mdanderson03/SpectrePlex/README.md

# AutoCIF
Automated Multiplex Microscope
