mdanderson03/SpectrePlex/Presentation/SpectrePlex Cycle Speed.pptx

## SpectrePlex Cycle Speed

## Time per Imaging Action

- Image acquisition time = exposure time + 170ms + 50ms (if change filter)
  - Exp time = exp time
  - Read off time = 85ms
  - Numpy Frame Size Conversion = 85ms (Converts from 1D array to proper XY dimensions)
  - Filter change = 50ms
- Filter change = 50ms
- Move Z position = 50ms
- Move XY position = 300ms
- Auto Exposure = 1 min for 16 tiles

Net Imaging Time per tile (Underestimates about 15%)
- 5 z stack
- Assume average exposure time of 500ms
- Lowest is average exp time = 50ms
- Highest is average exp time = 2000ms
500ms Average Exp (per tile about 0.35mm^2)
[((670 + 50) * 5) + 50] * 4 + 300ms + 4000ms per z stacked tile (all 4 colors) = 18.7 seconds
Lowest Average Exp (per tile)
[((220 + 50) * 5) + 50] * 4 + 300ms + 4000ms per z stacked tile (all 4 colors) = 9.9 seconds
Highest Average Exp (per tile)
[((2170 + 50) * 5) + 50] * 4 + 300ms + 4000ms per z stacked tile (all 4 colors) = 48.9 seconds
If Average Tissue = 16 tissue containing tiles (about 5.6mm^2)
500ms Average Exp (per tile)
16 * 14.7 + 1 min= 5.0 minutes
Lowest Average Exp (per tile)
5.9 * 16 + 1 min = 2.4 minutes
Highest Average Exp (per tile)
44.9 * 16 + 1 min= 13.0 minutes

## Time per Other Actions

- Wash = wash time + 3sec + 2 sec
  - Wash time = 36000/(flow rate in uL/min)
  - Flow rate stabile time = 3 secs
  - Valve select time = 2 seconds
- Stain = flow time + 3sec + 2 sec + incubation time
  - Flow time = 22500/(flow rate in uL/min)
  - Flow rate stabile time = 3 secs
  - Valve select time = 2 seconds
  - Incubation time = 2700 seconds w/o heater, 900 w/ heater
- Bleach = flow time + 3sec + 2 sec + incubation time
  - Flow time = 36000/(flow rate in uL/min)
  - Flow rate stabile time = 3 secs
  - Valve select time = 2 seconds
  - Incubation time = 180 seconds
Total Time per Cycle
- Do 1x Stain, 2x Wash and 1x Bleach per cycle
- W/o heater, stain inc time = 2700, w/ heater inc time = 900
- W/O Heater (46 min + 2*1.25 min + 4.25 min) = 53 min
- W/ Heater (16 min + 2*1.25 + 4.25 min) = 23 min

## Total Time Per Cycle

- I will break into 4 regimes (at avg of 500ms exposure time)
  1. w/o heater and acquire bleached images
  2. w/o heater and rolling ball bckgnd (no bleached images required)
  3. w/ heater and acquire bleached images
  4. w/ heater and rolling ball bckgnd (no bleached images required)
- Each cycle has 1x stained image acq + 1x set of fluidic exchanges + optional 1x bleached image acq
1. 5 min + 4 min + 53 min = 62 minutes
2. 5 min + 53 min = 58 min
3. 5 min + 4 min + 23 min = 32 min
4. 5 min + 23 min = 28 min

## Speed up Ideas

1. Bleach time will go down with heater on. It is untested, but it’s a pure chemical reaction. Going from 16C to 36C should increased bleach speed by 4x. 1 minute incubation time should be the projected bleach time with heater on
2. Sorger lab only does rolling ball background. Maybe it is ok to do that approach? That eliminates 4 minutes. Another option is to find the in focus images of the stained channel while bleaching is going on and only acquire the bleached image in that projected in focus position
3. Up flow rate to max value of 1000uL/min. This would save around 1.5 minutes
4. Test flat field of objective and increase to limit of when its focal plane bend is about 2um. Unknown how much frame size could be increased.
5. Swap to TTL triggered system. Takes lots of optimizing, but imaging can potentially be reduced by around 40-50 seconds for a 4 color, 5 stack, 16 tiles acquisition.
6. Could store numpy arrays in 1D format and convert to 2D while staining. This would save 27 seconds for a 4 color, 5 stack, 16 tiles acquisition.
7. Initial tile bounds may not be optimal. Since I know where tissue is and the size of each tile, I could auto recalculate the surface bounds in such a way to reduced the tile count to its absolute minimum for the desired tissue.

Theoretical Min time per cycle (500ms avg exp time) with bleached images if bolded were implemented heater on and got 15% more imaging area
- 4 min (stain image time) + 19.5 min (fluid and incubation time) + 3 min (bleached image time) = 26.5 min

## Other things to take into account

- 50% stain (S50) is at about 15 minutes. S75 is about 21 minutes
- That means 50% more photons per unit time when acquiring. So 333ms exp time would be needed instead of 500ms. That 170ms savings per image is about 2 minutes collectively between the stained and bleached image cycles for each cycle. Thus, it only took a net of 4 minutes to get the extra stain and not the 6 minutes that it appeared to be at first.
