mdanderson03/SpectrePlex/3D model/version logs and observations/heating element context and design.pptx

Heating element in housing with potting compound encasement

Tissue

Water

Glass Slide (Goal object to be heated)

Wire

Encasement Potting Compound

Goal: minimize distance between magnets and glass slide

Magnet

Magnet

Magnet

3D printed Plastic Housing

Hot melt potting

Link to encasement potting: https://www.mcmaster.com/7563A55/

Polyester base

PTC heating element

Automotive grade adhesive

## Slide 2

Heating element alone

Wire

Hot melt potting

Polyester base

PTC heating element

Automotive grade adhesive
