mdanderson03/SpectrePlex/3D model/version logs and observations/New Design thoughts for upcoming V4.2 design.docx

New Design thoughts

1. Like modular inner chamber design
2. Need something that doesn’t rust so hide or embed magnets
3. Need to restrict movement so some thick nickel based washer will work for socket
4. Embed magnets for pressure plate within plate and chamber and maybe inner chamber
5. Maybe pressure plate could be rim around entire fluidic device
6. Maybe magnets could be embedded into plastic socket and sealed with resin
