mdanderson03/SpectrePlex/Core Jobs.docx

Core Jobs

1. Equipment Trainings
2. Coordinate Trainings
3. Marking accounts as trained
4. Billing Program
5. Email correspondence with requests and advice/consultation/etc.
6. Refill consumables for microscopes (oil, wipes)
7. Delete files from LSM workstation
8. Coordinate repairs with service teams from Zeiss and Abberior
9. Website upgrades
10. ID card submission to lock shop

How to do Tasks

ID card submission

a) Enders 613-email Doug Ritchie at doug.ritchie@childrens.harvard.edu with the users name, ID number and badge number. I have all users fillout this form: https://research.childrenshospital.org/cfic-core/request-accesstraining
b) Enders 648: Same as above, but email Security.AccessControl@childrens.harvard.edu instead. Same form is used.

File deletion

Every file in drive E on LSM workstation is subject to deletion if it is over 30 days old.

Billing Program

Use python based CFIC billing program on raw CSV file from iLab that Alia generates. Upload processed folder into CFIC dropbox. Alia takes care of rest.

Consumables/Maintenance

1. Refill lens wipes and kim wipes for LSM 880, spinning disk and STEDYCON.
2. Refill sparkle on LSM 880, spinning disk and STEDYCON. Note we are out of sparkle and a case of new lens cleaner from Edmunds optics will be in soon.
3. Inspect LSM 63x and 10x objectives. Clean if needed.
4. Remove dust if becoming significant

Website Upgrades

Make website a place for all info and useful with live links. As of now, no distinct plan for material is set in place.

Mark account

Marco and Ali both email me who needs to be marked as trained in iLab. Search engine is typically very bad and I edit the equipment page, go to permission section and enter the users name in search bar there. Much much more reliable.

Coordinate repairs.

For zeiss, cell US optics customer service number and ask to make repair ticket. Typically Peter Frey is assigned to us.

For Abberior, email Karsten Bahlmann.

Coordinate Trainings

Email with users until day and times that work for both of us are reached.

Training

My main area here is LSM 880 trainings. Here is a breakdown of the major points I hit.

1. How to power on
2. Move microscope condenser arm back to demonstrate movement.
  a. Have users each move back and pull towards until upright to make sure they get a feel for it.
  b. Tell user that if it isn’t forward, the laser will not turn on and its finicky
  c. Say if error come up saying UV-Vis timeout >10sec, then it is 100% that the condenser arm is not fully upright.
3. How to swap insert. Points of emphasis below:
  a. Slide insert is base insert and should be swapped back to
  b. Lower objective using load sample and set work buttons on touch screen unit
  c. Spread wings apart on insert so neither are over objective when placing into stage
  d. Tighten until just barely snug. No need to crank much.
4. Oil objective
  a. Let users see how little oil is on dip stick
  b. Show I only oil up flat part of top of objective
  c. Say if put too much oil on, take a lens wipe and try again. Oil is cheap, oil build up is not.
  d. Load on slide
5. Location navigation
  a. Hit fluorescence button in navigation menu to open up fluorescence shutter.
  b. Click colibri-LEDs on touch screen unit (TSU)
  c. Explain this is not confocal. It is widefield and we cannot record anything we do with it. Its location sample only
  d. 4 LEDs and each can be turned on individually.
6. Acquire Tab
  a. Go to folder icon and load in template.
  b. I use airy scan with 4 wavlengths and frame switch for normal airy template
  c. Fast 4 wavelengths and frame switch for fast air scan
  d. Wait 5 minutes for argon to warm up. Point out red box on wavelength
7. Parameters
  a. Adjust 5 parameters
  b. 1 = zoom. I say this is FOV
  c. 2 = frame size. I say this is pixel sampling grid
  d. 3 = laser power for individual channel. I say this is image quality
  e. 4 – master gain. I say this is dynamic range. Emphasize that it does not influence the image quality. Rule of thumb in 16bit space is for tail of histogram to be at 10-15%.
  f. 5 = scanner speed. I always make = fastest
  g. Bonus! Align airy beam. (go to low frame size, hit continuous and wait for it to say its good)
  h. Note, frame size manually updates. Demo unchecking dapi and click optimal to update it.
8. Fast Airy
  a. Go to proper template
  b. Explain laser reshaping into oval profile and power density goes down
  c. Point to new frame size look. It now auto updates and we can select an Nyquist factor to ‘lock’ it in
  d. Laser power now looks different. Left is absolute laser power. Right is equivalent to previous mode power
  e. Same process of tuning each channel with laser power and gain. Note we are in 8 bit space now so I now place the tail at 40%.
  f. Also note that normal airy can be processed in black and blue, but fast airy can only be processed in black.
9. Z stack
  a. Demo z stack.
  b. Make sure to set a bound with last first and first bound last. Explain zen does not care if one is actually set first or last. Just make sure that they are opposite bounds.
  c. Processing will take longer on this one. While processing move into next section
10. Golden Rules
  a. Explain the golden rules of zen.
  b. 1. Never try to acquire image while it is actively processing. It will crash.
  c. 2. Never try to acquire image while it is actively saving. It will crash.
11. Shutdown
12. Tile
  a. Demo center tile
  b. Move to zen blue and stitch
13. Saving
  a. Save on workstation data drive 1
  b. Explain CFIC on site storage and the CFIC SMB drive
  c. Explain zen is full and free on workstation, but make sure to reserve time.
  d. Aivia is available as well, but it is paid for. Explain what it is.
14. Normal pipeline
  a. Explain how I normally do things.
  b. I acquire images on microscope, save to workstation and later date or time process them.
15. Shut down
  a. Turn lasers off, wait 5 minutes. Most background noise is argon laser cooler.
  b. Turn computer off. Wait until monitor power icon turns orange.
  c. Flip switches.
  d. Point to power down explanation paper just in case forget
  e. Mention I shut it down for training, but check calendar and leave on if user in within 1 hour of yourself.
  f. Emphasize the power down. Say disk drives forget themselves if it is not followed.
