mdanderson03/SpectrePlex/ElveFlow SDK Applied to Python.docx

ElveFlow SDK Applied to Python

Overview

My end point function will 1. Change valve, 2. Change flow rate. That’s it. The SDK interface from Elveflow supplies capabilities that can lead to these functions, but lack any python objects to accomplish it out of the box. Their basis of operation is to:

1. Establish connection to devices
2. Set up things such as calibration array and PI feedback loop (ie. flow rate sensor, pressure feedback to set flow rate)
3. Dictate set points
4. Stop PI loop
5. End communication

As the Elveflow system will be scripted and tested, the script will crash sometimes during testing and make steps 4 and 5 unreliable to get to. For the time being, I plan to skip them unless it ruins operation.

Here is the approach with a python implementation

1. Make init function for class Fluidics does the following:
  a) Establishes connection to both MUX and OB1 units
  b) Adds in calibration array to OB1
  c) Adds in flow sensor
  d) Starts PI loop
2. Have two base methods
  a) Flow method changes flow rate.
  b) Valve change method changes which valve MUX in on
3. Have one higher level method that chains together flow rate changes and valve changes to accomplish exact goals of system.

How was it done in real code?

The init function

def __init__(self, mux_com_port, ob1_com_port):

# OB1 initialize
ob1_path = 'ASRL' + str(ob1_com_port) + '::INSTR'
Instr_ID = c_int32()
pump = OB1_Initialization(ob1_path.encode('ascii'), 0, 0, 0, 0, byref(Instr_ID))
pump = OB1_Add_Sens(Instr_ID, 1, 5, 1, 0, 7,
0) # 16bit working range between 0-1000uL/min, also what are CustomSens_Voltage_5_to_25 and can I really choose any digital range?

Calib_path = r'C:\Users\CyCIF PC\Documents\GitHub\AutoCIF\Python_64_elveflow\calibration\1_12_24_cal.txt'
Calib = (c_double * 1000)()
Elveflow_Calibration_Load(Calib_path.encode('ascii'), byref(Calib), 1000)
#Elveflow_Calibration_Default(byref(Calib), 1000)
OB1_Start_Remote_Measurement(Instr_ID.value, byref(Calib), 1000)
self.calibration_array = byref(Calib)

set_channel_regulator = int(1) # convert to int
set_channel_regulator = c_int32(set_channel_regulator) # convert to c_int32
set_channel_sensor = int(1)
set_channel_sensor = c_int32(set_channel_sensor) # convert to c_int32
PID_Add_Remote(Instr_ID.value, set_channel_regulator, Instr_ID.value, set_channel_sensor, 0.9, 0.004, 1)

# MUX intiialize
path = 'ASRL' + str(mux_com_port) + '::INSTR'
mux_Instr_ID = c_int32()
MUX_DRI_Initialization(path.encode('ascii'), byref(
mux_Instr_ID)) # choose the COM port, it can be ASRLXXX::INSTR (where XXX=port number)

# home
# answer = (c_char * 40)()
self.mux_ID = mux_Instr_ID.value
# MUX_DRI_Send_Command(self.mux_ID, 0, answer, 40)

self.pump_ID = Instr_ID.value

return

Flow function

def flow(self, flow_rate):

set_channel = int(1) # convert to int
set_channel = c_int32(set_channel) # convert to c_int32

set_target = float(flow_rate) # in uL/min for flow
set_target = c_double(set_target) # convert to c_double

# OB1_Start_Remote_Measurement(self.pump_ID, self.calibration_array, 1000)
OB1_Set_Remote_Target(self.pump_ID, set_channel, set_target)

data_sens = c_double()
data_reg = c_double()
set_channel = int(1) # convert to int
set_channel = c_int32(set_channel) # convert to c_int32
time.sleep(3)
error = OB1_Get_Remote_Data(self.pump_ID, set_channel, byref(data_reg), byref(data_sens))
current_flow_rate = data_sens.value
current_pressure = int(data_reg.value)
print('current flow rate', int(current_flow_rate))
print('error: ', error)

Valve change function

def valve_select(self, valve_number):
'''
Selects valve in mux unit with associated mux_id to the valve_number declared.
:param c_int32 mux_id: mux_id given from mux_initialization method
:param int valve_number: number of desired valve to be selected
:return: Nothing
'''

desired_valve = valve_number
valve_number = c_int32(valve_number)
MUX_DRI_Set_Valve(self.mux_ID, valve_number, 0) # 0 is shortest path. clockwise and cc are also options

valve = c_int32(-1)
MUX_DRI_Get_Valve(self.mux_ID, byref(valve))
current_valve = int(valve.value)

while current_valve != desired_valve:
MUX_DRI_Get_Valve(self.mux_ID, byref(valve))
current_valve = int(valve.value)
# print('valve', current_valve, 'deired valve', desired_valve)
time.sleep(1)

time.sleep(1)
