mdanderson03/SpectrePlex/Presentation/cluster_labelling.pptx

## Cluster labeling and Isolation

## Cluster Filtering

- Wastes time and storage space to image areas with no tissue.
- Segmenting nuclei and dilating creates a binary map of tissue
- It also will sporadically create non tissue based clusters which need filtered out
- Approach: take X seed clusters and any cluster greater than 10% of the area of the smallest cluster

Unfiltered

Filtered

Filtered + Labelled

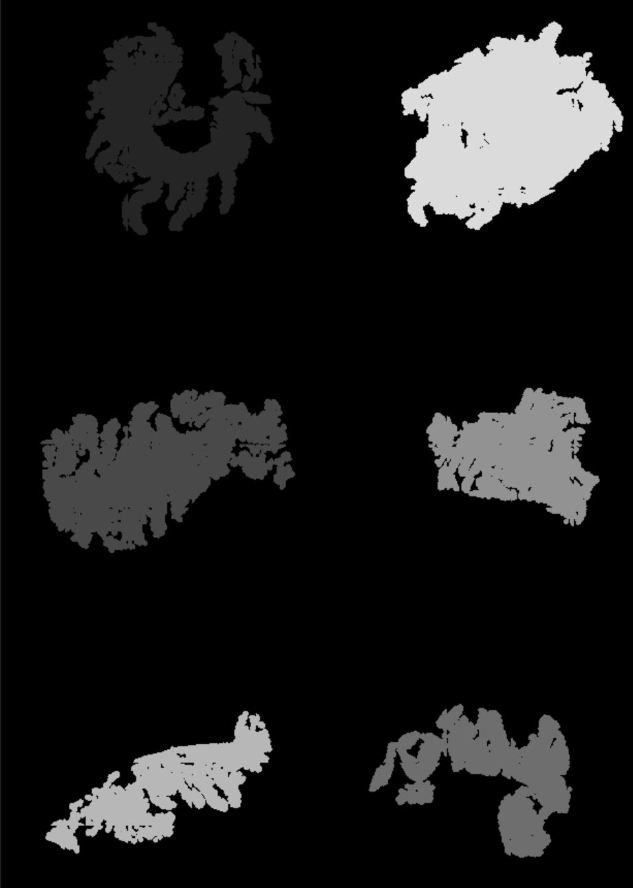
[picture p10: figure]
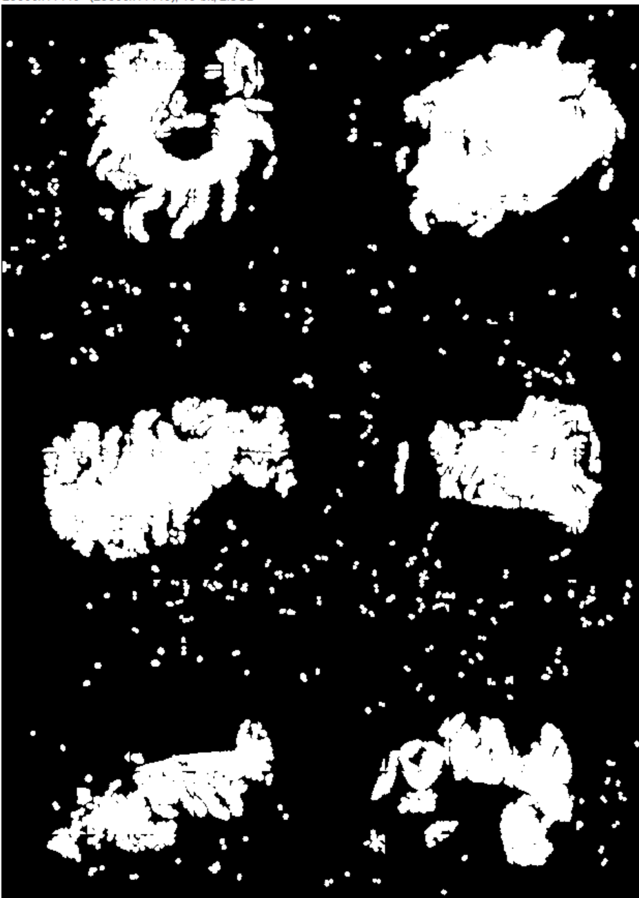
[picture p11: figure]
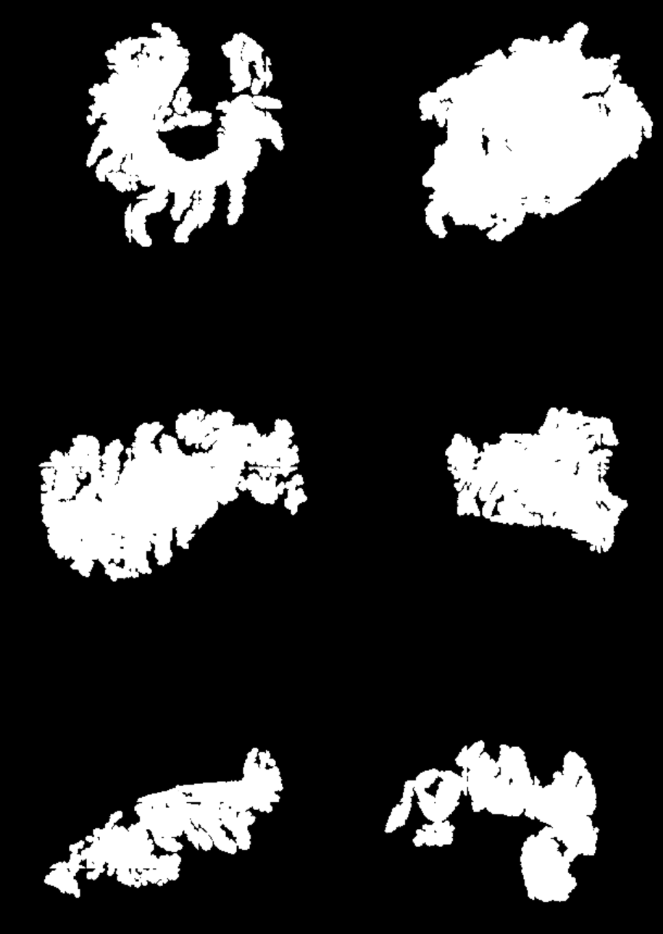
[picture p12: figure]

## Encoding For Cluster Label

Encode

∑_i 10^i =10^6 +10^0 =1000001=tissue code

Decode

1. ⌊ log_10 tissue code⌋ = first label
2. Tissue code - ⌊ log_10 tissue code⌋
3. ⌊ log_10 tissue code⌋ = second label
4. Repeat until tissue code = 0

- Encoding what labels occur in a tile enables each and every TMA to be sequestered into separate tiff stacks in a memory efficient manner.
- Stored in top layer of fm_array
