mdanderson03/SpectrePlex/Presentation/Commercial Prototype Production.pptx

## Commercial Prototype Production

## Engineering Goals

1. Fit into standard multiwell plate cutout in stage
2. Be thin and mostly exist below grade
3. All slide mounting and priming is done outside of chamber and slide complex is placed into chamber for imaging.
4. Slide complex goal is to be only marginally larger than slide itself
5. Regularize fluidic device production
6. Fuse fluidic device and pressure plate into one item
7. Easy fluidic connection for users, ie quick connect.
8. Add in corner screws for leveling
9. Decently aesthetic design
10. Make modular
  a. Temp reg
  b. Multislides
  c. 3D domes

## Device forming and Priming

- The first task is split into two areas
  - Can we use a form for the fluidic device uppers?
  - Can it be primed by hand while sealed?
- Its is unknown if an SLA printed upper form to make more complex shapes would be possible. Lets make some sample ones and trial it.
- Rough goals of form:
  1. 1mm thick around window
  2. Need window block
  3. Thicken height in port region
  4. Make edges more exact

## Slide 4

- Maybe ss 17-4 ph from protolabs

## Heart of Device: The Fluidic Sandwich

- To balance engineering complexity and user ease, we have opted to create a fluidic sandwich exterior to the chamber which can then be placed into chamber on stage
- Constraints
  1. No complex joints like slides, hinges, spring assemblies (can be complete units though).
  2. Width of slide, but can be longer than slide
  3. As thin as possible
  4. Fluidic connections baked into pressure plate + fludic device combo
  5. Fluidic device and pressure plate are integrated together, but able to be separated if needed
  6. ‘fool proof’ jig placements
  7. All parts able to be CNCed
  8. Freedom to choose along long slide axis for device placement

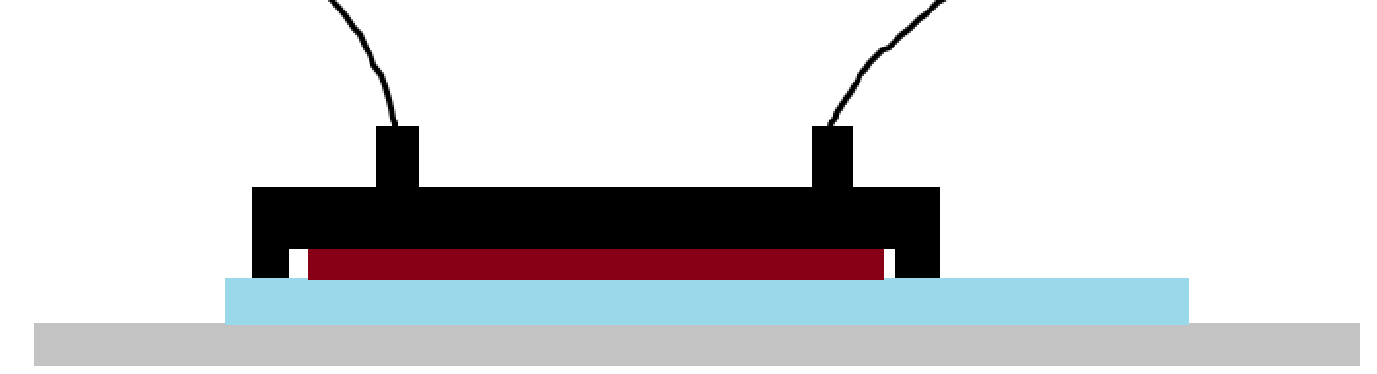
[picture p13: figure]

Pressure Plate

Fluidic Device

Where magnets are

Slide

Stainless Steel

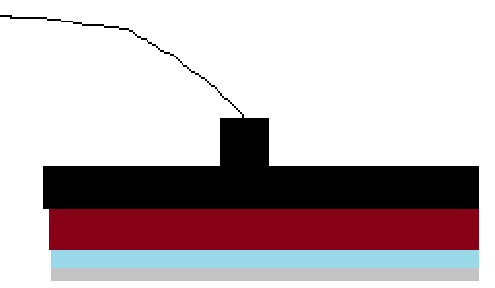
[picture p14: figure]

## Key Changes from Current Model

1. By placing magnets only on ends, it enabled the width to be that of the slide or just slightly larger
2. To make a compact moveable sandwich, the bottom has to be a plate. Currently we have embedded magnets encased in resin. This leads to 2 issues. Thicker and need exact placement. Going to SS, the specificity goes away, its simpler and thinner
3. Fluidic device and PP are integrated and integrated with fluidics

## Key Risks

1. Can magnets on just the ends give enough force to seal?
2. The reduced B field from mags being over the slide and not off to the side and from SS instead of another mag. Will it be enough to seal?

## Cassette style insert

1. Insert both yellow rail guide and the orange brace to hold the stainless steel plate in place and then start the pressure plate complex on the rails

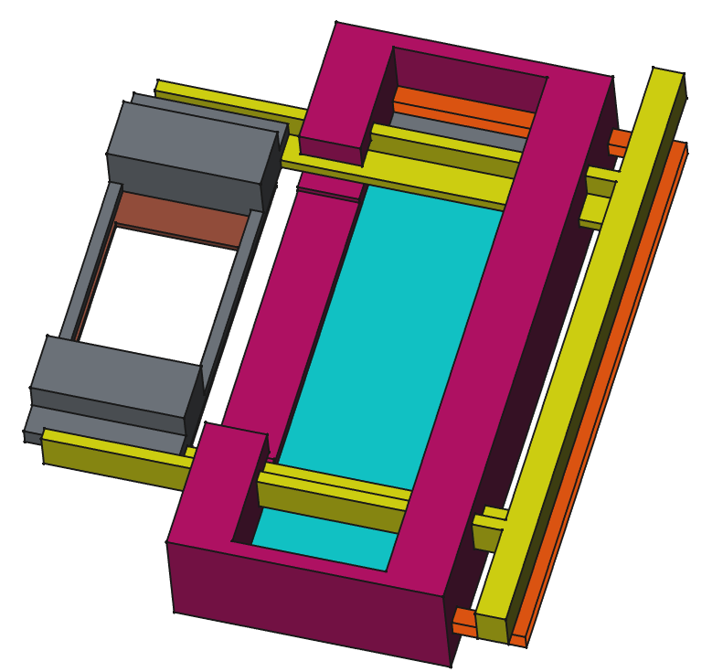
[picture p15: figure]

2. Shift the pressure plate complex all the way to the end

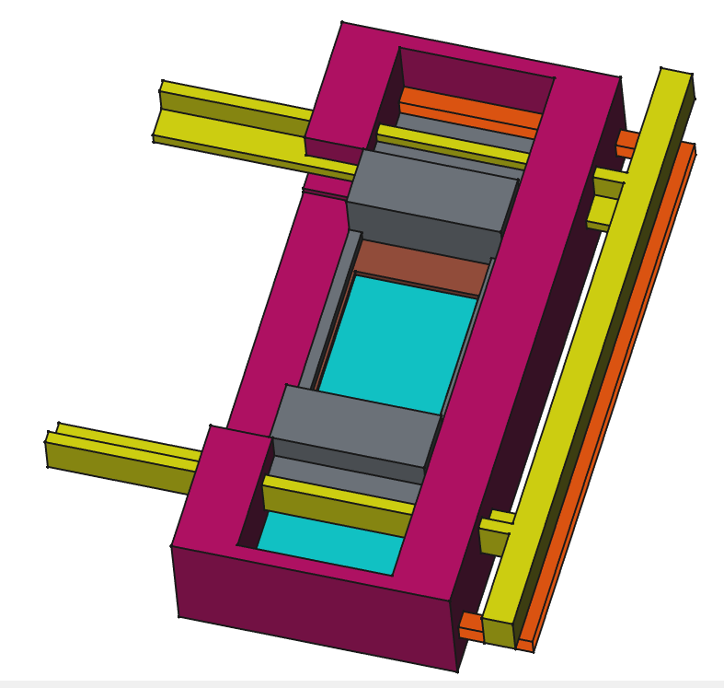
[picture p16: figure]

## Slide 9

3. (front view) start fluid flow (not shown)

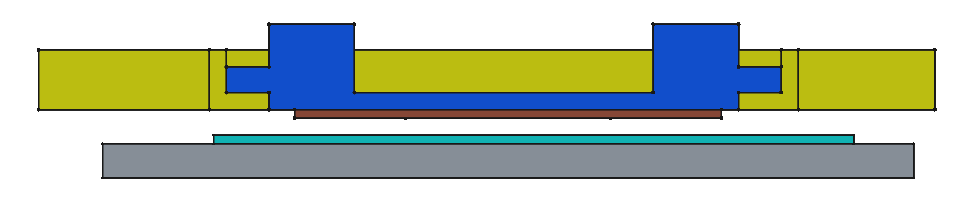
[picture p17: figure]

4. While flowing, pull yellow guide rail track out

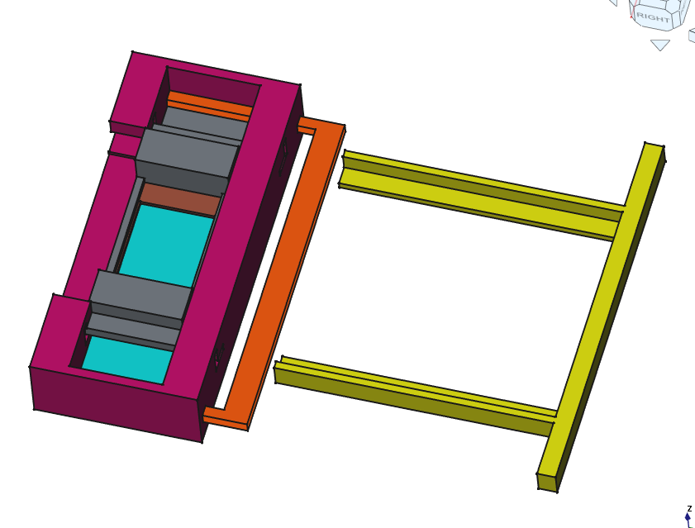
[picture p18: figure]

5. (front view) pressure plate complex and slide will seal together

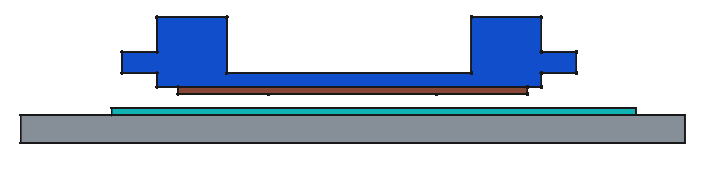
[picture p19: figure]

## Slide 10

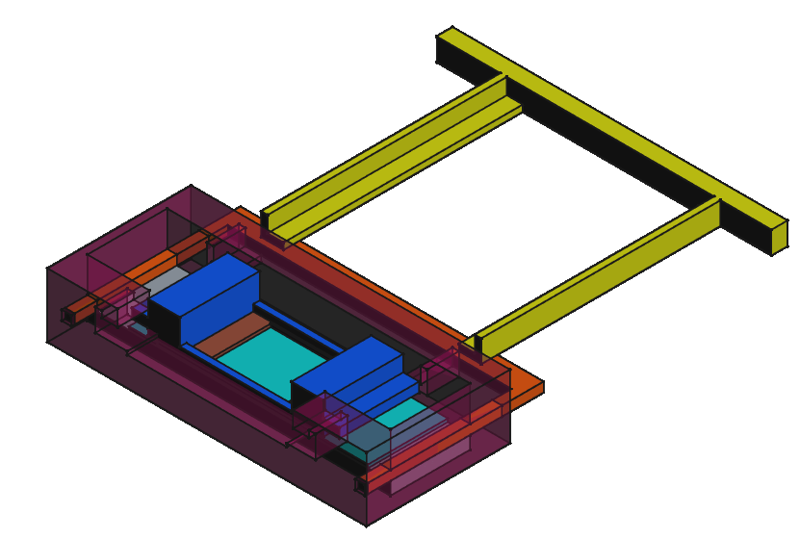
[picture p20: figure]

5. Same as previous step, but angled perspective view

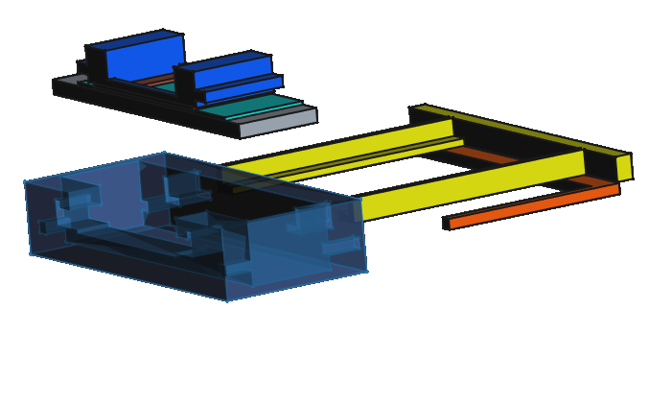
[picture p21: figure]

6. Pull out orange device and pull up on sandwich complex to remove from jig

## Threads

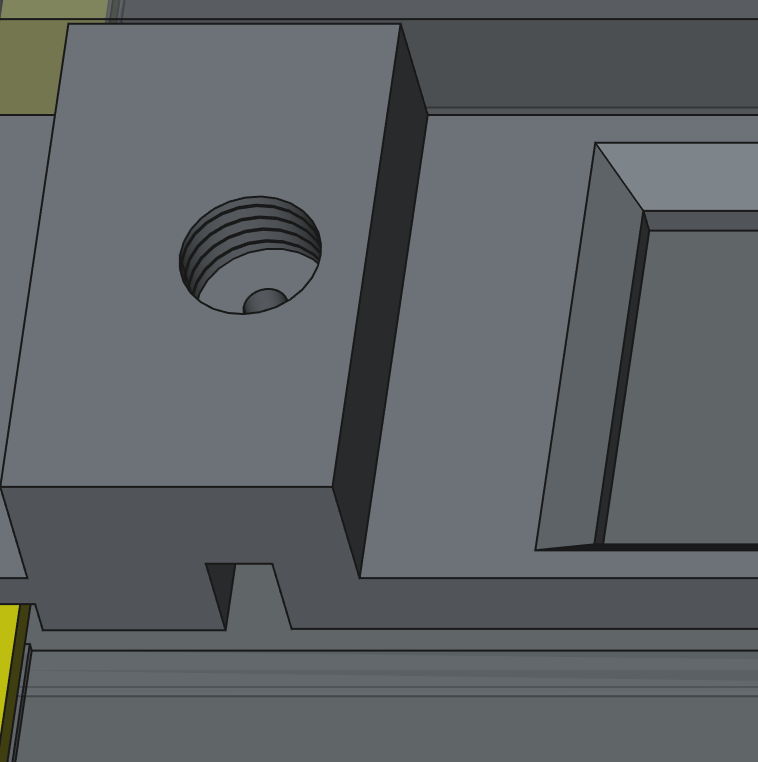
[picture p22: figure]

- Microfludic connectors are ¼ inch-28 connectors. This is 1/4inch, fine UNF threads (28 threads per inch)

## Unified Slide Design

- Merged the two slides into one. This contains both the rail slides and a built-in spacer to pin the slide/SS plate down and maintain a gap between the fluidic device and slide.

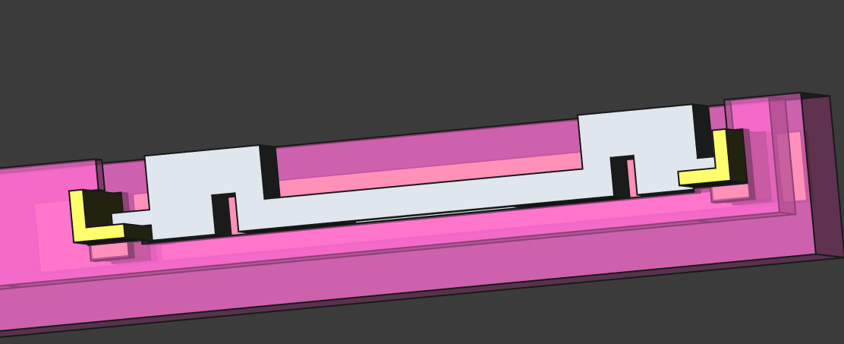
[picture p23: figure]
