mdanderson03/SpectrePlex/Presentation/PEG Fluid Concentration.pptx

## PEG Fluid Concentration

## Idea

- Was told by reliable source that PEG in antibody solution can increase effective concentration of antibodies
- Idea is PEG occupies volume while maintaining volume which forces the antibody component to interact with a smaller portion of liquid, thus increasing its effective concentration.

## PEG [C] in solution

[C] w/v | %vol change
10% | 10%
20% | 20%
40% | 35%

%vol change is measured by dissolving PEG into pure water and observing the vol before and after dissolving.

## Flowing PEG solutions

Solution | Pressure (mBar) | Flow rate (uL/min)
Water | 500 | 400
10% PEG | 1900 | 350
20% PEG | 1900 | 250

Given that pressure and viscosity are both directly proportional to flow rate, this implies that 5% PEG is about 4.5x more viscous and about 6x for 10% PEG

## Slide 5
