mdanderson03/SpectrePlex/Notes/20-11-23 notes.pptx

## 20-11-23 notes

## Focus

- Only muc 2 actually stained so the rest are just evaluating focus on the autofluorescence in the sample

1. What slice is DAPi focused at and does it vary? Slice 6 and no it does not vary.
2. What slices are the rest of the colors focused at? 488 = slice 6, consistent. A555 = slice 6, consistent, A647 = slice 7, consistent, but maybe closer to slice 8.
3. Any drift in DAPI? Cycle 1 = slice 6, cycle 3 = slice 6 so minimal drift
4. Does slice change between cy1 and 3 for 488? Yes. Cy1 = slice 6, cy3 = slice 7

## Illumination

- Very even and difficult to discern illumination alterations at tile borders.

## Leaks

- No leaks detected. On next day pumped PBS through chamber and flowed through nicely.

## Needed Changes

1. Why aren’t things staining? Running manual stain now to see if takes into slide from the same batch
2. Make DAPI slice go to middle of stack. Why at slice 6 of 7? Should have been at 5.
