mdanderson03/SpectrePlex/Presentation/Analyze 17-10-23 Dataset.pptx

## Analyze 17-10-23 Dataset

## Things to determine

1. Does DAPI drift over time?
2. What is DAPI to other 3 channel offsets? What magnitude does it modulate over cycles?
3. How large do stacks need to be to capture everything?
4. Are stacks currently centered around best focus plane? At least in the start?
5. Was stack sufficient to compensate for slight tilt in stage?
6. Does focus change enough to need to two images for a single FOV?

## What is needed to analyze?

1. Numpy data structure to record all focus planes for tiled structured. For instance layer 1 are DAPI, 2 A488, … With 2D array within that points to each tile.

## Slide 4

- Minimal drift DAPi
- Confirmed range with respect to DAPI for A647 = 4um
