mdanderson03/SpectrePlex/Presentation/AutoCyPlex Software Road Map.pptx

## AutoCyPlex Software Road Map

## Two types of upgrades

Breakdown of needed functions. Two categories. One is needed to function better or correctly, the other is to function more intuitively.

Functionality
1. Core capture in ZC XY(snake) order
2. Save ZC stacks properly
3. Update focus map without rebuilding from micromagellan
4. Add in ‘prime’ ability to Lumencor Light engine to wake it up.
5. Make prime reservoir function
6. Functional marker excel file
7. Functional auto exposure
8. Functional auto focus

Intuition
1. Single line cycle execution
2. GUI

## GUI Sample Look

Cycle Count/Stain Valves

Cycle Count __4__

Cycle 1 Valve __4__

Cycle 2 Valve __5__

Cycle 3 Valve __6__

Cycle 4 Valve __7__

Heater State for Stains

Off

On

Pump COM 6

Com Ports

MQTT Server

Server Address ____

Type in ___

Experiment Directory

Click here to Browse Instead

Start PBS Flow

Stop PBS Flow

Abort All

Live Feed of Current Status.
Such as what cycle on, what doing in cycle, how long into stain, etc.

Start Acquisition

Auto Expose

Auto expose parameter 1 ___

Auto expose parameter 2 ___

DAPI offset ___

A488 offset ___

A555 offset ___

A647 offset ___

Number Z slices ___

Use Auto Focus (Overrides Above)
