mdanderson03/SpectrePlex/Presentation/Eppendorf Holder V3.pptx

## Eppendorf Holder V3.0

## Goals

1. Hold 10 eppendorfs
2. Bracket around the top of the Eppendorf coupler to brace it so the user just screws into it without needing to manipulate tubings.
3. Be at about a 45 angle for easy access and labeling that can be read.

## Slide 3
