mdanderson03/SpectrePlex/Presentation/Illuminatin Source Calculations.pptx

## Illuminatin Source Calculations

## Generalized Kohler Illumination and ASI specific Setup

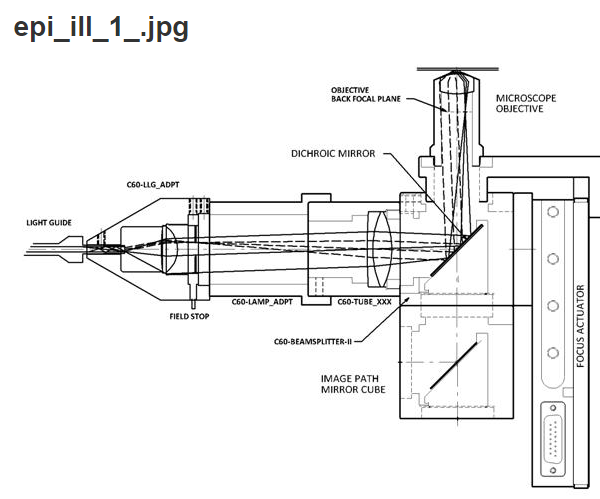
[picture p30: figure]

- Note Aperture Stop is at objective back focal plane and is pupil size in ASI construction
- Pupil size is 20mm for Nikon 16x 0.8NA water dipper

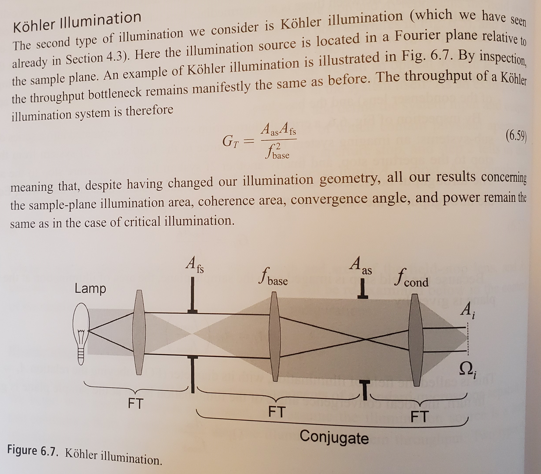
[picture p31: figure]

## Illumination Source sufficient for System?

- Look at throughput of system and etendue of illumination source. Need throughput of system to exceed etendue of illumination source

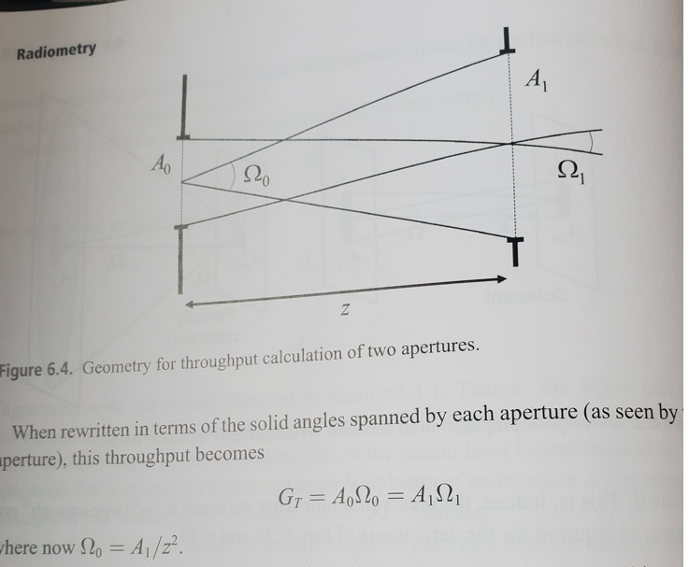
[picture p32: figure]

## Calculation

- LED from ASI is LXM2-PD01-0050
- According to Luxeon, its 1mm^2 for area
- 125 degrees is angle at which intensity is at 50%

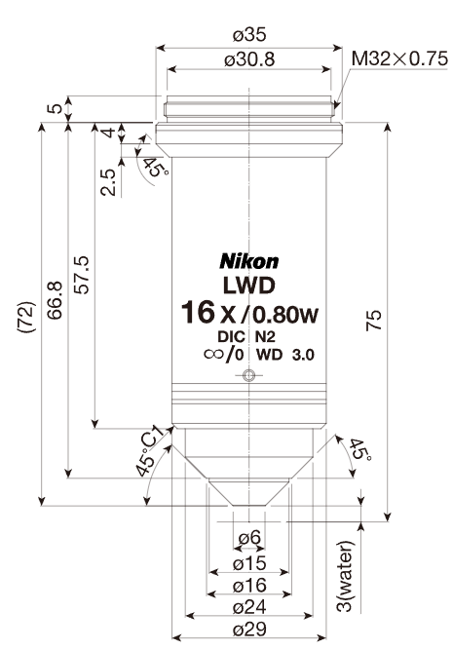
[picture p33: figure]

## Slide 5
