mdanderson03/SpectrePlex/Presentation/modulate pH and temp kinetics.pptx

## 1-16-2024 and 2-20-2024 Kinetics pH modulate and Temp

## Reagents

- 2 buffers were used
- Tris-HCl buffer: pH 7.8, 8.3, 9.0 (100mM strength modulated to 150mM ionic strength via NaCl and HCl to modulate pH)
- Citrate-Phosphate buffer: pH 5.0 and 7.0 (100mM strength, blended close to desired points and finished off with NaOH. No NaCl added as both pHs were very close to 150mM as is for ionic strength).
- Used program called BufferMaker to determine exact ionic strength for both buffers
- 0.1% triton X 100 (by volume) added to each buffer as well
- 1:1k dilution SMA-A488, 1:500 MUC2-A647
- 1-16-2024 = pH modulate experiments (pH 5,7,7.8, 8.3, 9)
- 2-20-2024 = temp modulate (pH 7)

## Protocol

1. Load slide into SpectrePlex
2. Find tissue and focus on autofluorescence in A488 channel
3. Load vial into Elveflow fluidics system
4. Run kinetics python program which in brief does (each loop is timed so its actually 2 min between images:
  1. Take pre stain image (DAPI already on) in each channel
  2. Flow stain onto slide
  3. Focus on DAPI, spread to other channels via known offsets as auto focus
  4. Take images
  5. Repeat steps 3 and 4 every 2 minutes for 90 minutes
  6. Fluidic system washes off stain and replaces with PBS
  7. Image post wash with each channel
5. Analyze Kinetics
  1. For stain mask by Otsu thresholding (post wash image) – (auto fluorescence image)
  2. Star dist segments nuclei and use disk footprint of 70 to dilate it out to make tissue mask
  3. Non antigen mask is in verse stain mask * tissue mask
  4. Slide mask is inverse tissue mask
  5. Take average per pixel (kinetic stack – auto fluorescence) * stain mask
  6. Zero out to normalize at time = 0
  7. Plot average per pixel vs time for staining kinetics
  8. Fit with plateau (1- exp(-k*time)) model equation and find half time

## Notes

- Used healthy tissue
- For heater experiment, same exact antibodies, and pH 7.0 buffer were used. Later date though and slightly different illumination setup than the pH modulation part. Pre heated to 32C and finished experiment at 36C as measured with infrared thermometer in window opening.
- Heater is an embedded custom device that drives to 60C, but cannot putout enough heat o achieve that so it constantly runs and typically planes out around mid to upper 30s Celsius
- Room temp was 16C (that counts for all pH experiments as well)
- Fixed exposure times of 200ms for A488 and 75ms for A647. 90% light power for each with a spectra III from lumencor.
