mdanderson03/SpectrePlex/3D model/Technical Drawings/Views_technical_drawings V5.1.pptx

- Overall system blow up CAD drawing
- Annotate everything well in chamber
- Use heating element model
- Annotated diagrams/images for each claim point in application
- By April 25th

## Slide 2

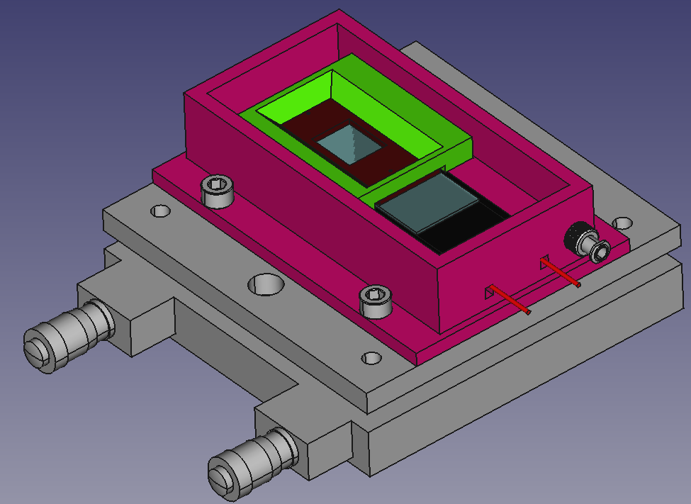
[picture p37: figure]

## Slide 3

Water Dipping Objective

Iron-Oxide Embedded Polydimethylsiloxane (PDMS)

Anodized Al Pressure Plate

Tubing

Water

Fluorinated ethylene propylene (FEP) Film

Tissue

Maxi-Black Anti-Reflective Material

Neodymium Magnets

Hard Set Potting Epoxy

Positive Temperature Coefficient (PTC) heater

Slide Glass

3D printed Chamber

## Slide 4

## Slide 5

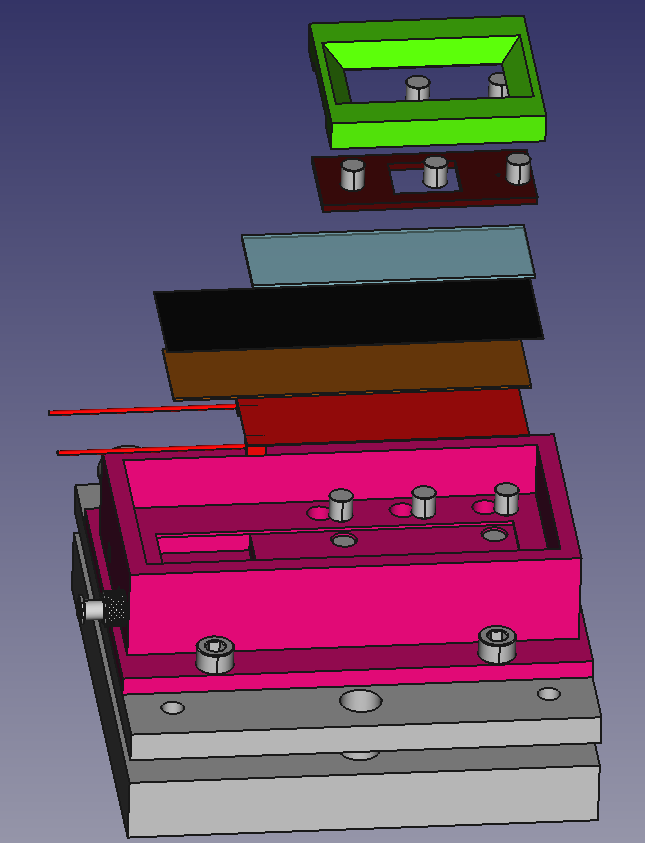
[picture p38: figure]

3D Printed Pressure Plate

Pressure Plate Embedded Magnets

Invisi-Slip Fluidic Device

Glass Slide

Maxi-Black Antireflective Material

Positive Temperature Coefficient (PTC) Heating Element

Hard Setting Potting Compound

Pressure Plate Chamber Mount Magnetics

Fluidic Device Stabilization Magnets

3D printed Chamber

M6 Mounting Machine Screws

Tilt Stage
