mdanderson03/SpectrePlex/3D model/version logs and observations/Chamber V5.pptx

## Chamber V5.0 guidelines

## Features

- SLA printed
- Thin as possible
- Water level sensor
- Deep reservoir
- Magnets under slide to stabilize fluidic device
- Magnets under pressure plate to generate sealing force
- Make magnets reverse polarity between slide and pressure plate magnets
- No direct water contact with magnets
- Thin film heating element
- Slide contact surface is aluminum plate to conduct heat well and be flat (element is thermally adhered to this w grease)
- 4 sockets to attach to stage with
- Thin out pressure plate and make thicker in areas to contain magnets

## Water Level

- Multilevel sensor
- https://www.newark.com/seeed-studio/101020635/water-level-sensor-board-arduino/dp/42AK5700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|pcrid||plid||kword||match||slid||product|42AK5700|pgrid||ptaid||&CMP=KNC-GUSA-PMAX-Shopping-High-ROAS

## Slide 4

## Slide 5
