mdanderson03/SpectrePlex/3D model/version logs and observations/Pressure Calculations for AutoCIF Micro-Fluidic Device.pptx

## Pressure Calculations for AutoCIF Micro-Fluidic Device

## Microfluidic Chip AutoCIF

- Use window dimensions from GeoMx® Digital Spatial Profiler
- Use extended channels as port canals to move ports away from window.
- Main chamber slightly narrows to encourage bubbles to not stick
- Ports funnel, remove sharp transitions and have rounded backs

## Block Hydraulic Resistant Diagram

ID: 500um, L:20cm

R1 =0.02

ID: 500um, L:100cm

R2 =.11

ID: 500um, L:200cm

R3 =.22

ID: 500um, L:50cm

R4 =0.05

ID: 1600um, L:1000cm

R5 =0.01

Fluidic Chip

Resistance Units = [torr*min/uL]

R_Cell =0.01

## Equivalent Component Model

- Pressure = Voltage
- Flow Rate = Current
- Tubing and Chambers Hydraulic resistance = resistors

## Peristaltic Pump Equivalent

- While true, they are not perfect flow generators. If backpressure is low as compared to max pressure, then it is approximately a constant flow rate generator.
- Given knowledge of absolute flow rates are not imperative in this operation, a 1st order approx. is valid
- Peristaltic pump equivalent electrical component is thus a constant current source PSU.

## Calculating Approximate PSI Max on pump

- At 3200uL/min is about 1200 RPM
- We currently run at 12V
- Running Torque is then 0.06Nm
- Drive axle = 5mm
- Pump head = 23mm
- Assuming friction and tube compression eat up 50% of the theoretical max torque and starting torque is 50% lower than stopping torque. Max torque = 0.015Nm
- Max force at tubing = 1.3N
- Back pressure force = Back_Psi*CSA(0.007) = .0014*back_psi N
- Max back pressure force = 1000psi
- Max psi on tygon 1/16 tubing = 145psi
- Max psi bubble trap = 30 psi
- Seems a lot high even though it makes sense.

## Electrical Equivalent Circuit

- At 3.2mL/min flow rate, peak system pressure = 1344 torr and chamber peak pressure = 64 torr
- At 1mL/min flow rate, peak system pressure = 420 torr and chamber peak pressure = 20 torr

## Other performance features

- Tubing volume = 73uL. Chamber volume = 71uL. Lag time of type of fluid exchange is 144/3200 = 2.7 seconds
- Tubing volume = 73uL. Chamber volume = 71uL. Lag time of type of fluid exchange is 144/1000 = 8.64 seconds
- Peak pressure on pump at 3200uL/min = 26 PSI.
