mdanderson03/SpectrePlex/Presentation/Compressing Folder Sets.pptx

## Compressing Folder Sets

## Example Case: Casey Slide 1-21-25

- Original size = 131gb
- 3 z-stacks and HDR inspired auto exposure
- 12 tiles, 8 cycles (9 with autofluorescence)
- Deletion: all 3 z stacks (keep infocus ones aka focus folder), basic folder, basic_df, stage placed images, nuclear binary, tissue binary (retain only labelled tissue image).
- Compressed w/ zlib: focused images, bleached images, mcmicro files

## Size Drop Going from 3 stack to single FOV.

- Original: 131gb
- After deletion of stained 3 stack for stain: 89gb
- Bleached 3 stack to 1 stack = 14.5gb

## After different actions

- Space saved deleting basic and basic_df folders for each color and cycle = 26gb
- Saved compressing single plane stain and bleach only images = 13gb
- Compress data structures and delete quicktile = 3.5gb

## Overall Folder Size Reduction

- Start with 3 stack to single stack and all above reductions = 131gb to 25gb, 19% original size
- 0.23gb*tiles*(cycles + 1)= final folder size; +1 is autofluorescence
- 50 tile dataset ala GutAge = 126gb

## Overall
