mdanderson03/SpectrePlex/Presentation/pSAM.pptx

## pSAM

## Notes

- However, averaging intensity across all image pixels that fall within a cell mask loses potentially valuable information provided by signal localization within a cell

## Questions

1. Why no annotation tools like paint and define known cell types by using binary (or semi binary, 0,0.5,1) condition for stain in excel sheet? In actual samples variations will exist in staining intensity exist cell to cell. Is this variation just absorbed into the overlap term? Would taking that into account increase accuracy?
2. NA of 40x objective on dragonfly? ()
3. How is data converted to (0-1) range for spectral comparisons? Do we do it or does the program? How does it do it if it’s the program? What about high intensity aggregates? Do they destroy the scale? Might be not relevant due to using confocal system.
4. What made you want to classify cells by compartment and not combine different compartments into one cell classification? Or make a 2 layer class system (spectra and spatial)
5. To blur a mask is convolving it with a gaussian kernal to expand it out while giving some grey levels and not just 0,1 values? Effectively add gaussian roll off to mask border edges? (true decay values)
6. Gaussian blurred masks with proximity scores are effectively a form of neighbor analysis, right?

## Conditioning Data

1. Acquire all images
2. Use ashlar to fuse with the first cycle being #0 (autofluorescence)
3. Subtract autofluorescence from each corresponding channel from each cycle
4. Divide each channel by the std dev of corresponding autofluorescence image (all tiles combined)
5. Min max images to 99%ile for relative scale

## Future?

- While enticing and theoretically powerful for channel (spectral) based classification in a non-AI approach (I see this as a big perk as it can more trusted and understood), seems to have weakness in spatial distributions within cells. This is overcome via the compartment metric, but even that isn’t combined into one score.
- Is it possible to combine into a dual layer vector approach where two spectral vectors are used. One for spatial metrics and the other channel metrics?
