mdanderson03/SpectrePlex/Presentation/2-2-24 auto_exposure.pptx

## Auto Fluorescence Scale Factor Guess

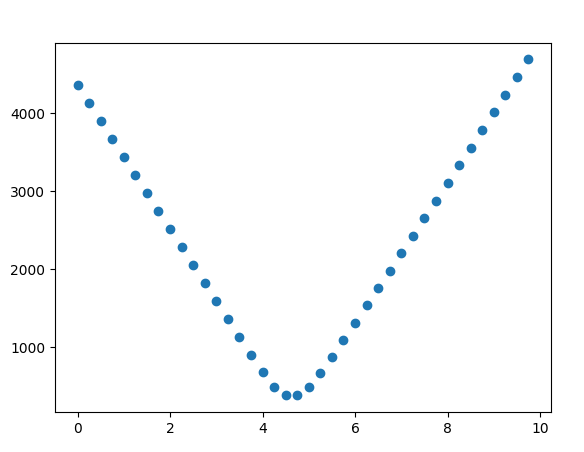
[picture p45: figure]

mean[abs(Image – X*autoF)]

X

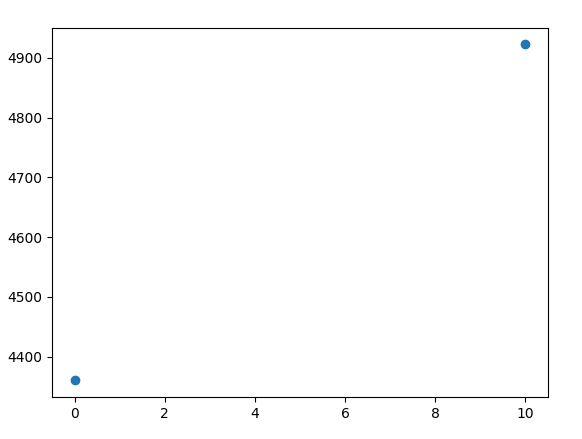
[picture p46: figure]

- What if not know scale factor between image and autoF image?
- Minimize metric of mean[abs(Image – X*autoF)]
- Turns out to be monotonic (makes perfect sense)
- If use inverse weighted average between lowest two points, you can estimate the X value where the metric is minimized
- Given its monotonic, this should still be valid as we reduce points. Even down to just two

Min guess = 4.62

mean[abs(Image – X*autoF)]

X

Min guess = 4.70

## Example Subbed Images

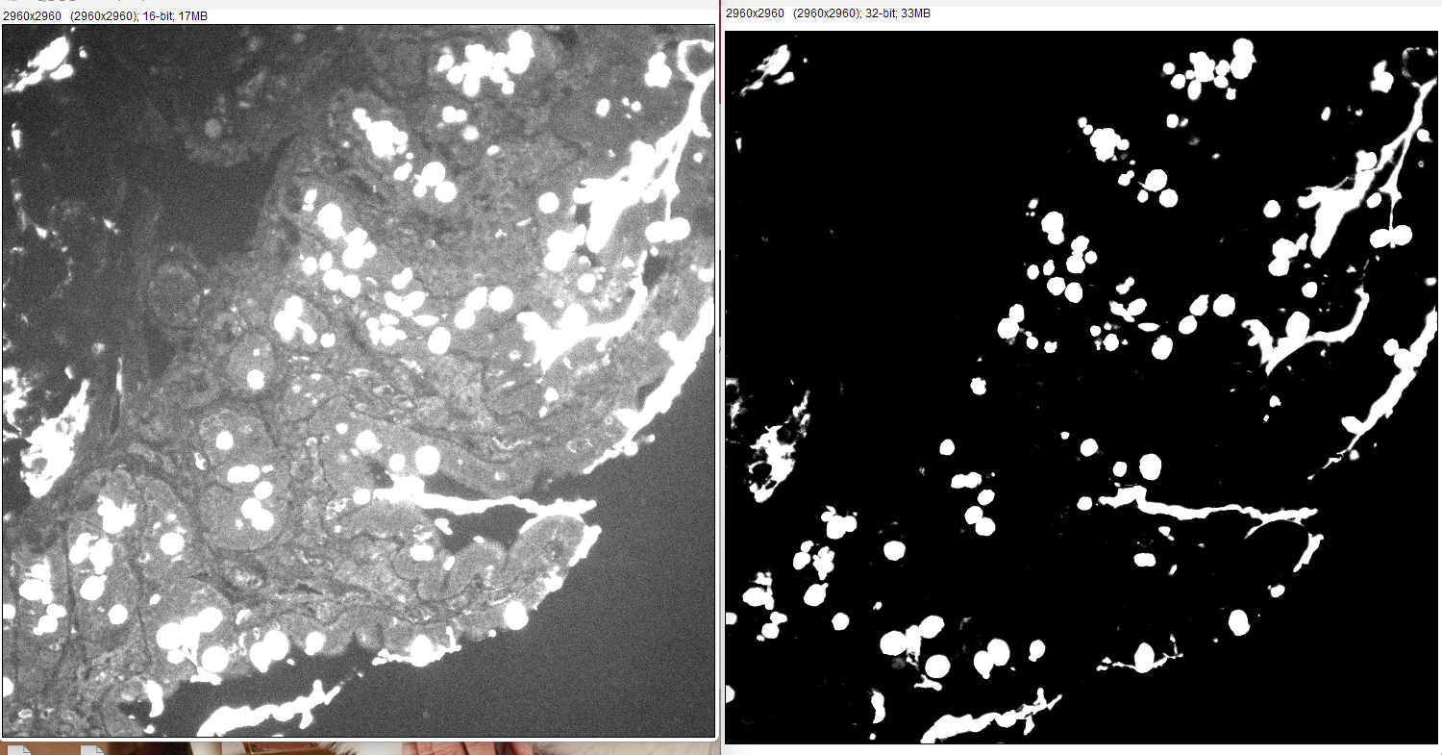
[picture p47: figure]

## Slide 4

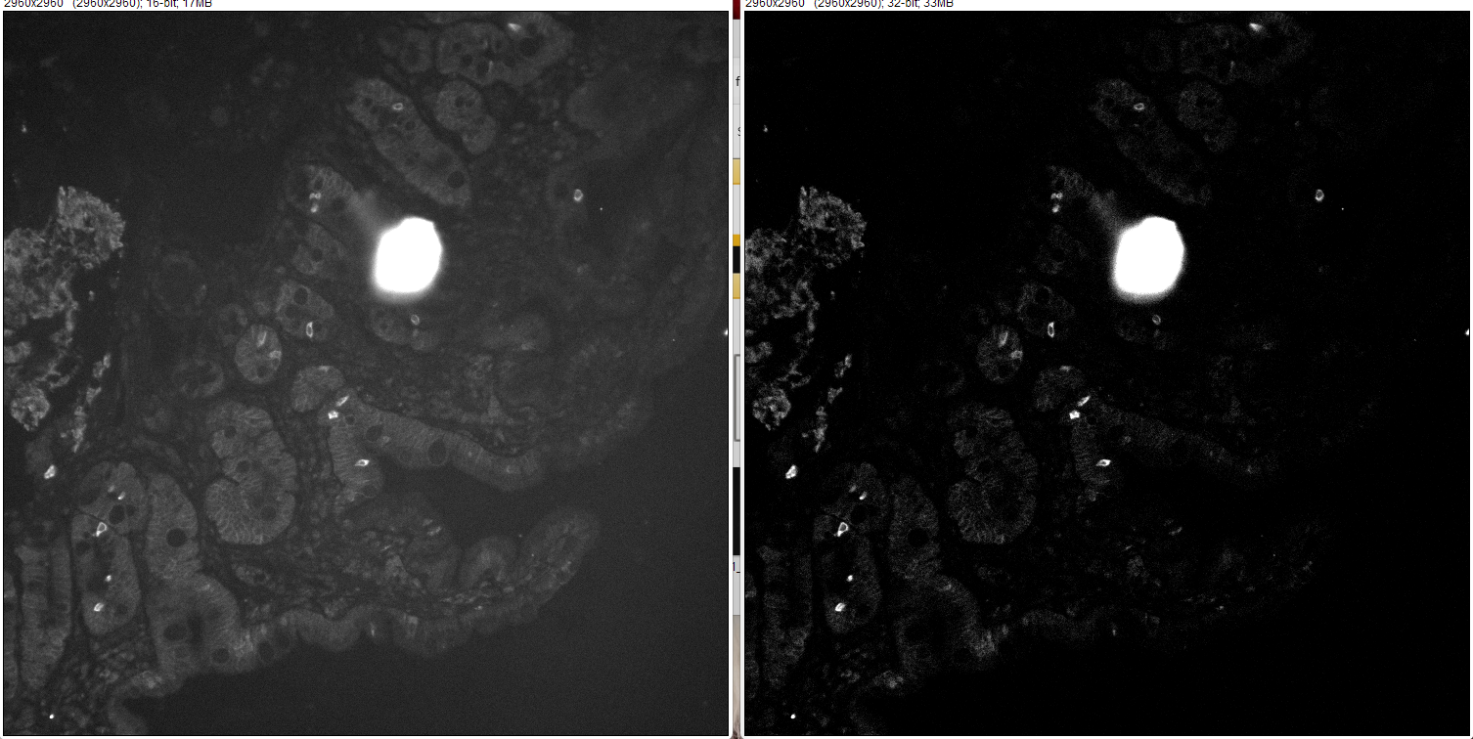
[picture p48: figure]

## Slide 5

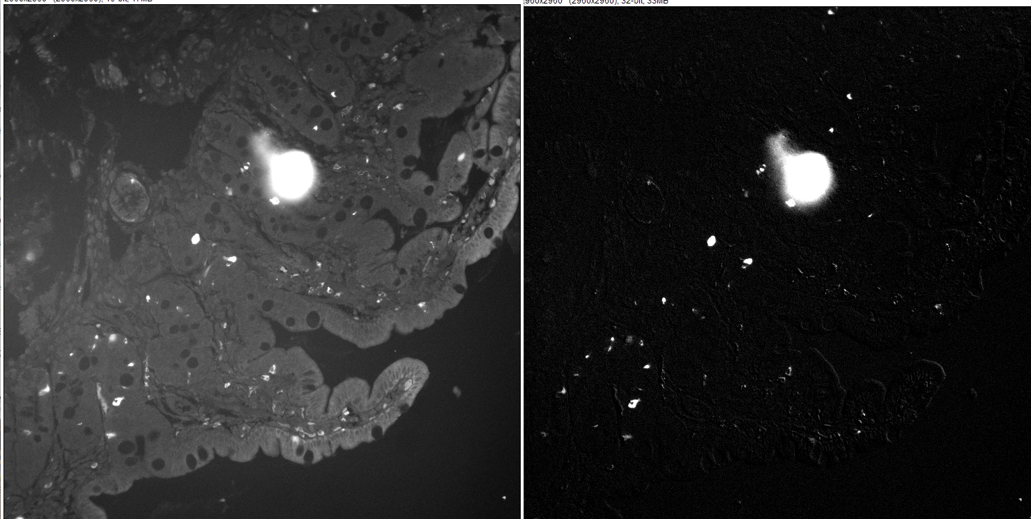
[picture p49: figure]

## Slide 6

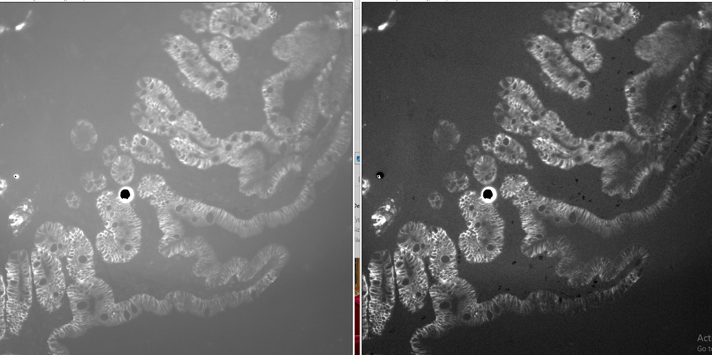
[picture p50: figure]

## Steps to Auto Exposure

1. Perform dynamic background sub
2. Use tissue binary to screen out off tissue pixels
3. Otsu threshold non-zero pixels that exist after step 2
4. In above thresh pixels, remove dimmest 1% of pixels
5. Use resulting dimmest pixel to determine exposure time (based off of subbed image)
6. Use unsubbed image to determine brightest pixels.
7. Use brightest to determine if it can be acquired in one shot or multiple shots (ie does the frame have enough dynamic range for well exposed bright and dim pixels at same time). Reason is I care about actual stained strength for exposure time, but auto F is always captured so must be taken into account for actual image acq and dynamic range occupied.
