mdanderson03/SpectrePlex/Presentation/3 point property maximize.pptx

## 3 point property maximize

## Skip range Size

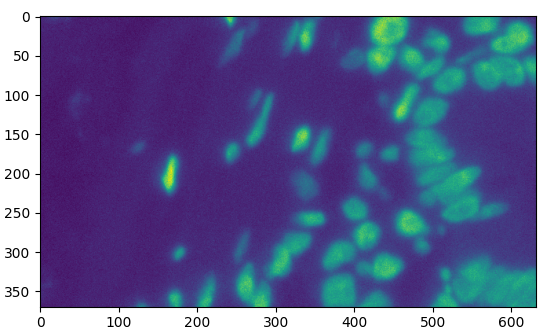
[picture p51: figure]
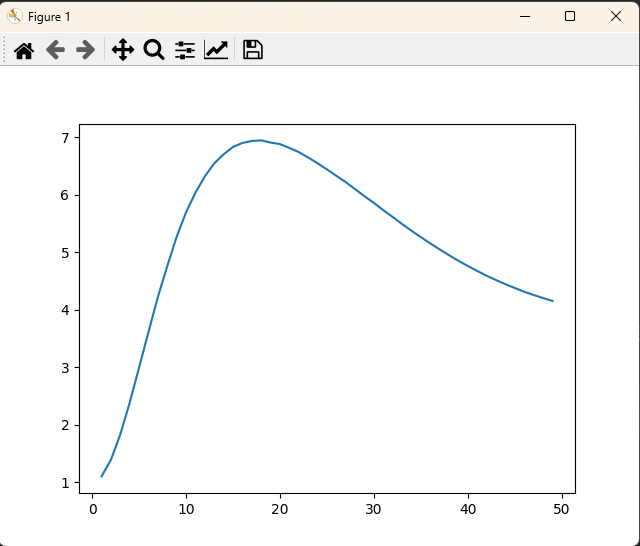
[picture p52: figure]
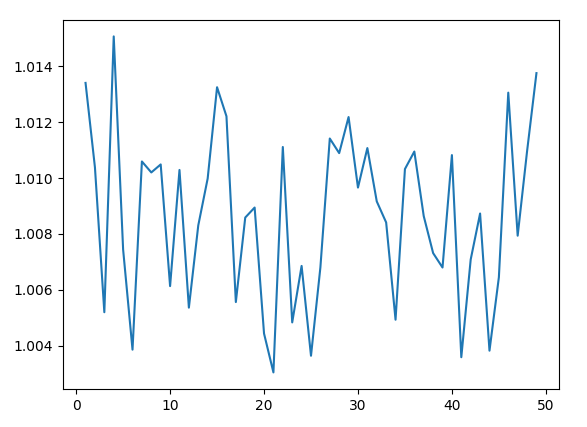
[picture p53: figure]
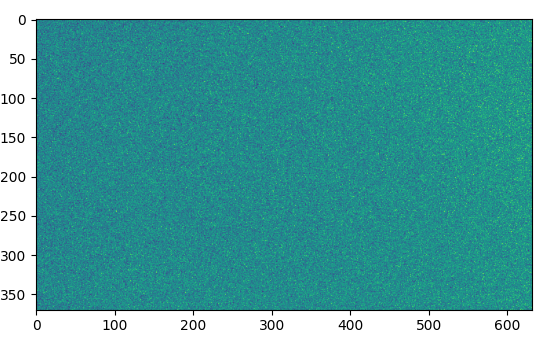
[picture p54: figure]

## Slide 3

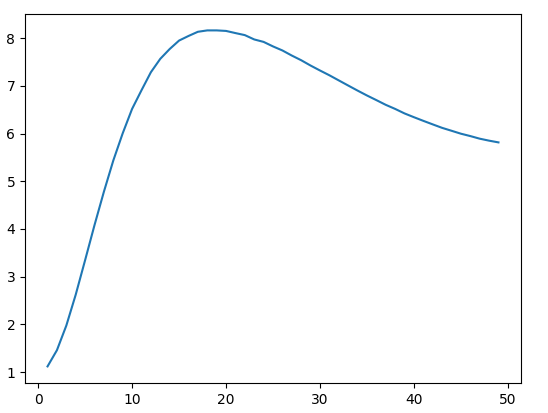
[picture p55: figure]
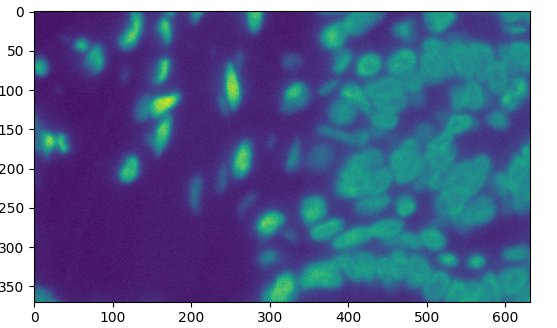
[picture p56: figure]
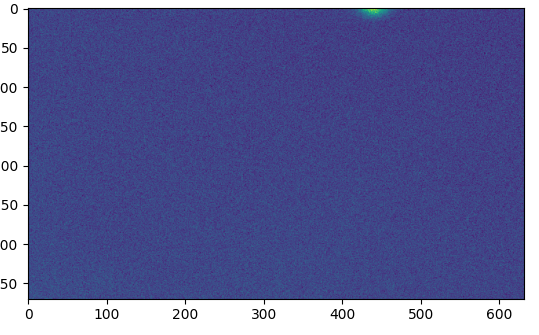
[picture p57: figure]

## Slide 4

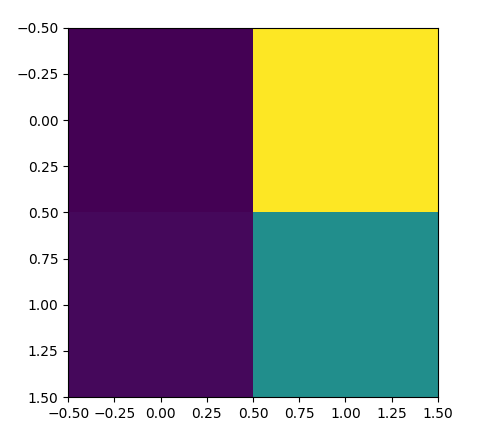
[picture p58: figure]
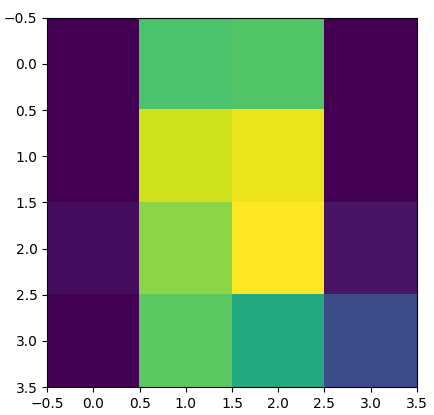
[picture p59: figure]
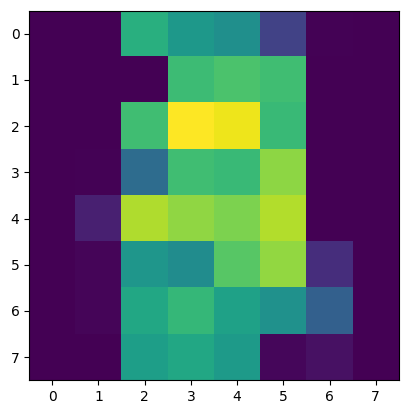
[picture p60: figure]
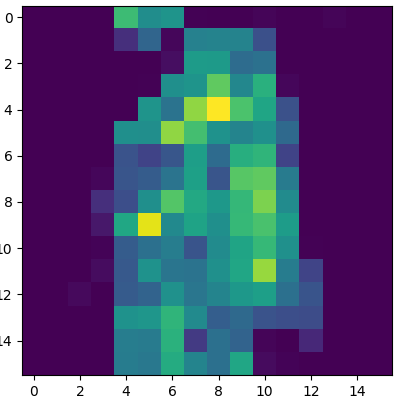
[picture p61: figure]

## Slide 5

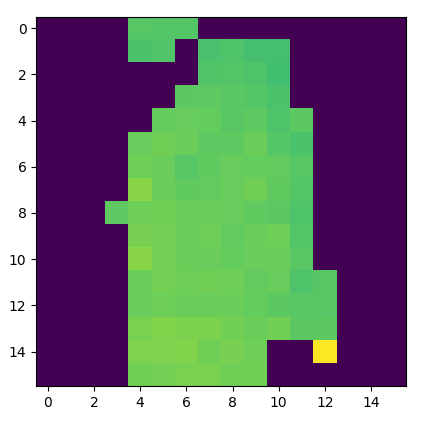
[picture p62: figure]

## Slide 6

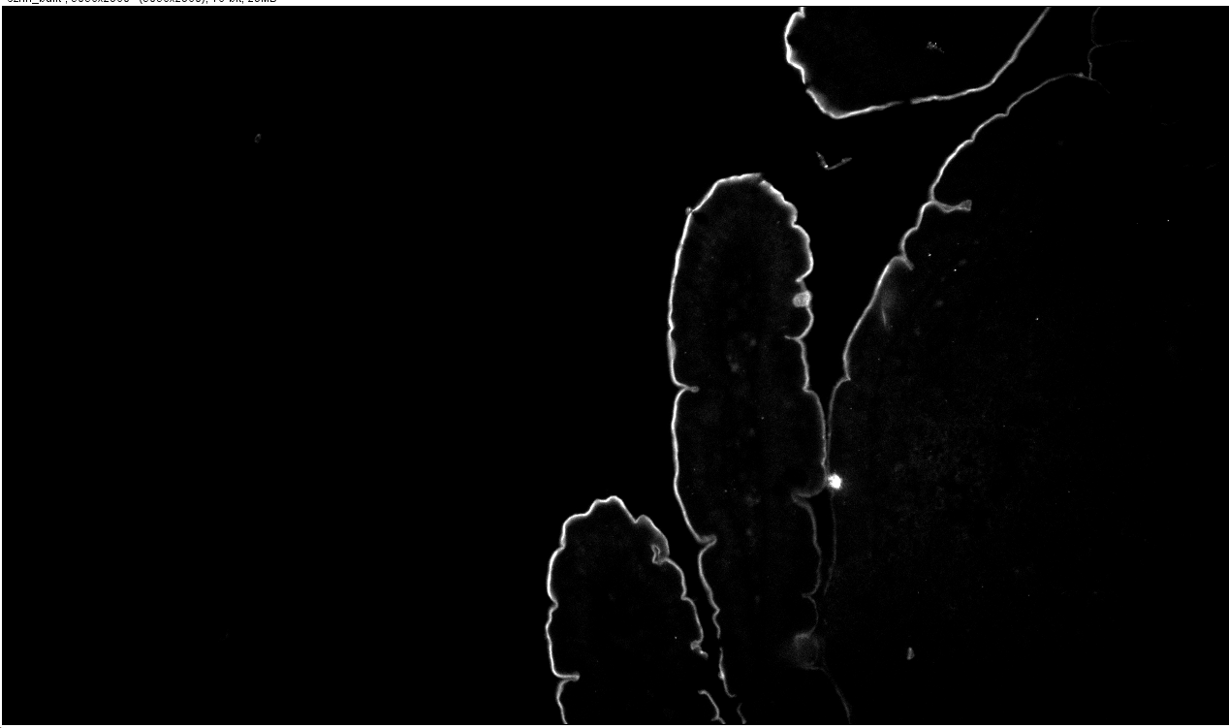
[picture p63: figure]
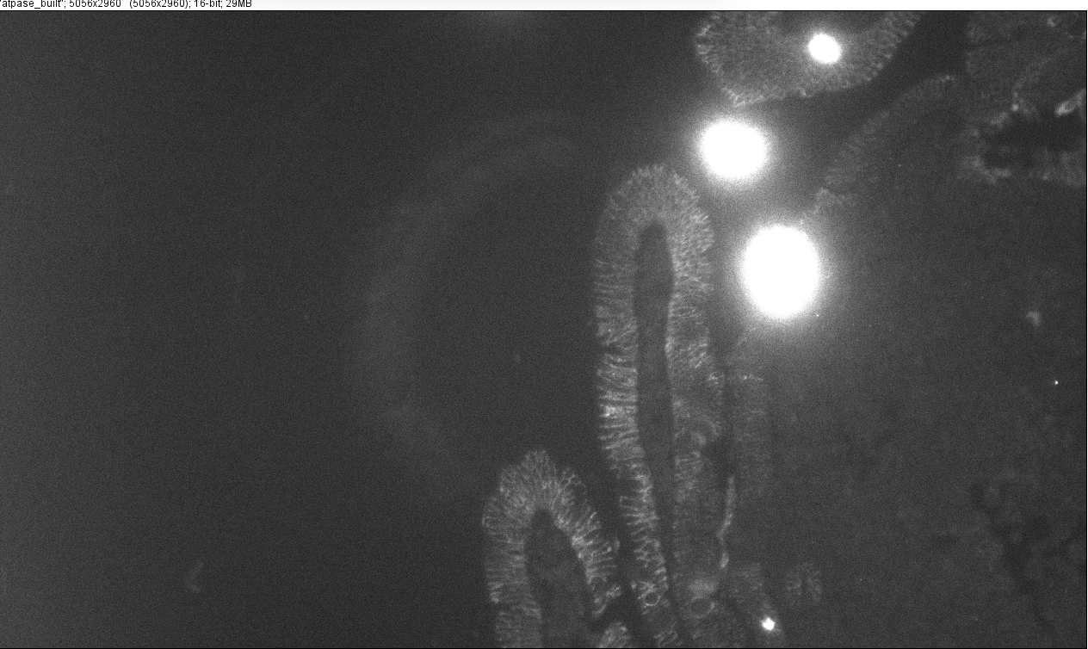
[picture p64: figure]

## Slide 7

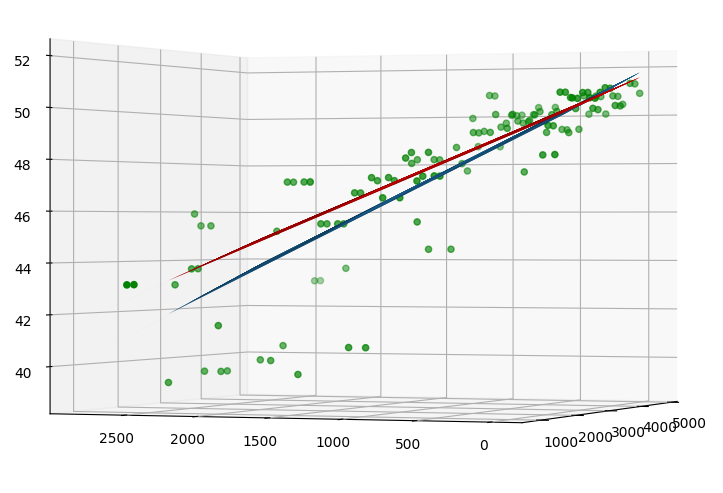
[picture p65: figure]

Huber

Linear Regression

## 3 Point Brenner Noise Properties

- We get error based on the 3 point brenner method.
- How do the results distribute around the “known” answer?
- To solve this, we generate the fitted plane and by eye we know this is a good fit to the data, although a few areas exist that don’t fit well (I suspect the slide moved in that area when capturing).
- To find the distribution, we find the difference between the ‘known’ answer and the result in that spot. We then plot a histogram of points and fit with both a gaussian function and a Lorentzian function.

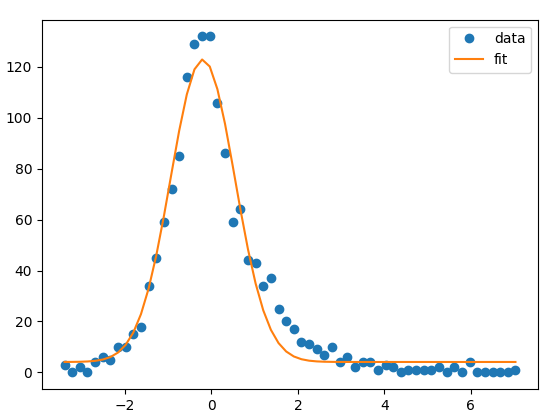
[picture p66: figure]

Lorentzian fits error distribution very well.
Offset = -0.2 um
Width = 1.5 um
Given depth of focus is around 2um, 1.5um for error is workable.

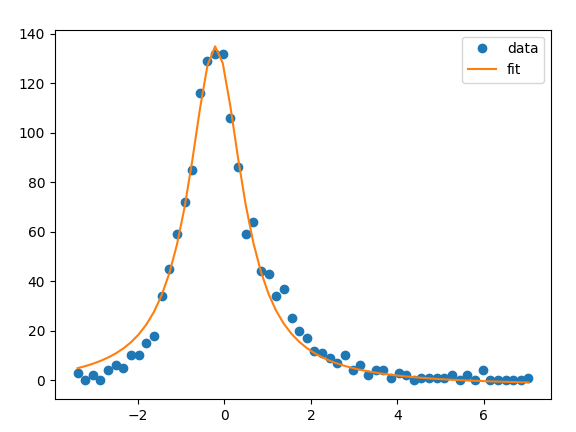
[picture p67: figure]

Lorentzian

Gaussian
