mdanderson03/SpectrePlex/Presentation/Auto Focus Network.pptx

## Auto Focus Network

## High Level Block Diagram

XY Coordinates
Obtain XY tile coordinates via micro magellan surface
Choose Tiles
Determine which tiles to focus on
Capture 3 plane images
At each determined tile, capture full frame images from 3 different z planes
Gaps between z planes is predetermined
Break Images into super pixels
Calculate reciprocal Brenner Score
Filter Brenner Score
Divide each image into an array of sub areas dubbed ‘super pixels’
Calculate brenner score for each super pixel and take reciprocal of it
Brenner score is pixel(col, row) – pixel(col + n, row).
Filter out background super pixels via ‘Well Depth’
Make Focus Prediction
Take 3 point reciprocal brenner score, solve quad equation and solve for derivative = 0 to find projected focus position. Use Gauss-Jordan reduction to solve
Fit Plane
Fit best plane to all points (X,Y, Predicted focus z position)
Use outlier dampening loss function to best fit with
Populate Focus Map
Use Plane(XY coordinates) to determine Z position for focus map
Pop FM array with depth of focus across 1 FOV
Z value in FM is top value. Work down when capturing more planes

## Needed Methods

1. Generate FM array [x kinda]
2. Generate super pixel array(sp_y, sp_x, channel) [x]
3. Image subdivider [x]
4. Integrate image into super pixel array (image, channel) [x]
5. Tile chooser [x]
6. Auto Focus(channel)
7. Well Depth filter
8. Focus prediction populator
9. Plane fitter
10. Plane 2 FM map

## FM Array Constructions

- Contains all channel info
- Numpy array with dimensions (10, y_tiles, x_tiles). X and Y tile count come from Micro Magellan array
- Dtype = int16

9
Number Z slices A647 with depth of focus step sizes
8
Top Z position A647
7
Number Z slices A555 with depth of focus step sizes
6
5
4
3
2
1
0
X positions
Y positions
Top Z position DAPI
Number Z slices DAPI with depth of focus step sizes
Number Z slices A488 with depth of focus step sizes
Top Z position A555
Top Z position A488
10
If tissue is present = 1, if tissue is absent = 0

## Super Pixel Array Array Constructions

- 1 Array per channel.
- Numpy array with dimensions (5, y_super_pixel_count, x_super_pixel_count, 2).
- y_super_pixel_count = int(super_pixels+per_image * y_tile_count *overlap_adjuster)
- Dtype = float64

4
3
2
1
0
[Reciprocal Brenner Score plane 1, Z position]
[Reciprocal Brenner Score plane 2, Z position]
[Reciprocal Brenner Score plane 3, Z position]
[Predicted Focus Z position, Nothing]
Super Pixel Mask
[All pixels 0 or 1, Nothing]

## Setting Optimal Derivative Step Size (DAPI)

Super Pixel Image well depth

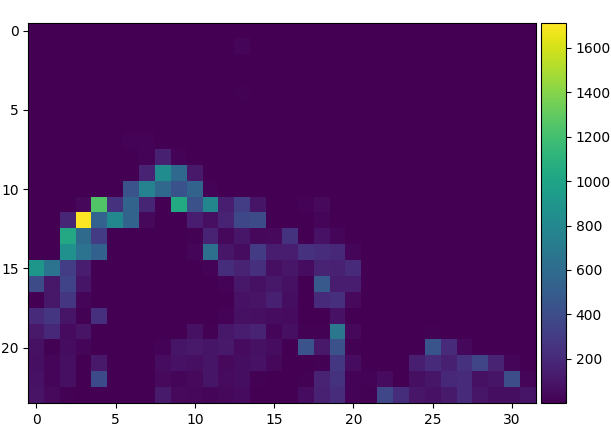
[picture p68: figure]

Super Pixel Image derv step size

Max Derv Step Size Histogram

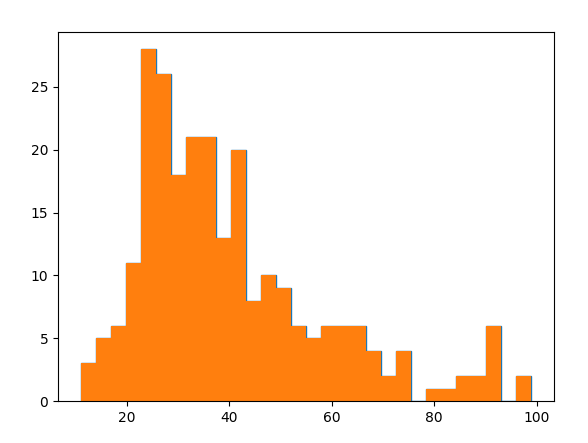
[picture p69: figure]

average 40
median: 35
std dev: 18

Raw

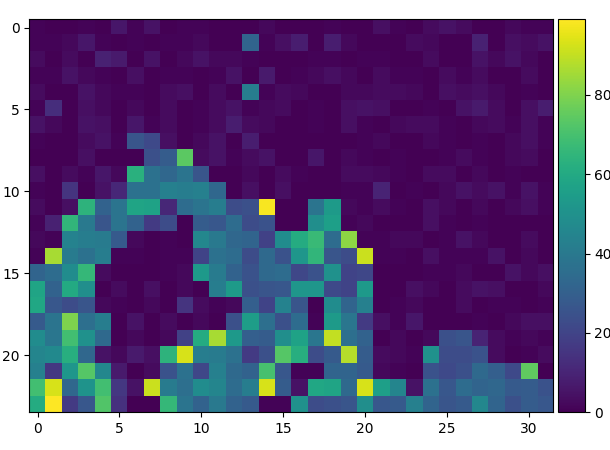
[picture p70: figure]
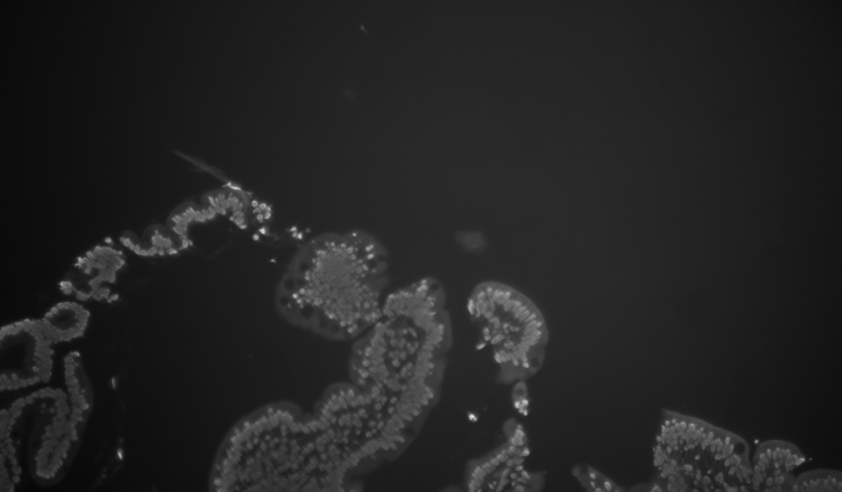
[picture p71: figure]

## Setting Optimal Derivative Step Size (DAPI) 2nd image

Super Pixel Image well depth

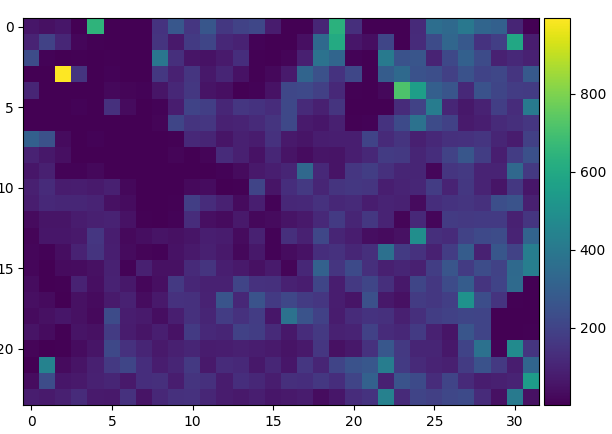
[picture p72: figure]

Super Pixel Image derv step size

Max Derv Step Size Histogram

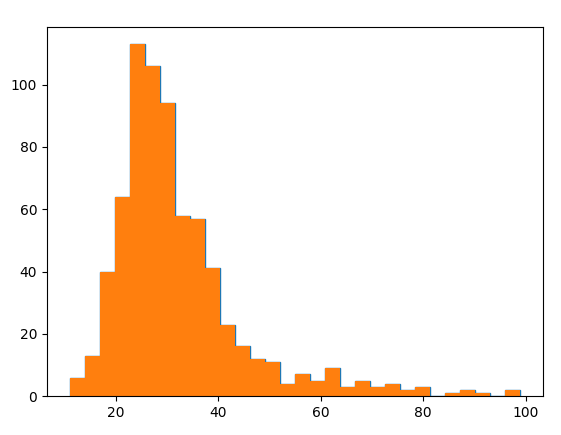
[picture p73: figure]

average 32
median: 29
std dev: 13

Raw

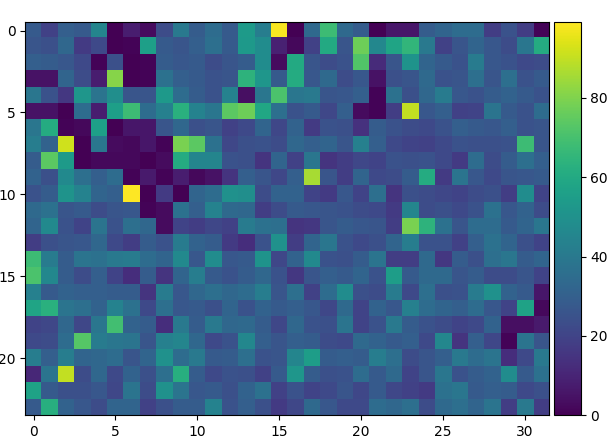
[picture p74: figure]
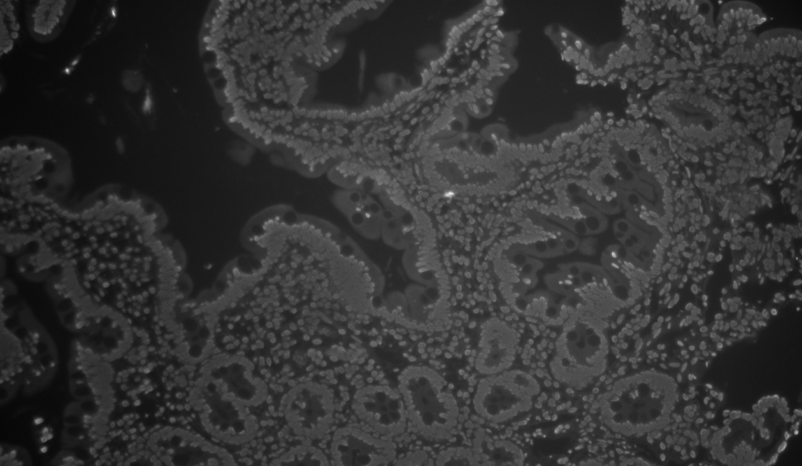
[picture p75: figure]

## Setting Optimal Derivative Step Size (A488 Ezrin)

Super Pixel Image well depth

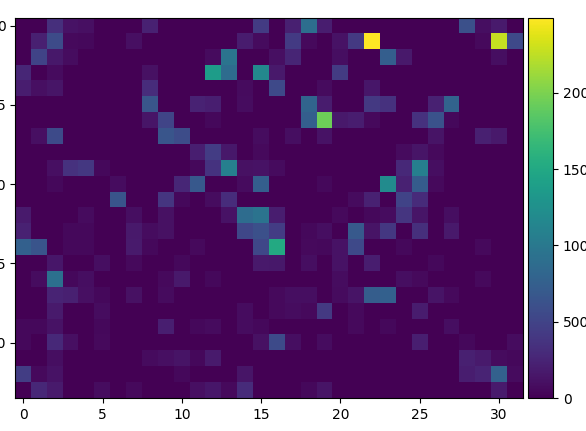
[picture p76: figure]

Super Pixel Image derv step size

Max Derv Step Size Histogram

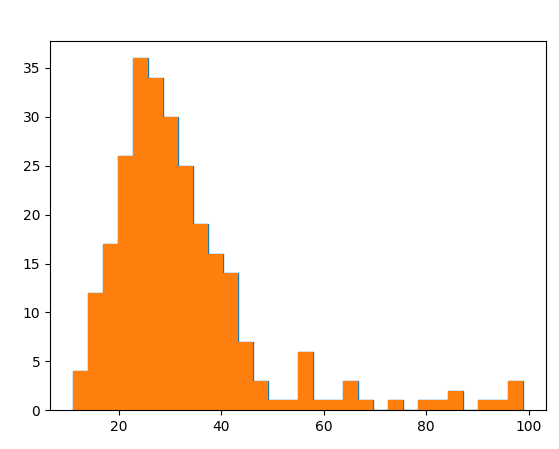
[picture p77: figure]

average 32
median: 29
std dev: 15

Raw

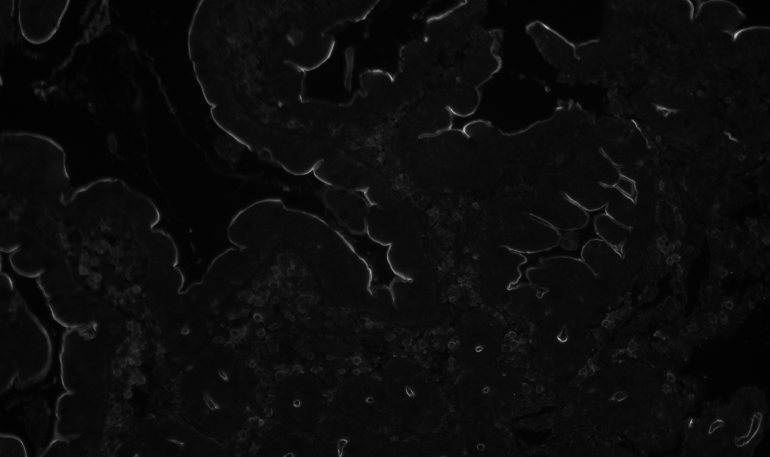
[picture p78: figure]
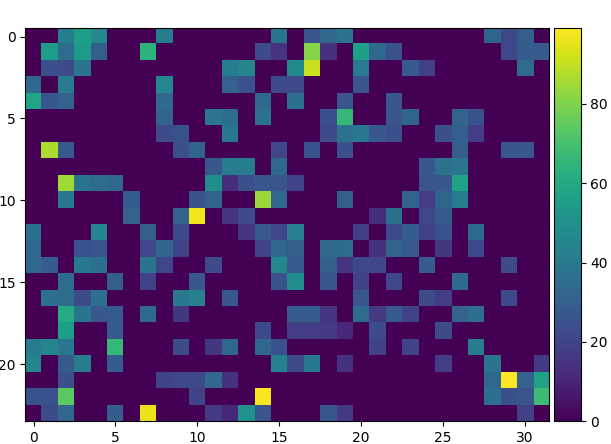
[picture p79: figure]

## Setting Optimal Derivative Step Size (A488 Ezrin) 2nd image

Super Pixel Image well depth

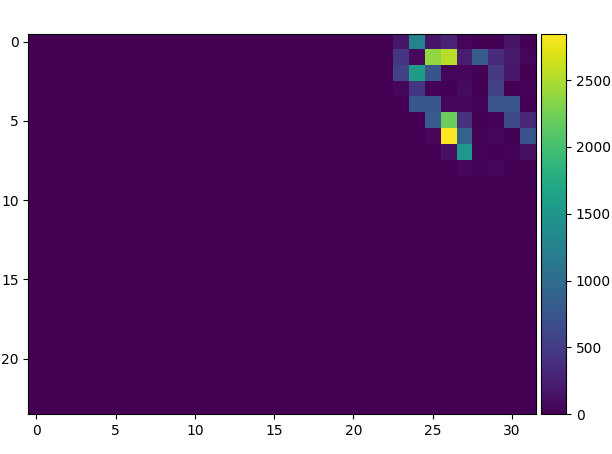
[picture p80: figure]

Max Derv Step Size Histogram

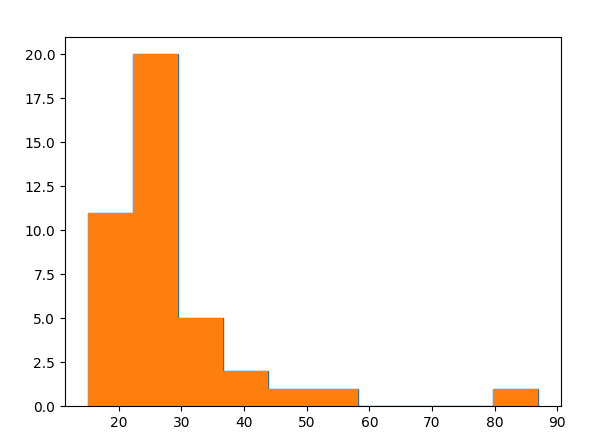
[picture p81: figure]

average 28
median: 26
std dev: 12

Raw

Super Pixel Image derv step size

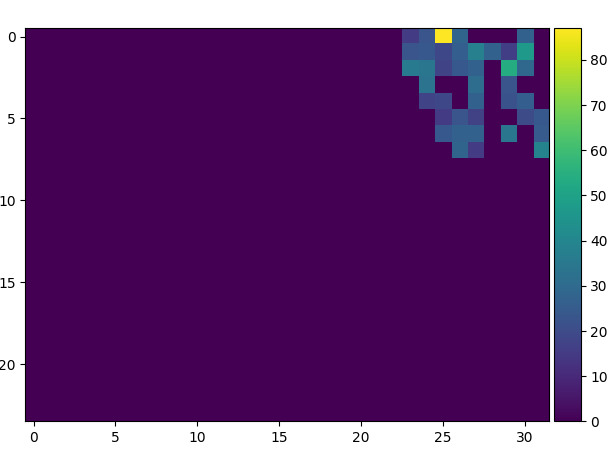
[picture p82: figure]
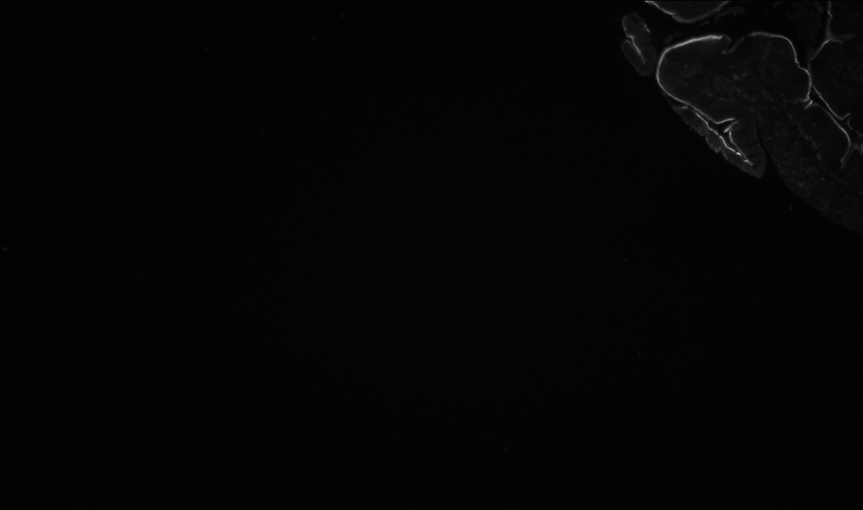
[picture p83: figure]

## Auto Exposure Algorithm

1. Start from 100ms exp time
2. Go to XY tile position
  1. Take image with given channel
  2. Check if image is within bounds at the 99% percentile pixel
    1. If saturated
      1. reduce exp time by 10x
      2. retake image and recheck if still saturated.
      3. Repeat 1-2 until not saturated anymore
      4. Scale exp to give 10% dynamic range intensity
    2. If too low
      1. Scale exp to give 10% dynamic range intensity or 1000ms, which ever one that is lower exposure time
  3. If not saturated add to exp_calc_array and move to next z point
  4. Repeat steps 1-4 until all 3 z points are acquired w/ same exp time. Must retake images if needed
  5. Repeat steps 1-5 until all 4 channels are set
3. Repeat for all XY position with starting exp time being rolled over from previous XY position
4. Solve quadratic equation for all three intensity points via gauss Jordan reduction method to solve for all coefficients.
5. Find intensity that is predicted via derivative of quad equation set to zero and subbed back in.
6. Cycle through all results as a function of XY position to find the highest predicted intensity after being scaled by exp time.
7. Take desired intensity/highest intensity to make a scale factor
8. Take acquired exp time and multiply by new scale factor.
  1. If new exp time > 2000ms, make = 2000
  2. If less than 2000ms, don’t alter new exp time

## Auto Expose Array Construction

- 1 Array per channel, delineated by index and not file name
- Numpy array with dimensions (4 (channels), y_tiles, x_tiles, 4, 3).
- Dtype = Int16

3
2
1
0
[X percentile intensity in image 1, Z position, exp_time ]
[X percentile intensity in image 2, Z position, exp_time ]
[X percentile intensity in image 3, Z position, exp_time ]
[Predicted in focus intensity, predicted focus]

DAPI = index 0

3
2
1
0
[X percentile intensity in image 1, Z position, exp_time ]
[X percentile intensity in image 2, Z position, exp_time ]
[X percentile intensity in image 3, Z position, exp_time ]
[Predicted in focus intensity, predicted focus]

A488 = index 1

3
2
1
0
[X percentile intensity in image 1, Z position, exp_time ]
[X percentile intensity in image 2, Z position, exp_time ]
[X percentile intensity in image 3, Z position, exp_time ]
[Predicted in focus intensity, predicted focus]

A555 = index 2

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

A647 = index 3

## Slide 12

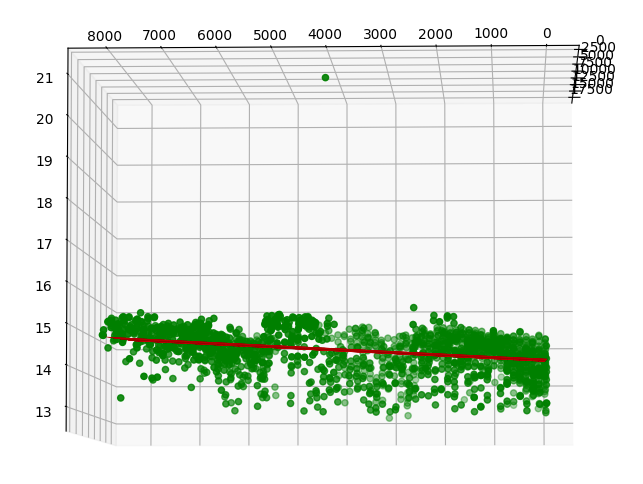
[picture p84: figure]
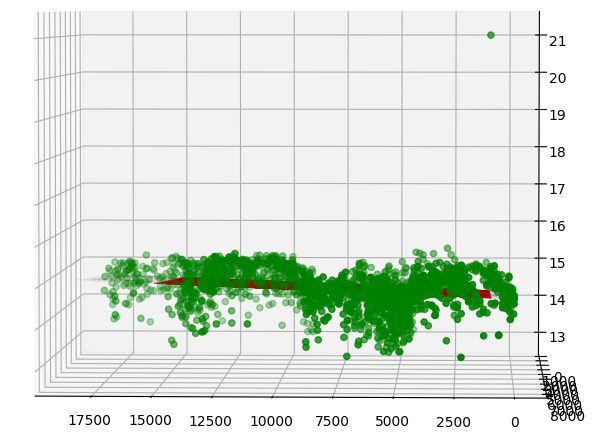
[picture p85: figure]

- 5.6 seconds for all processing with 12 tiles

## Autofocus

- New auto focus will utilize the 3 images from autofocus and project out what the approximate ideal exposure would be.

## Slide 14

- Plot highest int value of the bottom 99% pixels vs slice in image array
- Also plot 1/highest pixel
- Plot z slices 7-22 and fit reciprocal to quadratic equation
- Fits very well!

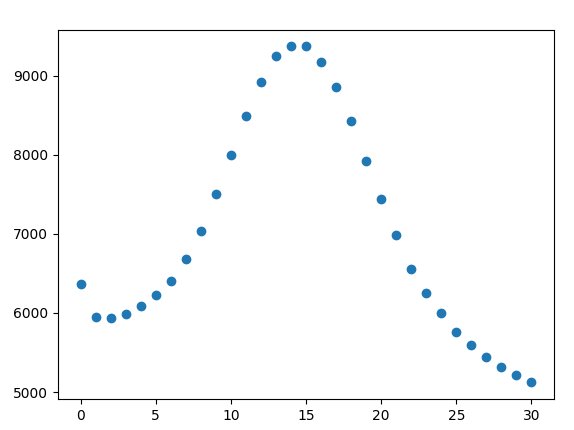
[picture p86: figure]
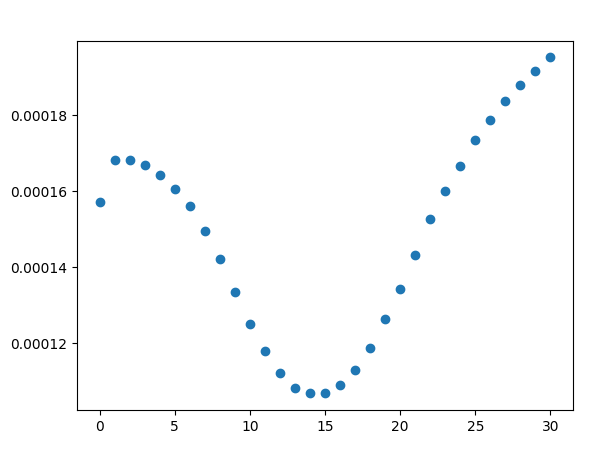
[picture p87: figure]

## Intertwining Auto Focus and Auto exposure

f (x)=a∗x^2 +b∗x+C
Find derivative f(x)=2a∗x+b
set equal to zero and solve x= (−b)/(2∗a)
subback into function and solve to find minimum minf(x)= (−b^2)/(4∗a)+C
