mdanderson03/SpectrePlex/Presentation/Noise2Void demo.pptx

## Noise2Void demo

## DAPI

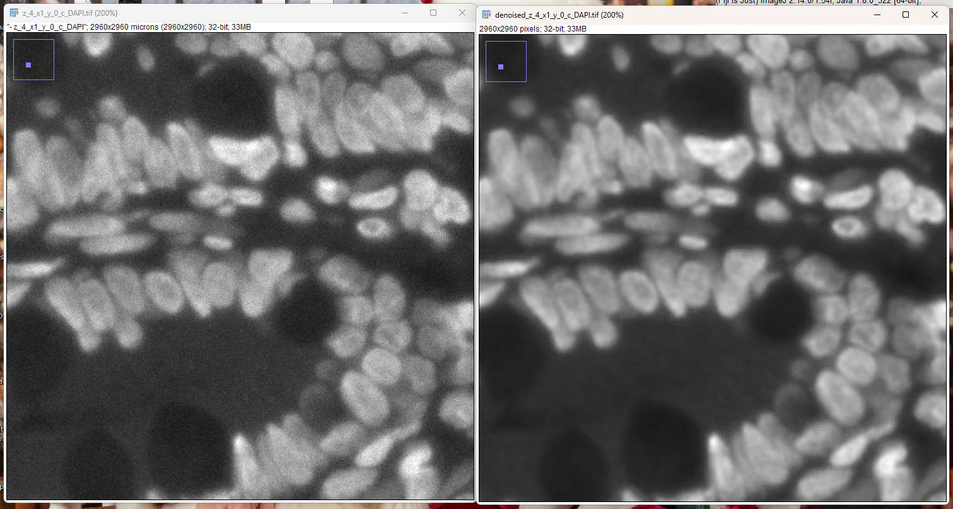
[picture p88: figure]

## EPCAM

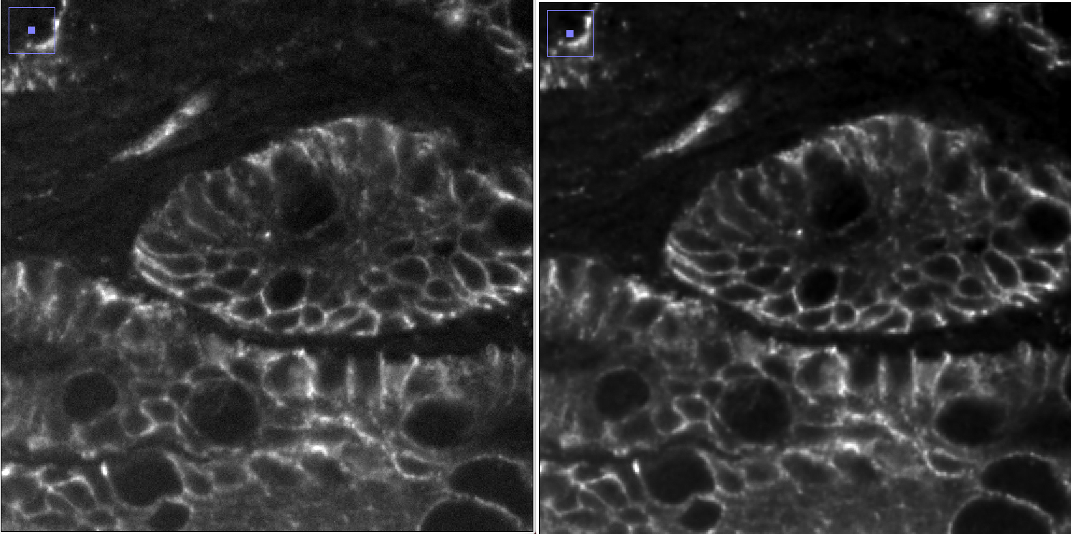
[picture p89: figure]

Raw

N2V

N2V + Rolling Ball

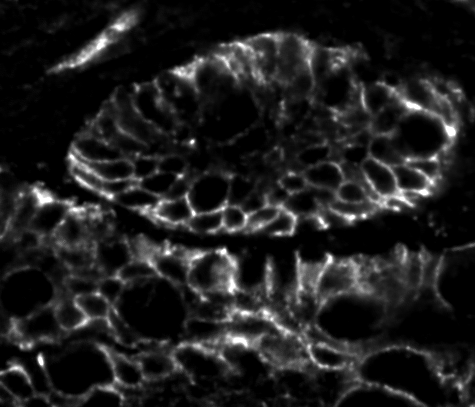
[picture p90: figure]

## A555_cycle1

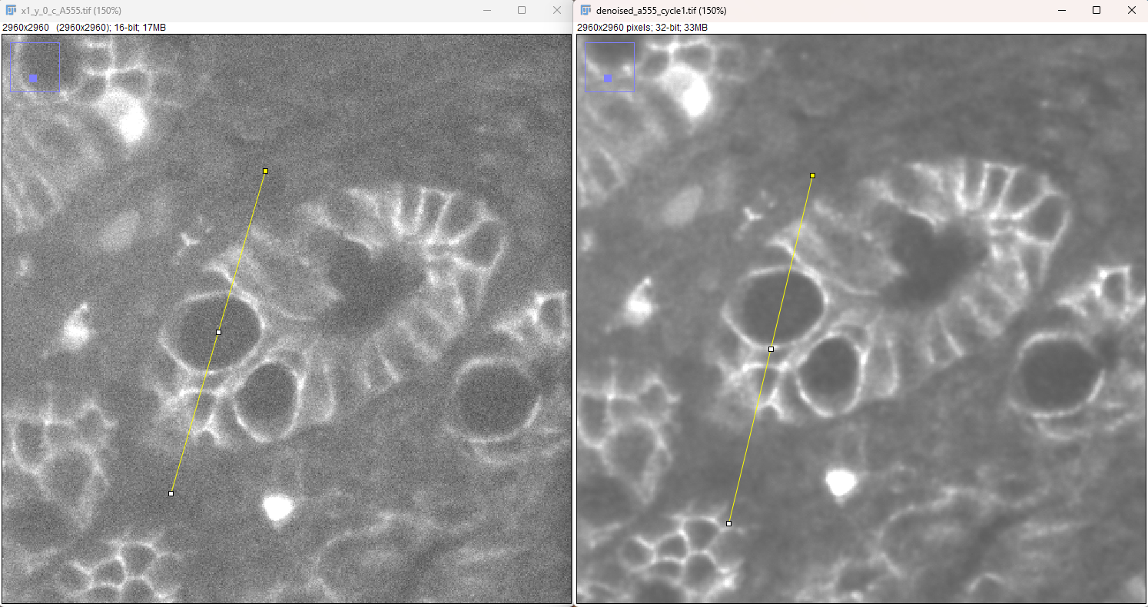
[picture p91: figure]
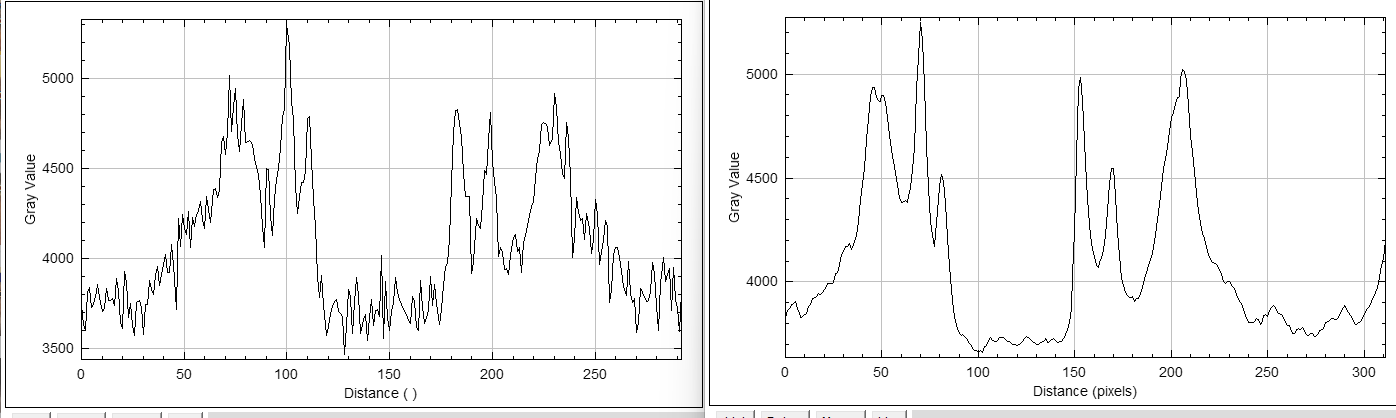
[picture p92: figure]
