mdanderson03/SpectrePlex/return forms/2-Return Merchandise Authorization RMA-220610.xlsx

Sheet: Form
 | Elveflow Instrument Service RMA Form
 |  | Important information
 |  | 1. To make sure that you receive the correct service, don't change the parcel content once the return label is sent to you.
 |  | 2. Instruments should be sent with the power supply used, sensors should be sent with cables, and their amplification module, if applicable.
 |  | 3. AF1 Dual is a double unit. Please send both parts if an inspection of an AF1 Dual is required.
 |  | 4. MPS don't have serial numbers, so please indicate the PO number anytime a MPS is involved in a RMA process.
 |  | 5. Thank you for selecting a parcel pickup date lying between +2 and +7 days from the date of your reply, so that we can efficiently arrange the shipment.
 |  | 6. No technical inspection will be performed by Elveflow personel until a valid Health & Safety form is received from the user. The user signature is enough.
 | Your name | YOUR Desired date & time of collection of the package (dd/mm/yyyy) | Device purchase date | Invoice reference / PO number | Device Serial Number | Your Company / Laboratory Name | Your Address | Your Phone (for delivery) | Your Email (to get DHL tracking info) | Your Parcel Size | Your Parcel Weight | Box Contents (refer to Invoice for description) | Description of the issue | YOUR expectations / recommendations / comments
Example | John Doe | ( * required field) | 2019-04-26 | PO 100253245 | OB1111117358975 | MY NICE STARTUP Ltd | 1/3 bis Rue Robert et Sonia Delaunay, 75011 PARIS, France | 01 23 45 67 89 | Contact@elveflow.com | 11x20x32 cm | 6 kg | •1 x OB1 Base MkIII+ •1 x OB1 Power Plug •1 x MFS3-Analog Sensor | Liquid backflow happened on both device, pressure is unstable since then. | Please check the 2 OB1 and replace any defective pneumatic elements if necessary.
Your details ➡ | Michael Anderson | * 6/26/2023 | *4/1/23 | GENFD0002347798 | Unsure right now | Boston Children's Hospital | BOSTON CHILDREN'S HOSPITAL 61 BINNEY ST, BOSTON MA 02115 | 260-336-2659 | md.anderson03@gmail.com | * required field | 4kg | 1xOb1 Base Mk4 | Randomly disconnects from flow meter | Support suggested that internal connection to flow meter might have a loose connection
 |  |  | During the warranty period, Elveflow will, at its option, either repair or replace products which prove to be defective. Repairs resulting from improper use or performed beyond the typical warranty period may be invoiced.
 |  | Please allow at least a 3 business day delay for parcel pickup.
 |  | Today's date
 |  |  | 2023-06-23

Sheet: Services
Elveflow Service Offer
Every instrument that returns to our factory will be inspected and checked. This Check Service (see details below) is a free operation during the warranty period, but charged under non-warranty situation (warranty period expired, misuse, etc.). Following this inspection, we will discuss together the best service we can provide to you, to maintain your maximum efficiency while helping to minimize your downtime.
Contact:
OB1 Serial
Device configuration
Date:
 |  | Service
Actions performed |  | Check Service | Pneumatic Repair | Electronics Modernisation | Channel Addition | OB1 Sensor Connection
Visual inspection, check of control points (connection to pressure sources, USB communication, etc.), and the replacement of small elements of these control points when necessary (connectors, OB1 screen, button, etc ...). |  | R | T | T | T | T
Test of the pneumatic performance of the device, channel by channel, and the repair or replacement of the necessary pneumatic elements. |  | T | R | T | T | T
Replacement of electronics with the most recent Electronic board version compatible. |  | T | T | R | T | T
OB1 upgrade with an additional pressure channel. Requires an OB1 Base (box). The upgraded OB1 needs to be refreshed in the ESI for the upgrade to take effect. |  | T | T | T | R | T
Installation of sensor connections on empty OB1 channel slots (front panel), activation of sensor electronics |  | T | T | T | T | R
Pricing |  | Contact Us! | Contact Us! | Contact Us! | Contact Us! | Contact Us!
Notes | Service is performed at Elveflow Workshop
 | Return of the device to Elveflow workhop is free and managed by Elveflow

Sheet: Lists
Select device type >> | Select service type >> | Warranty status >>
----------AF1 series | Request for exchange | Device purchased > 2 years ago (OB1)
AF1 1600 | Request for refund | Device purchased > 1 year ago (other instruments & sensors)
AF1 200 | Instrument Check | Still under warranty
AF1 Dual (controller) | Instrument Pneumatic Repair
AF1 Dual (pump) | Instrument Electronics Modernisation
----------Flow Sensors series | OB1 Channel Addition 200mbar
Flow Sensor 1 Analog | OB1 Channel Addition 2000 mbar
Flow Sensor 1 Digital | OB1 Channel Addition 8000 mbar
Flow Sensor 2 Analog | OB1 Channel Addition -900/6000 mbar
Flow Sensor 2 Digital | OB1 Channel Addition -900/1000 mbar
Flow Sensor 3 Analog | OB1 Front Panel Sensor Connection
Flow Sensor 3 Digital
Flow Sensor 4 Analog
Flow Sensor 4 Digital
Flow Sensor 5 Analog
Flow Sensor 5 Digital
Flow Sensor Premium BFS1
Flow Sensor Premium BFS1+
Flow Sensor Premium BFS2
Flow Sensor Premium BFS3
----------Microfluidic Valves series
2/2 High Pressure Peek Valve (NC)
2/2 High Pressure Peek Valve (NO)
2/2 Peek Valve (NC)
2/2 Peek Valve (NO)
3/2 High Pressure Peek Valve
3/2 Peek Valve
----------Bubble Detector Series
Bubble Detector Large
Bubble Detector Small
Custom Valve
----------MUX Series
MUX Cross Chip
MUX Distribution
MUX Distributor
MUX Flow switch Matrix Base
MUX Injection
MUX Quake Valve
MUX Recirculation
MUX Wire
Mux Wire v2
---------- OB1 series
OB1
OB1 OEM
---------- Air & Vacuum pump series
Vacuum Pump
Compressor pump
----------Pressure Sensors series
Pressure Sensor 0 - Large package version
Pressure Sensor 0 - Small Package version
Pressure Sensor 1 - Large package version
Pressure Sensor 1 - Small package version
Pressure Sensor 2 - Large package version
Pressure Sensor 2 - Small package version
Pressure Sensor 3 - Large package version
Pressure Sensor 3 - Small package version
Pressure Sensor 4 - Large package version
Pressure Sensor 4 - Small package version
---------- Sensor Reader series
Sensor Reader v2
