mdanderson03/SpectrePlex/3D model/Files for printing/chamber V5.1-ChamberMain Body.stl

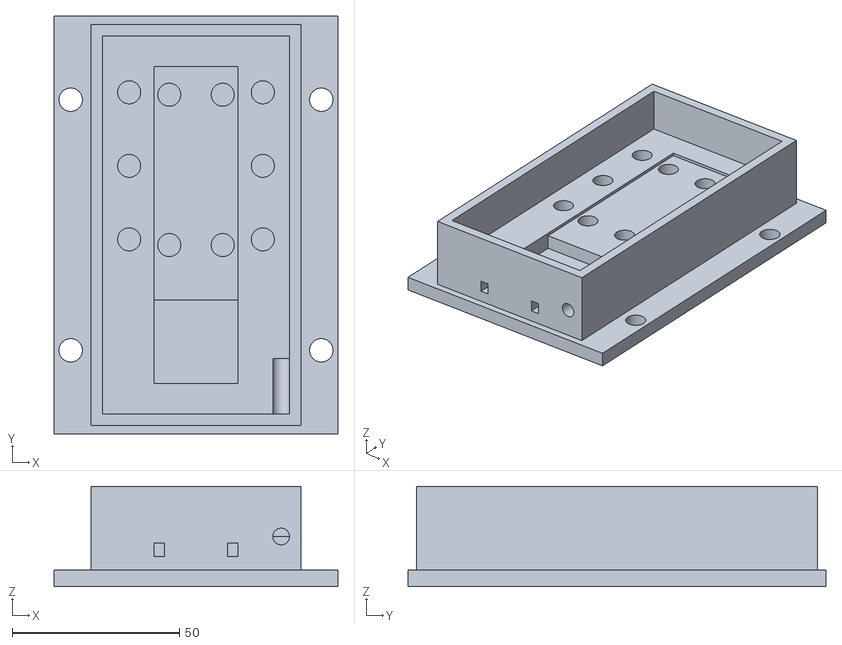
[picture p93: CAD file, 2024-03-06]
3D model/Files for printing/chamber V5.1-ChamberMain Body.stl
85.0 x 125.0 x 30.0
