mdanderson03/SpectrePlex/3D model/Files for printing/control board housing V1.0-complete bracket breadboard.stl

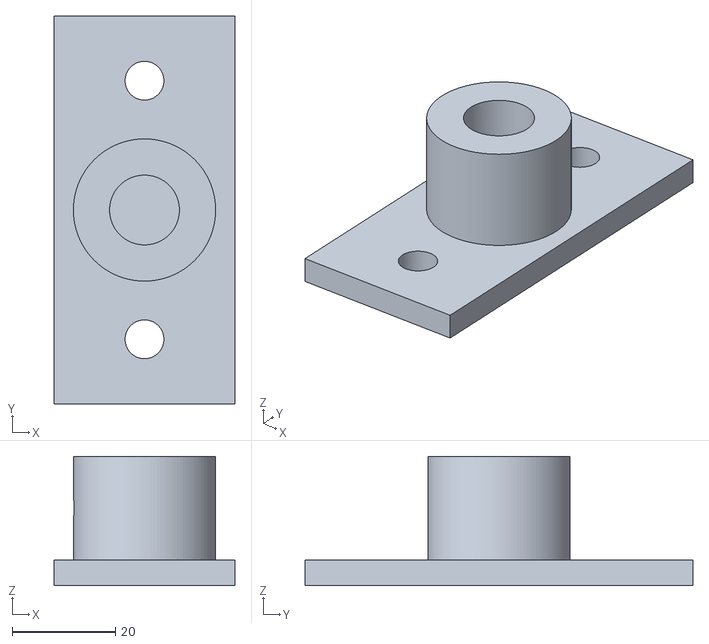
[picture p94: CAD file, 2022-10-31]
3D model/Files for printing/control board housing V1.0-complete bracket breadboard.stl
35.0 x 75.0 x 25.0
