mdanderson03/SpectrePlex/3D model/Files for printing/prototype_upper_mold_window_form.stl

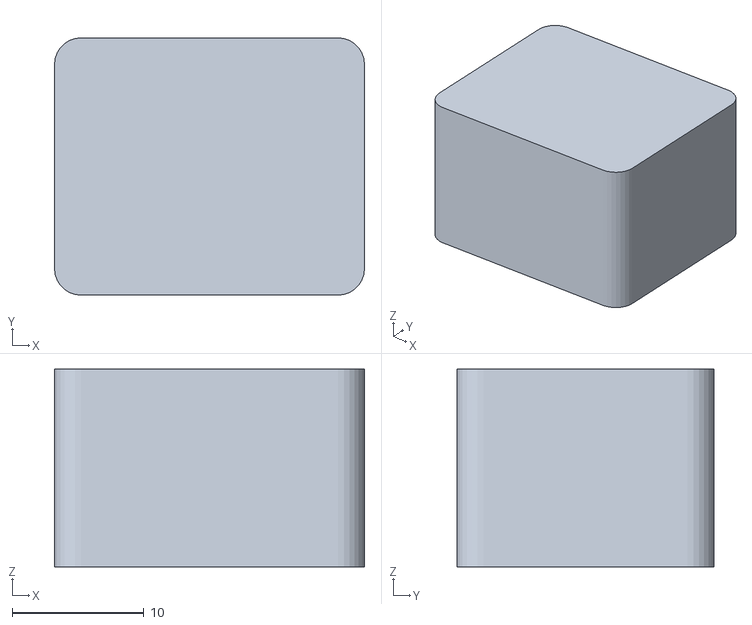
[picture p95: CAD file, 2025-05-16]
3D model/Files for printing/prototype_upper_mold_window_form.stl
23.5 x 19.5 x 15.0
