mdanderson03/SpectrePlex/3D model/prototype_upper_mold_jig_closed-Body.stl

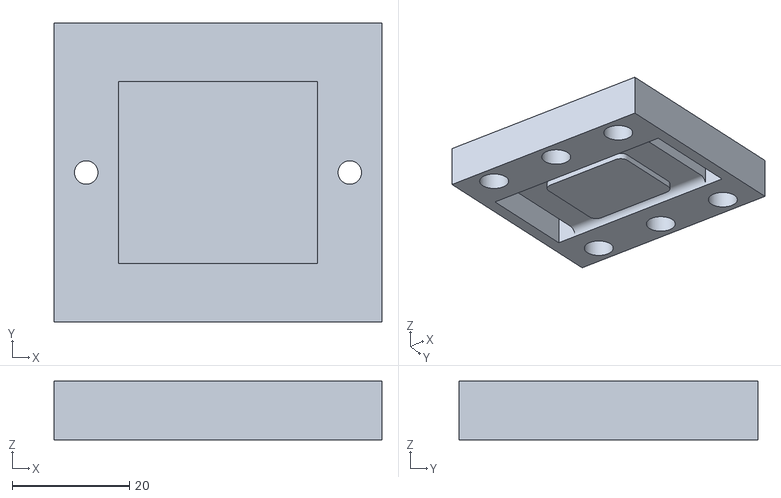
[picture p96: CAD file, 2025-05-16]
3D model/prototype_upper_mold_jig_closed-Body.stl
56.0 x 51.0 x 10.0
