mdanderson03/SpectrePlex/3D model/chamber eye sllide V5.3_aluminum.FCStd

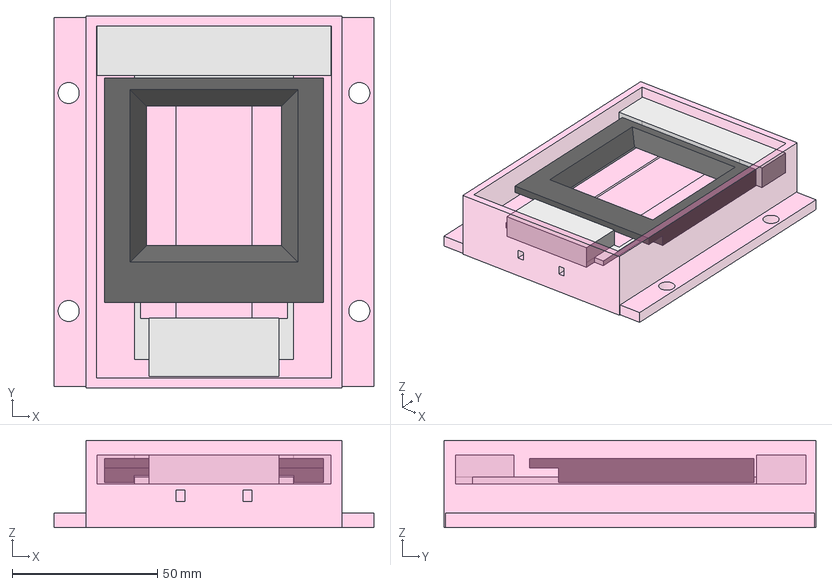
[picture p97: CAD file, 2025-05-16]
3D model/chamber eye sllide V5.3_aluminum.FCStd
110.0 x 128.0 x 30.0 mm
Main Body
pressure plate body
