mdanderson03/SpectrePlex/3D model/Files for printing/window form fluidic device V1.1-Square Model.stl

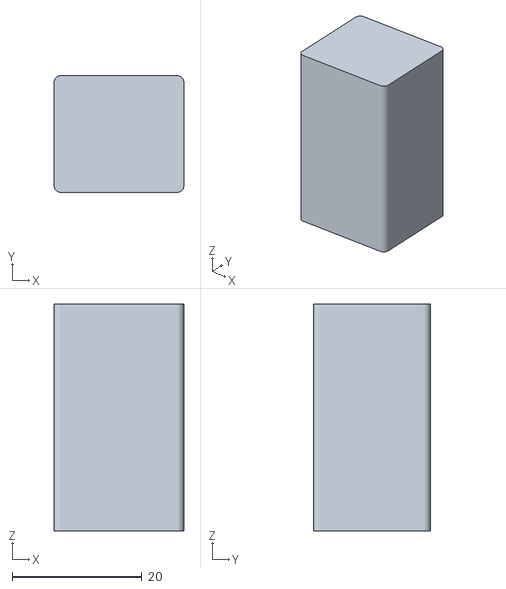
[picture p98: CAD file, 2025-05-16]
3D model/Files for printing/window form fluidic device V1.1-Square Model.stl
20.0 x 18.0 x 35.0
