mdanderson03/SpectrePlex/3D model/chamber V5.2_aluminum_analysis.FCStd

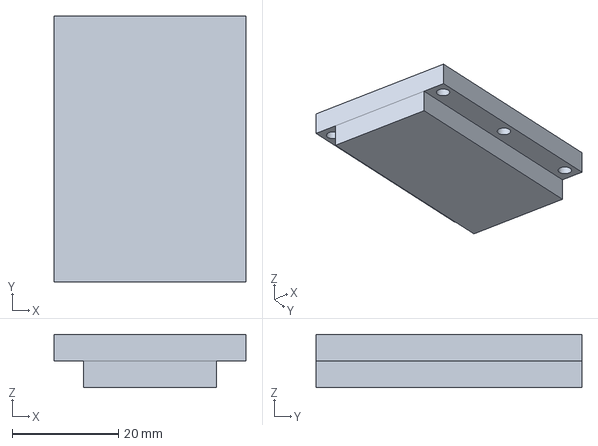
[picture p99: CAD file, 2025-05-16]
3D model/chamber V5.2_aluminum_analysis.FCStd
36.0 x 50.0 x 10.0 mm
