mdanderson03/SpectrePlex/3D model/Files for printing/prototype_upper_mold_jig-Body.stl

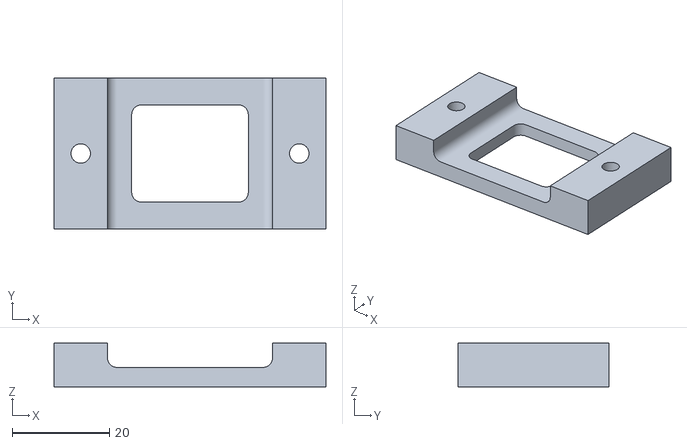
[picture p100: CAD file, 2025-05-16]
3D model/Files for printing/prototype_upper_mold_jig-Body.stl
56.0 x 31.0 x 9.00
