mdanderson03/SpectrePlex/3D model/chamber V5.2_aluminum.FCStd

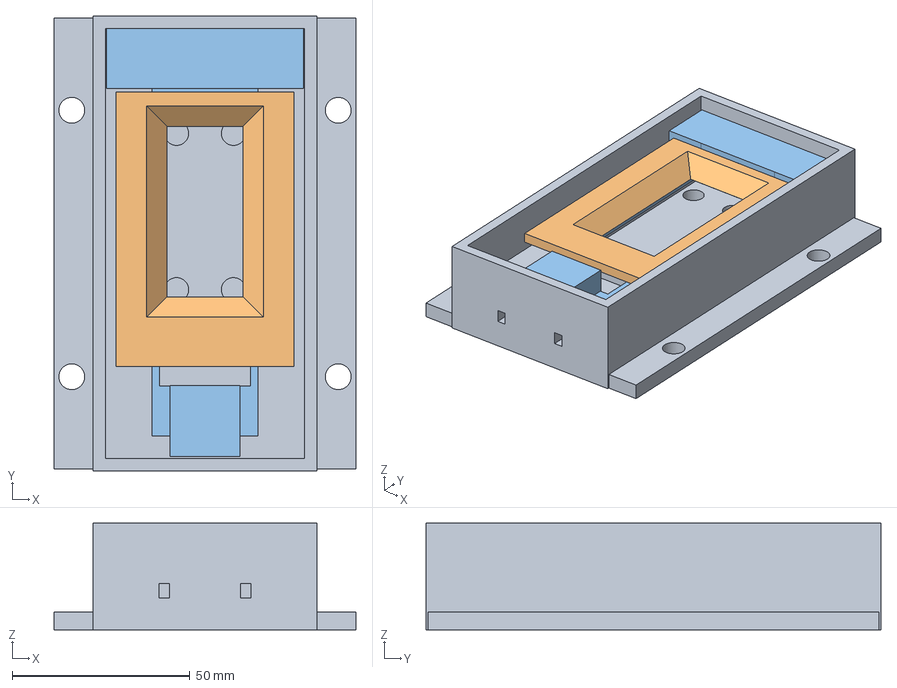
[picture p101: CAD file, 2025-05-16]
3D model/chamber V5.2_aluminum.FCStd
85.0 x 128.0 x 30.0 mm
Main Body
pressure plate body
