mdanderson03/SpectrePlex/3D model/Files for printing/chamber V5.2.stl

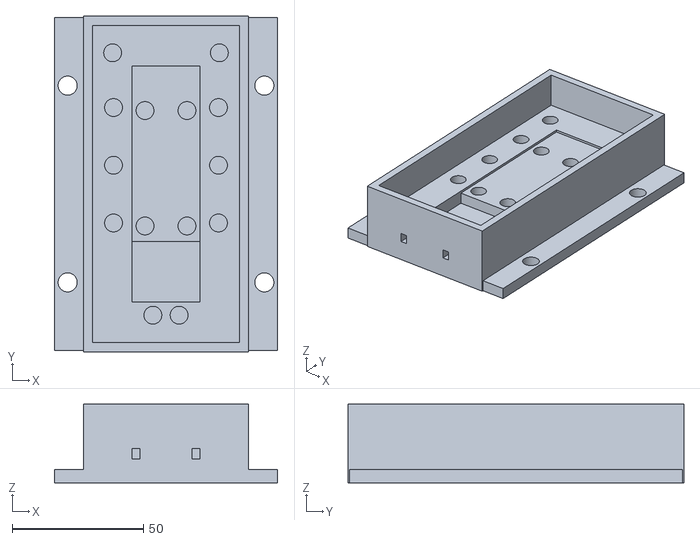
[picture p102: CAD file, 2025-05-16]
3D model/Files for printing/chamber V5.2.stl
85.0 x 128.0 x 30.0
