mdanderson03/SpectrePlex/3D model/tubing_collar_v1_0.FCStd

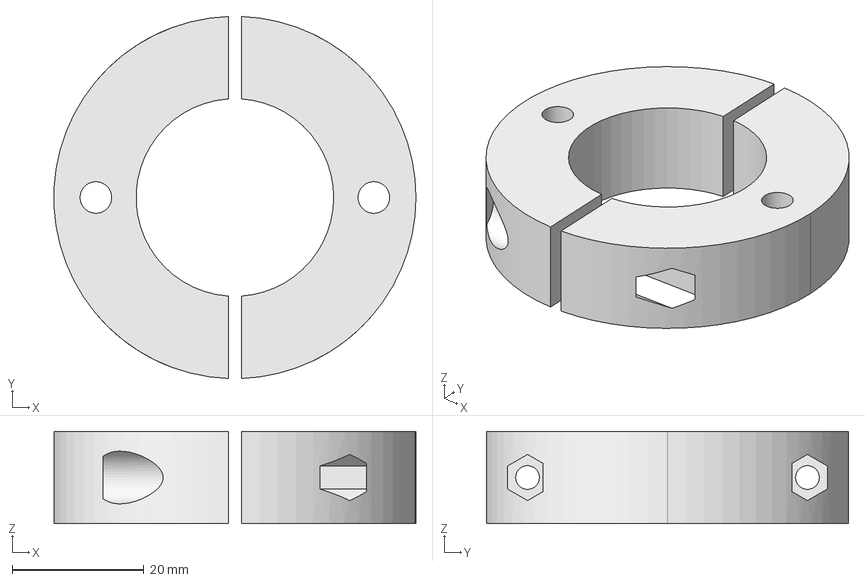
[picture p103: CAD file, 2025-05-16]
3D model/tubing_collar_v1_0.FCStd
55.0 x 55.0 x 14.0 mm
