mdanderson03/SpectrePlex/3D model/commercial_pp_V1.0.FCStd

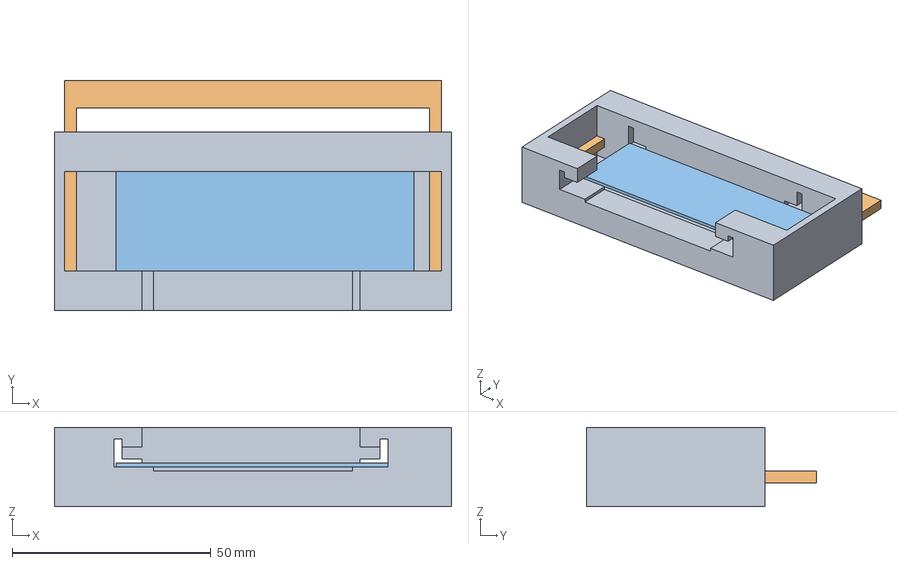
[picture p104: CAD file, 2025-05-16]
3D model/commercial_pp_V1.0.FCStd
100.0 x 58.0 x 20.0 mm
Sandwich Jig
plate wedge device
glass slide
