mdanderson03/SpectrePlex/3D model/Files for printing/chamber V5.2_aluminum-alignment jigBody_smaller.stl

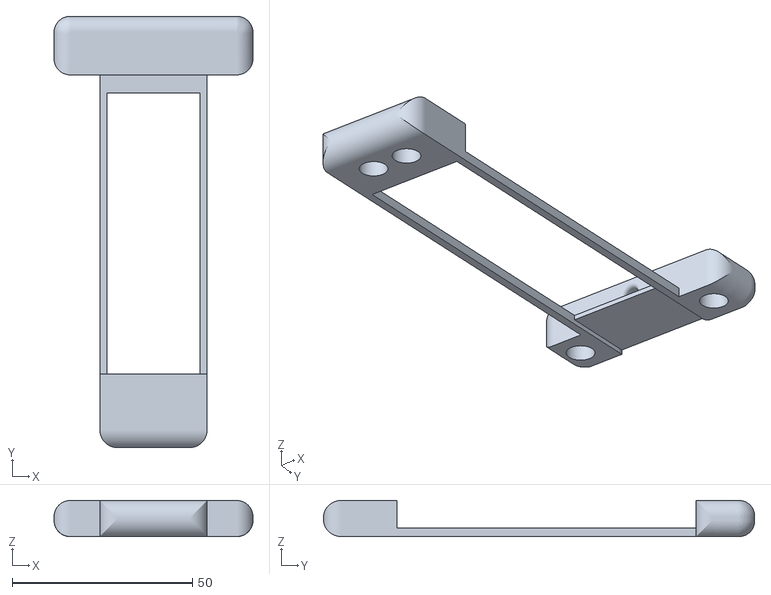
[picture p105: CAD file, 2025-05-16]
3D model/Files for printing/chamber V5.2_aluminum-alignment jigBody_smaller.stl
55.2 x 119.8 x 10.0
