mdanderson03/SpectrePlex/3D model/Files for printing/V5.2_jig.stl

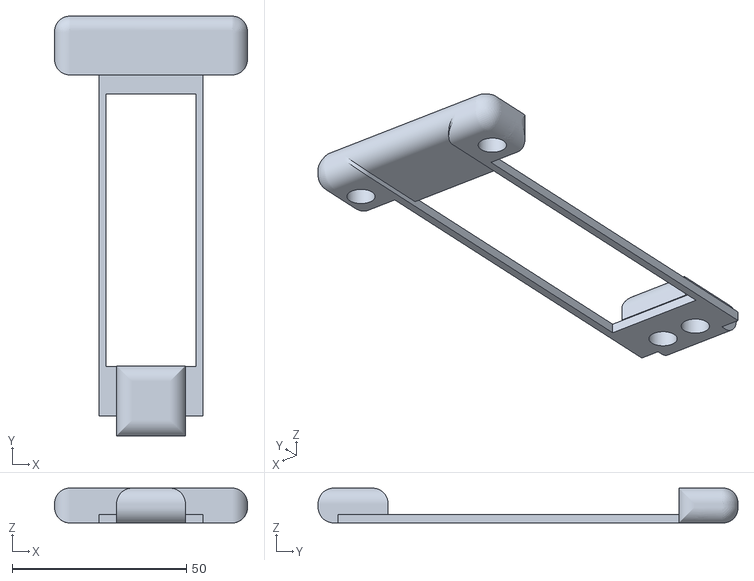
[picture p106: CAD file, 2025-05-16]
3D model/Files for printing/V5.2_jig.stl
55.4 x 120.5 x 10.0
