mdanderson03/SpectrePlex/3D model/Files for printing/chamber V5.2_aluminum-alignment jigBody008.stl

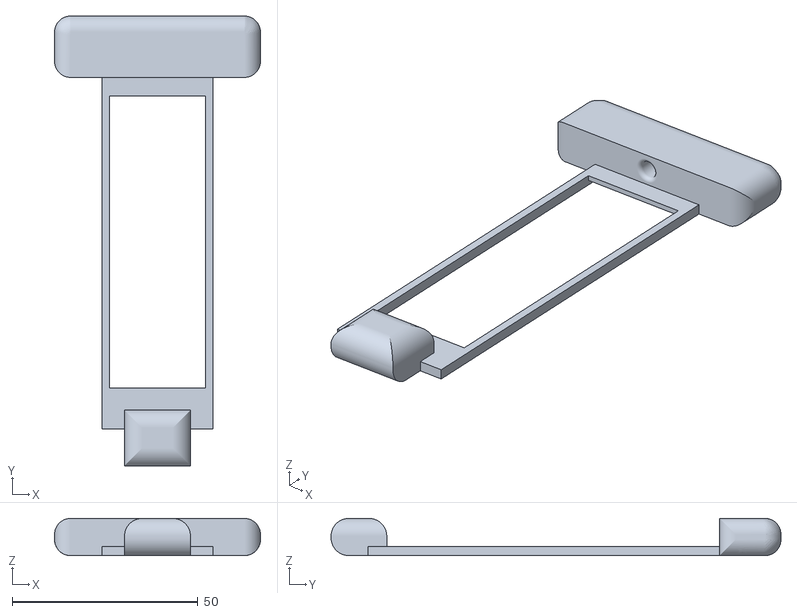
[picture p107: CAD file, 2025-05-16]
3D model/Files for printing/chamber V5.2_aluminum-alignment jigBody008.stl
55.4 x 121.0 x 10.0
