mdanderson03/SpectrePlex/3D model/Files for printing/mux_platform_v1.0-PartMUX Platform.stl

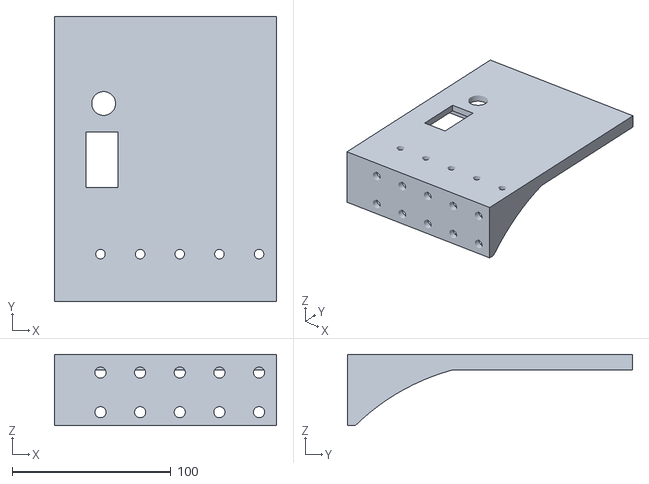
[picture p108: CAD file, 2024-03-06]
3D model/Files for printing/mux_platform_v1.0-PartMUX Platform.stl
140.0 x 180.0 x 45.0
