mdanderson03/SpectrePlex/3D model/Files for printing/chamber V5.1-align_jig.stl

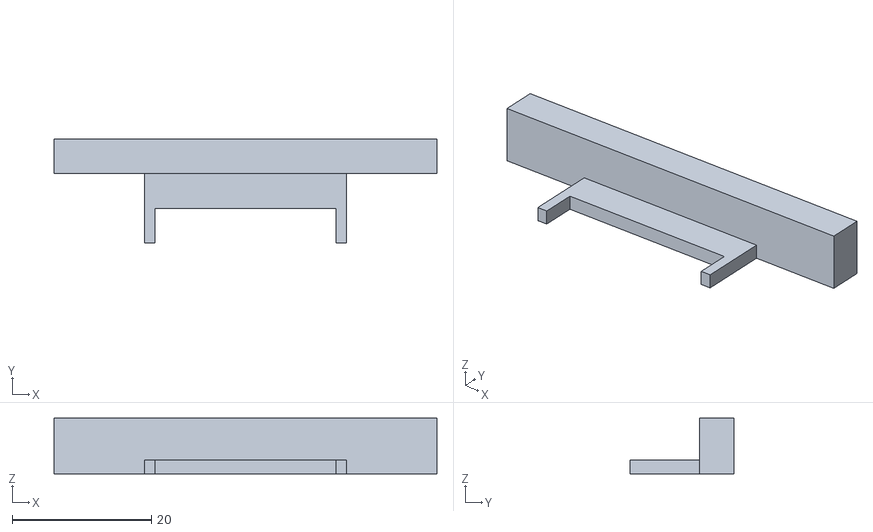
[picture p109: CAD file, 2024-03-06]
3D model/Files for printing/chamber V5.1-align_jig.stl
55.0 x 15.0 x 8.00
