mdanderson03/SpectrePlex/3D model/Files for printing/eppendorf_mount V2.0-mount_plate.stl

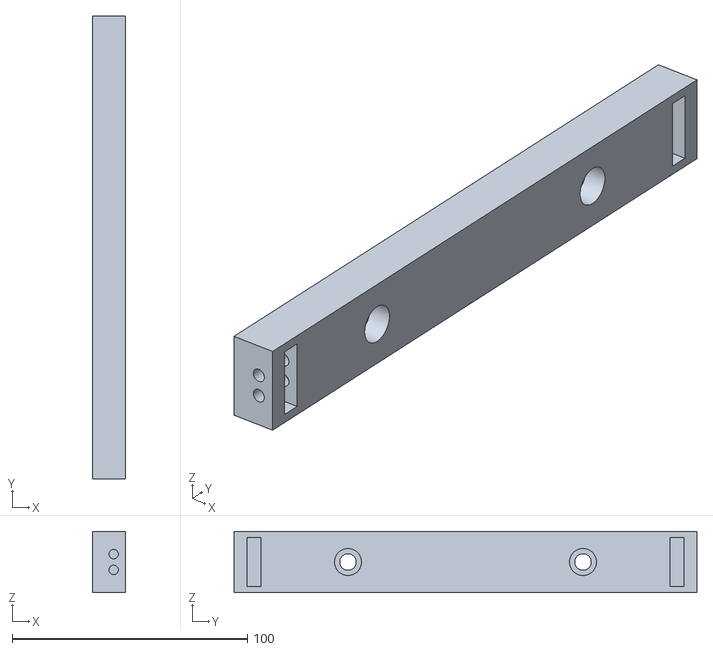
[picture p110: CAD file, 2024-03-06]
3D model/Files for printing/eppendorf_mount V2.0-mount_plate.stl
14.0 x 197.0 x 26.0
