mdanderson03/SpectrePlex/3D model/chamber V5.1.FCStd

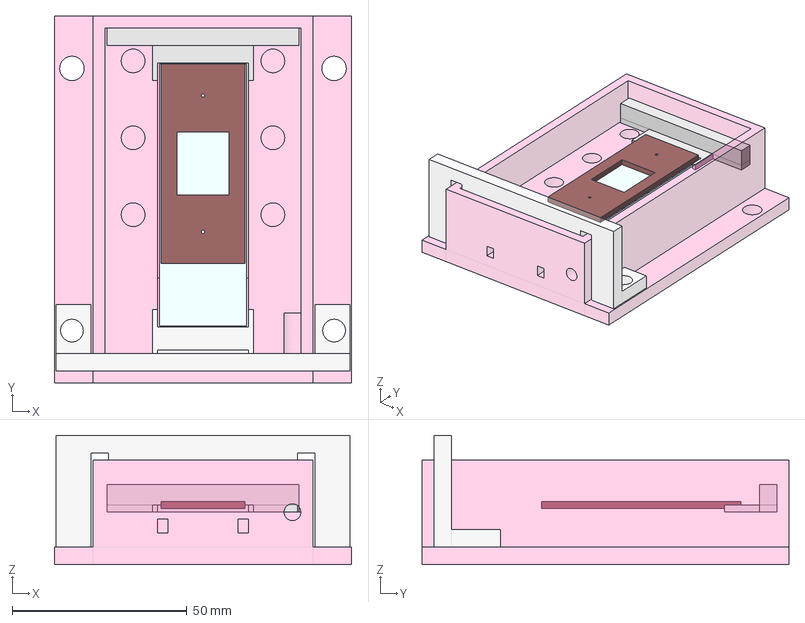
[picture p111: CAD file, 2024-03-06]
3D model/chamber V5.1.FCStd
85.0 x 105.0 x 37.0 mm
Main Body
invisi_slip
slide
