mdanderson03/SpectrePlex/3D model/Files for printing/eppendorf_mount V3.0.stl

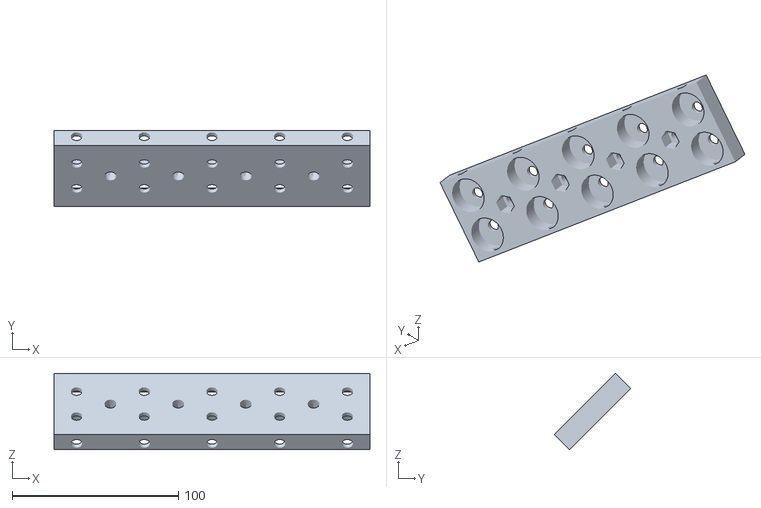
[picture p112: CAD file, 2024-03-06]
3D model/Files for printing/eppendorf_mount V3.0.stl
190.0 x 46.0 x 46.0
