mdanderson03/SpectrePlex/3D model/eppendorf_mount V3.0.FCStd

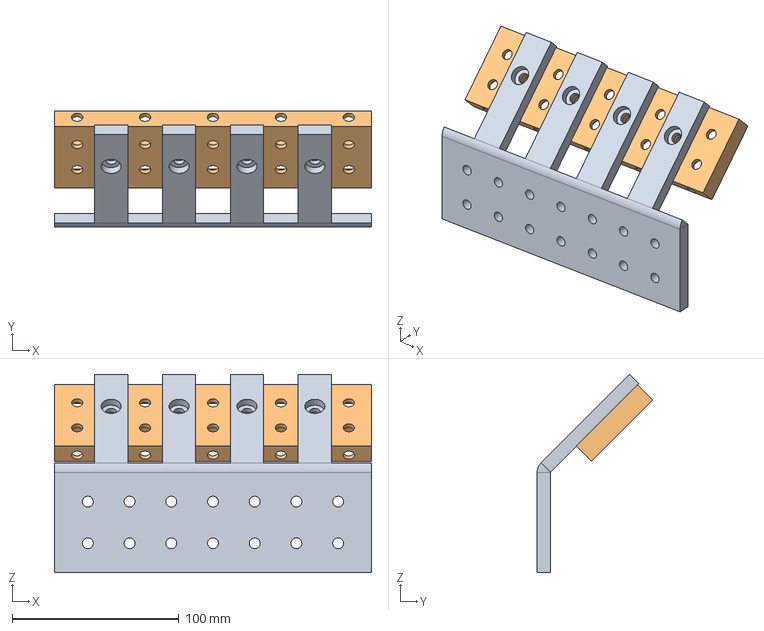
[picture p113: CAD file, 2024-03-06]
3D model/eppendorf_mount V3.0.FCStd
190.0 x 69.4 x 118.7 mm
Mount Plate
Full Eppendford mount body
