mdanderson03/SpectrePlex/3D model/Files for printing/chamber V5.0-Pressure Platepressure plate body_7mm_sockets.stl

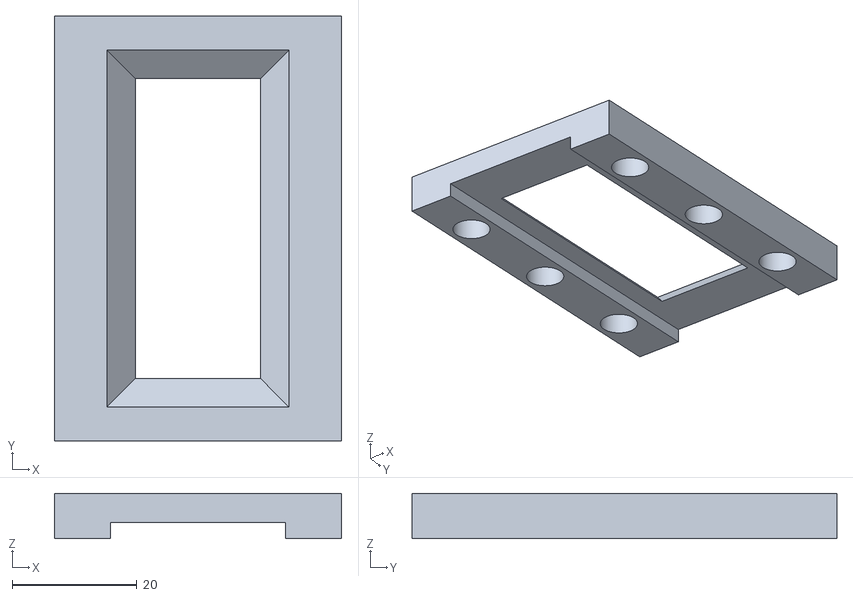
[picture p114: CAD file, 2024-03-06]
3D model/Files for printing/chamber V5.0-Pressure Platepressure plate body_7mm_sockets.stl
46.0 x 68.0 x 7.20
