mdanderson03/SpectrePlex/3D model/Files for printing/chamber V5.0-Pressure Platepressure plate body_3mm_riser_3mm_mag.stl

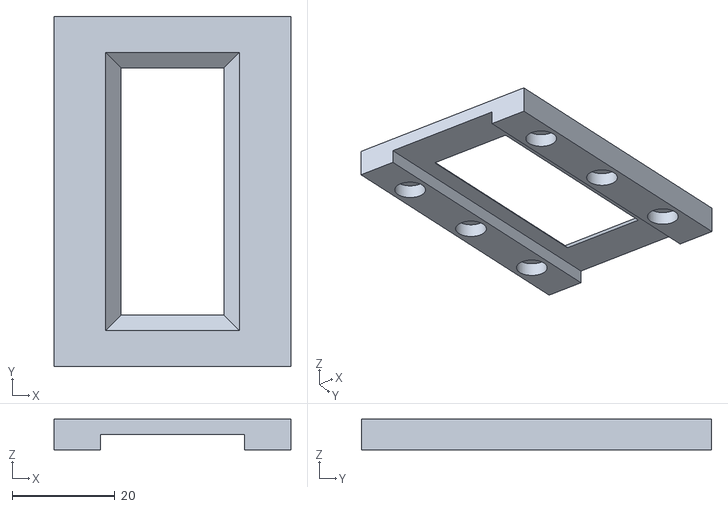
[picture p115: CAD file, 2024-03-06]
3D model/Files for printing/chamber V5.0-Pressure Platepressure plate body_3mm_riser_3mm_mag.stl
46.0 x 68.0 x 6.00
