mdanderson03/SpectrePlex/3D model/Files for printing/eppendorf_mount_plate V3.0.stl

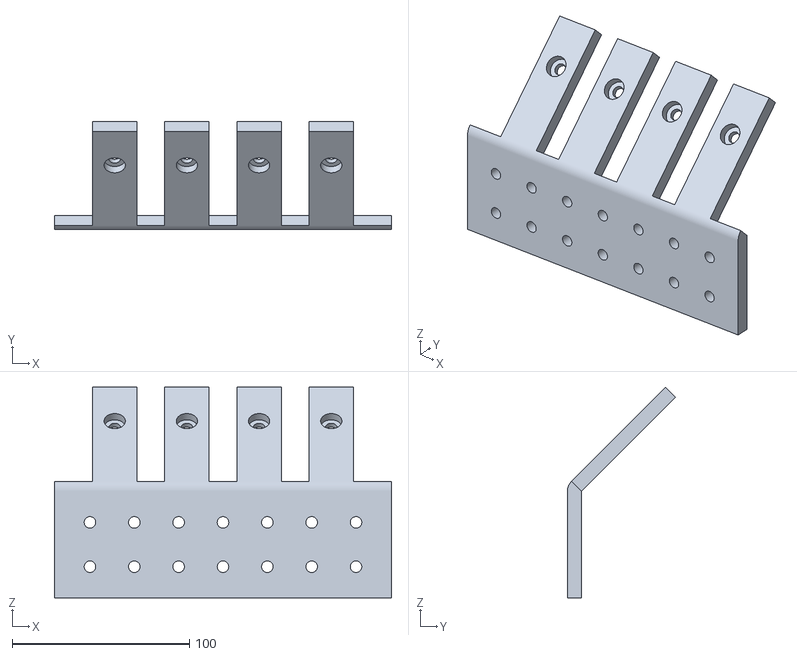
[picture p116: CAD file, 2024-03-06]
3D model/Files for printing/eppendorf_mount_plate V3.0.stl
190.0 x 61.0 x 118.7
