mdanderson03/SpectrePlex/3D model/mux_platform_v1.0.FCStd

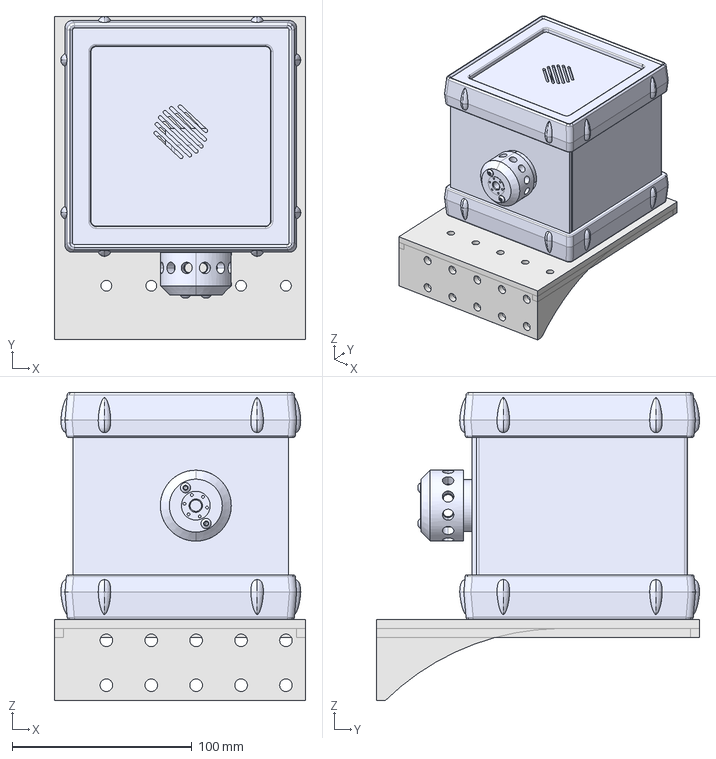
[picture p117: CAD file, 2024-03-06]
3D model/mux_platform_v1.0.FCStd
140.0 x 180.0 x 171.5 mm
MUX Platform
Mux_distribution
