mdanderson03/SpectrePlex/3D model/Files for printing/eppendorf_mount V2.0-holder.stl

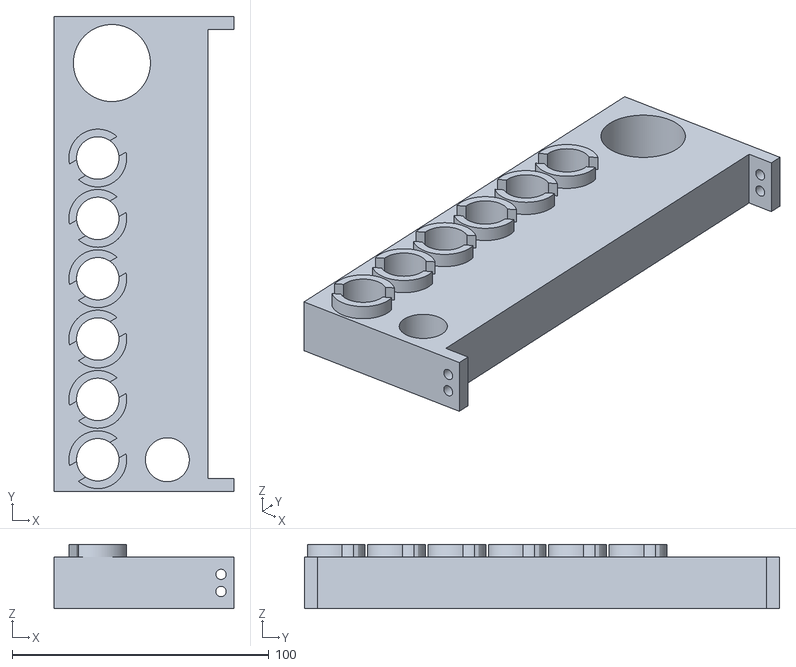
[picture p118: CAD file, 2024-03-06]
3D model/Files for printing/eppendorf_mount V2.0-holder.stl
70.0 x 185.0 x 25.0
