mdanderson03/SpectrePlex/3D model/chamber_v4_0_recovered.FCStd

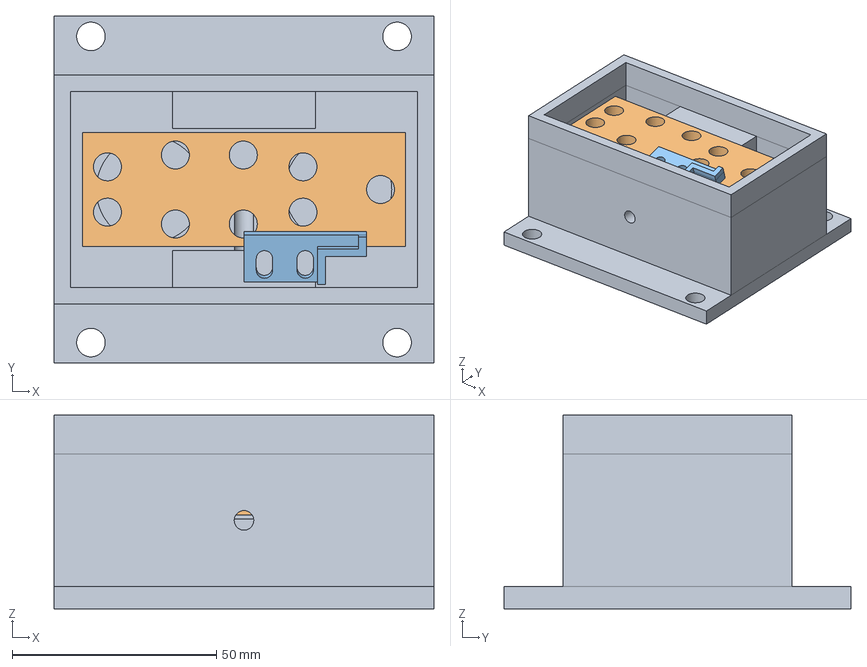
[picture p119: CAD file, 2022-12-05]
3D model/chamber_v4_0_recovered.FCStd
93.0 x 85.0 x 47.5 mm
outer chamber with mag screws
inner chamber bottom base with mag sockets
shaft and arm body
