mdanderson03/SpectrePlex/3D model/Files for printing/chamber V5.0-Pressure Platepressure plate body_3mm_sockets.stl

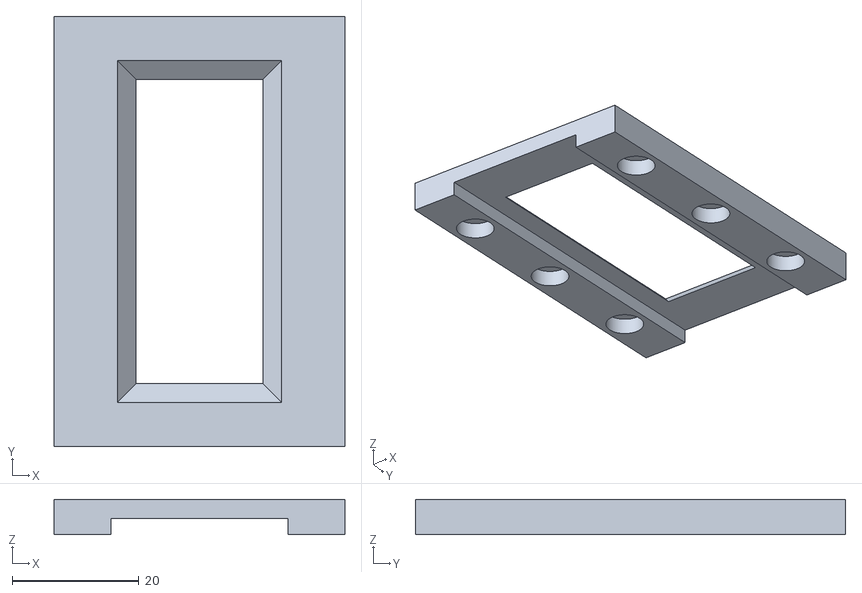
[picture p120: CAD file, 2024-03-06]
3D model/Files for printing/chamber V5.0-Pressure Platepressure plate body_3mm_sockets.stl
46.0 x 68.0 x 5.60
