mdanderson03/SpectrePlex/3D model/Files for printing/chamber V5.1-right jigBody_device_jig.stl

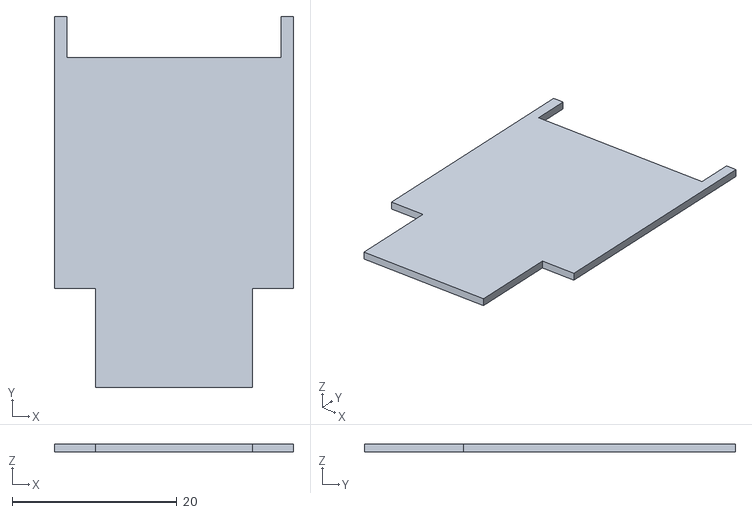
[picture p121: CAD file, 2024-03-06]
3D model/Files for printing/chamber V5.1-right jigBody_device_jig.stl
29.0 x 45.0 x 1.00
