mdanderson03/SpectrePlex/3D model/Files for printing/chamber V5.1-right jigBody.stl

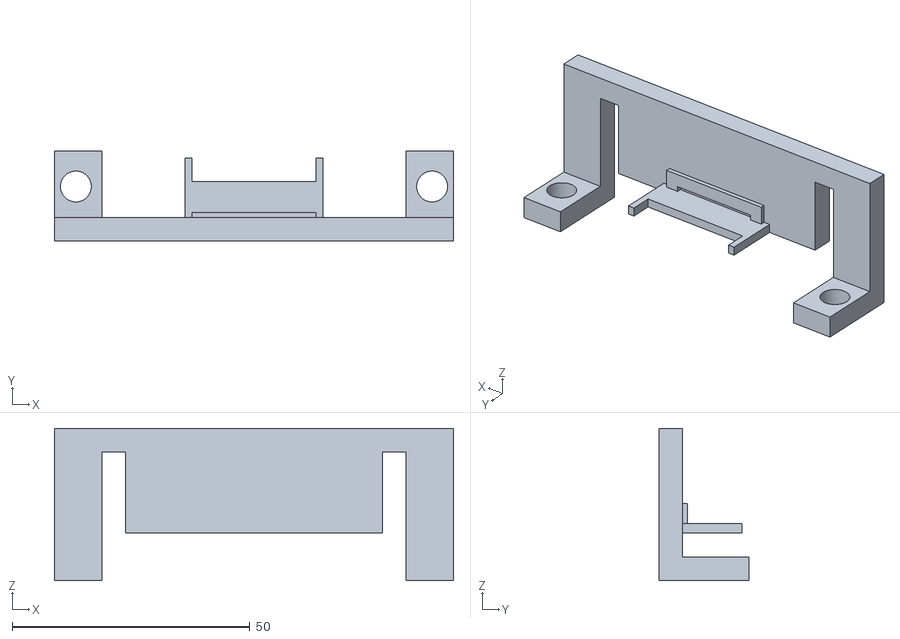
[picture p122: CAD file, 2024-03-06]
3D model/Files for printing/chamber V5.1-right jigBody.stl
84.0 x 19.0 x 32.0
