mdanderson03/SpectrePlex/3D model/Files for printing/chamber_v4_2-ChamberFusion016.stl

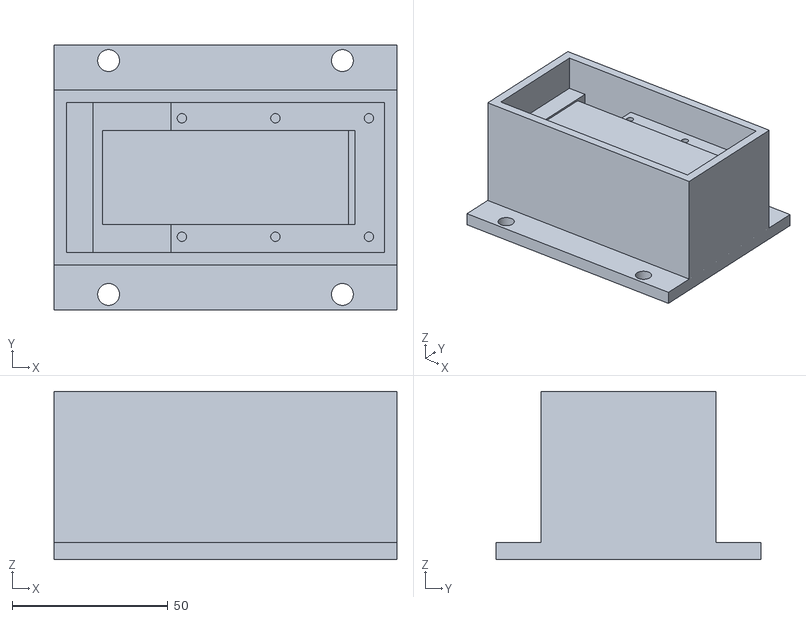
[picture p123: CAD file, 2024-03-06]
3D model/Files for printing/chamber_v4_2-ChamberFusion016.stl
110.0 x 85.0 x 54.0
