mdanderson03/SpectrePlex/3D model/sensor module.FCStd

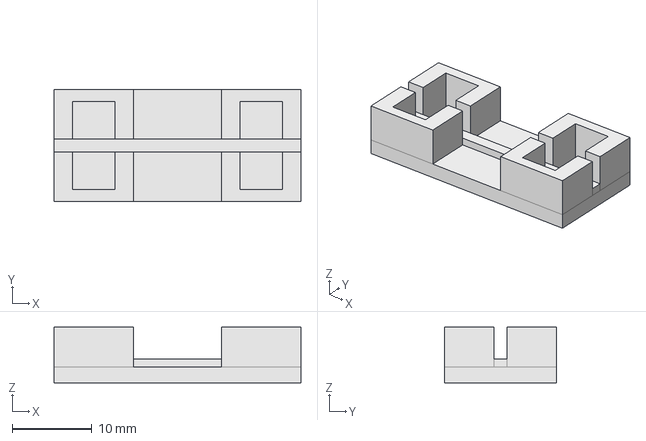
[picture p124: CAD file, 2022-10-31]
3D model/sensor module.FCStd
31.0 x 14.0 x 7.00 mm
