mdanderson03/SpectrePlex/3D model/Files for printing/window form fluidic device V1.1-Body.stl

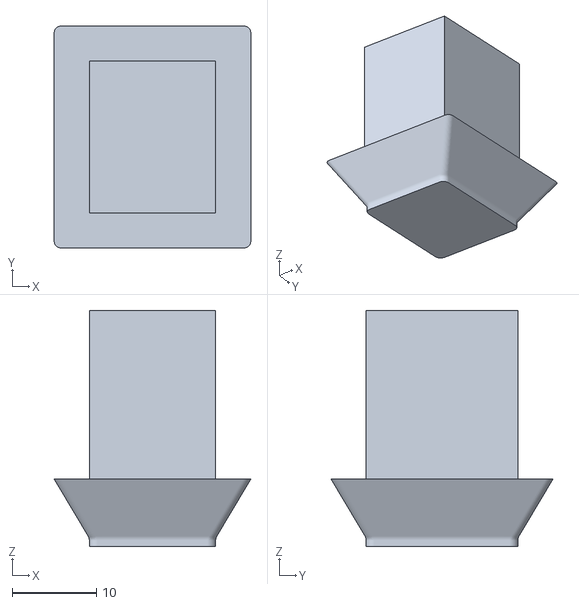
[picture p125: CAD file, 2024-03-06]
3D model/Files for printing/window form fluidic device V1.1-Body.stl
23.3 x 26.3 x 28.0
