mdanderson03/SpectrePlex/3D model/Files for printing/chamber V5.1-Pressure Platepressure plate body.step

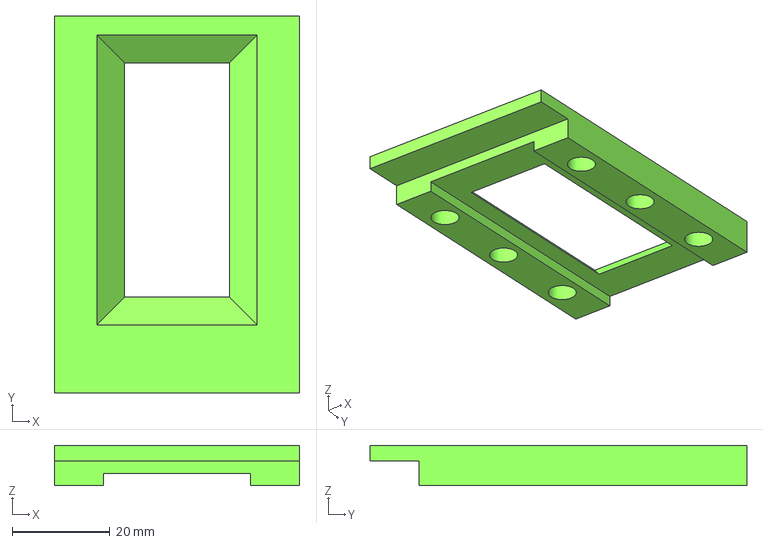
[picture p126: CAD file, 2024-03-06]
3D model/Files for printing/chamber V5.1-Pressure Platepressure plate body.step
50.2 x 77.2 x 8.20 mm
