mdanderson03/SpectrePlex/3D model/Files for printing/chamber_v4_2-arc pressure armentire pressure plate.stl

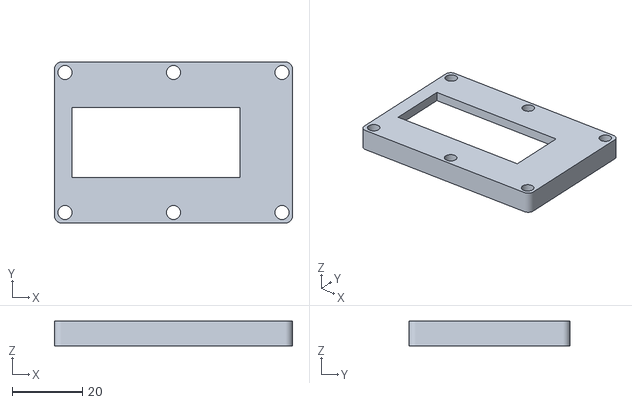
[picture p127: CAD file, 2024-03-06]
3D model/Files for printing/chamber_v4_2-arc pressure armentire pressure plate.stl
68.0 x 46.0 x 7.00
