mdanderson03/SpectrePlex/3D model/peristaltic pump breadboard mount.FCStd

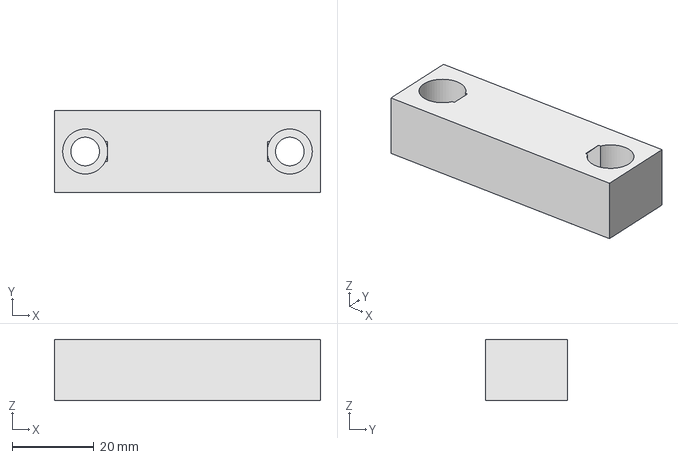
[picture p128: CAD file, 2022-10-17]
3D model/peristaltic pump breadboard mount.FCStd
65.0 x 20.0 x 15.0 mm
