mdanderson03/SpectrePlex/3D model/Files for printing/eppendorf_mount V3.0-Slice.1.stl

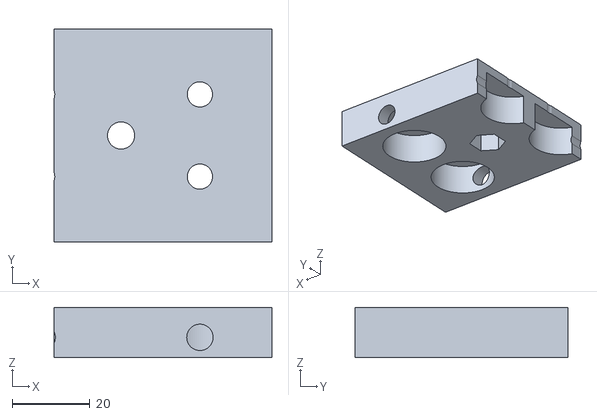
[picture p129: CAD file, 2024-03-06]
3D model/Files for printing/eppendorf_mount V3.0-Slice.1.stl
56.2 x 55.0 x 13.0
