mdanderson03/SpectrePlex/3D model/microfluidic chamber V1_0-mask 3.dxf

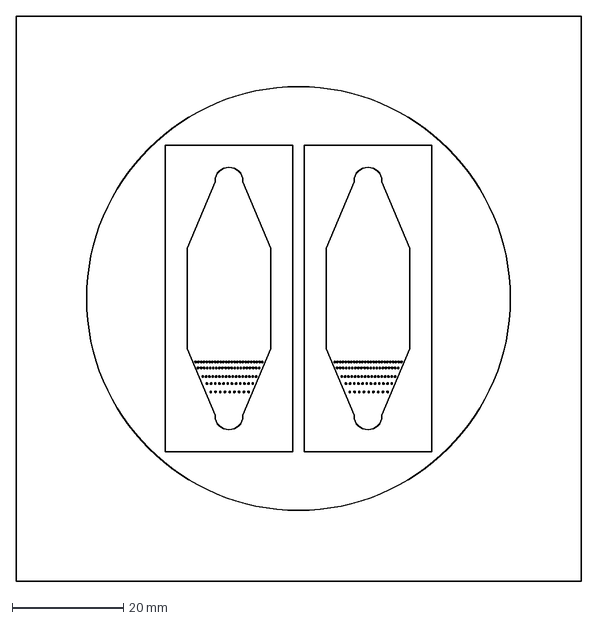
[picture p130: CAD file, 2022-10-12]
3D model/microfluidic chamber V1_0-mask 3.dxf
101.6 x 101.6 mm
