mdanderson03/SpectrePlex/3D model/microfluidic chamber V1_0-mask 4.dxf

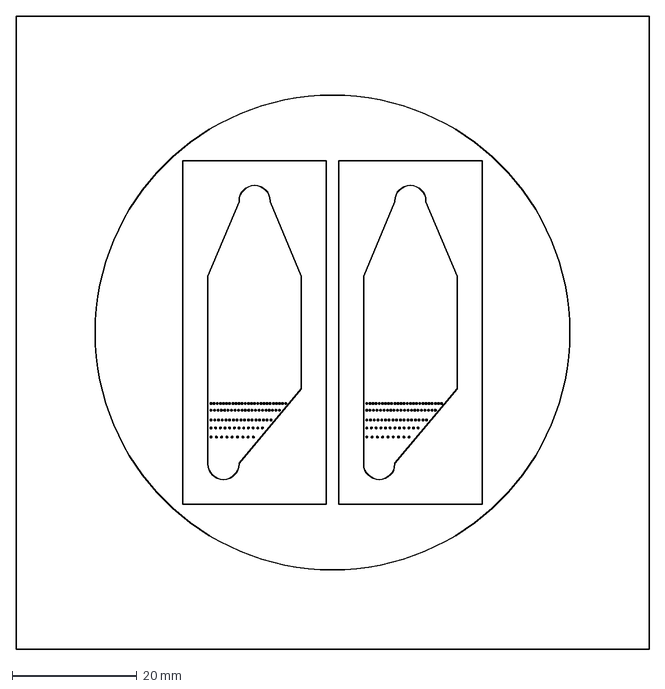
[picture p131: CAD file, 2022-10-12]
3D model/microfluidic chamber V1_0-mask 4.dxf
101.6 x 101.6 mm
