mdanderson03/SpectrePlex/3D model/microfluidic chamber V1_0-mask 5.dxf

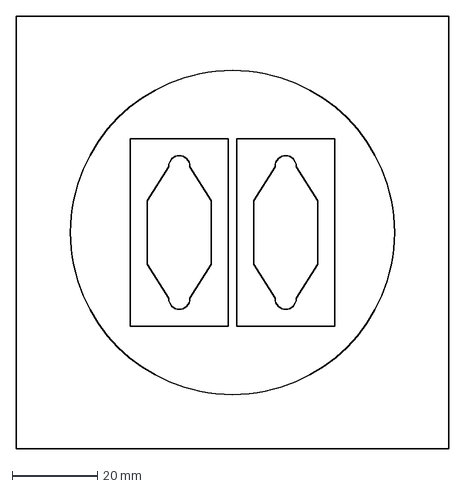
[picture p132: CAD file, 2022-10-11]
3D model/microfluidic chamber V1_0-mask 5.dxf
101.6 x 101.6 mm
