mdanderson03/SpectrePlex/3D model/Files for printing/chamber_v4_1-pressureplate.stl

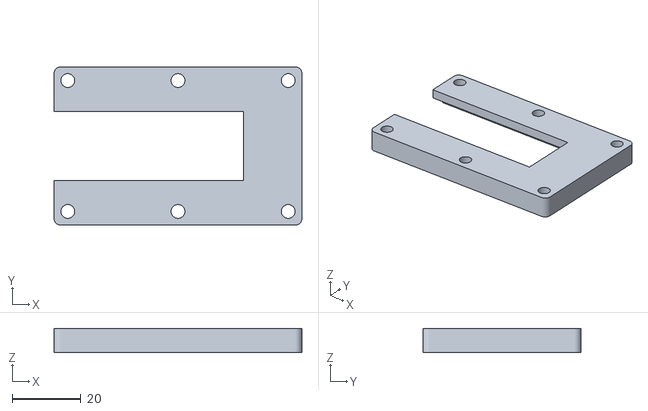
[picture p134: CAD file, 2022-12-09]
3D model/Files for printing/chamber_v4_1-pressureplate.stl
72.0 x 46.0 x 7.00
