mdanderson03/SpectrePlex/3D model/microfluidic chamber V1_0-mask 2.dxf

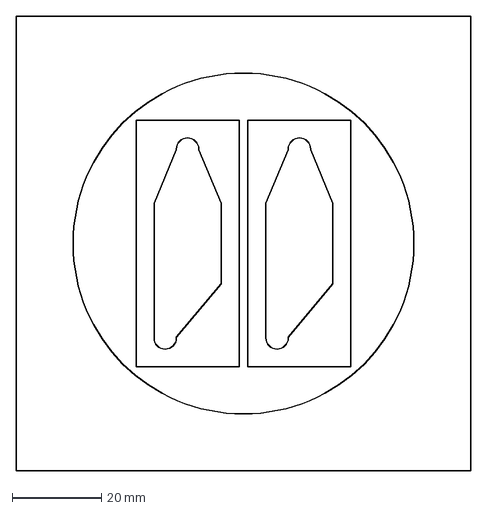
[picture p135: CAD file, 2022-10-06]
3D model/microfluidic chamber V1_0-mask 2.dxf
101.6 x 101.6 mm
