mdanderson03/SpectrePlex/3D model/Files for printing/chamber_v4_0_pressure_arm.stl

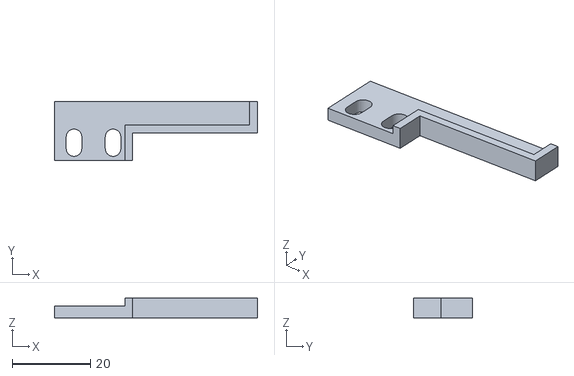
[picture p136: CAD file, 2022-12-05]
3D model/Files for printing/chamber_v4_0_pressure_arm.stl
52.0 x 15.0 x 5.00
