mdanderson03/SpectrePlex/3D model/Files for printing/chamber_v4_1-Chamberouter chamber.stl

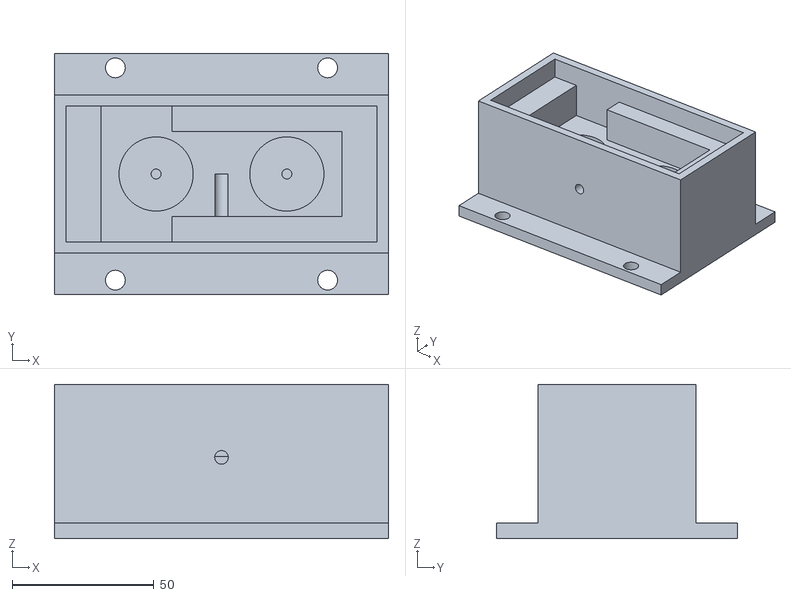
[picture p138: CAD file, 2022-12-05]
3D model/Files for printing/chamber_v4_1-Chamberouter chamber.stl
118.0 x 85.0 x 54.5
