mdanderson03/SpectrePlex/3D model/microfluidic chamber V1_0 photomask.dxf

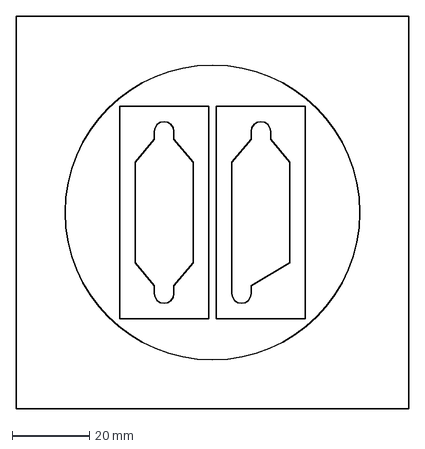
[picture p139: CAD file, 2022-09-26]
3D model/microfluidic chamber V1_0 photomask.dxf
101.6 x 101.6 mm
