mdanderson03/SpectrePlex/3D model/Files for printing/eppendorf_mount V1.1-Reservior Tube Holdereppendorf enclosure shroud.stl

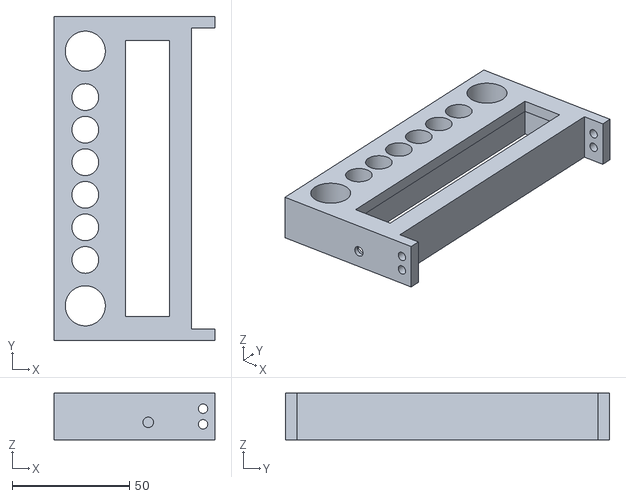
[picture p140: CAD file, 2022-11-21]
3D model/Files for printing/eppendorf_mount V1.1-Reservior Tube Holdereppendorf enclosure shroud.stl
68.6 x 138.3 x 20.0
