mdanderson03/SpectrePlex/3D model/manual_chamber v1_0.FCStd

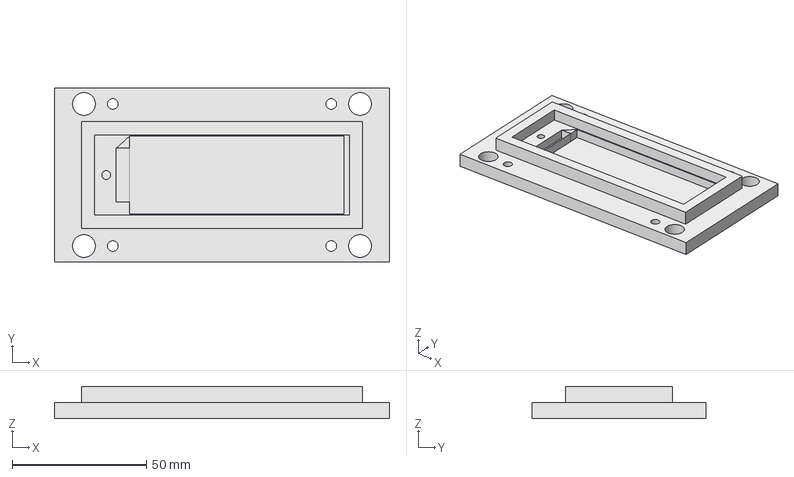
[picture p141: CAD file, 2022-09-13]
3D model/manual_chamber v1_0.FCStd
125.0 x 65.0 x 12.0 mm
