mdanderson03/SpectrePlex/3D model/chamber_v3_7 SLA.FCStd

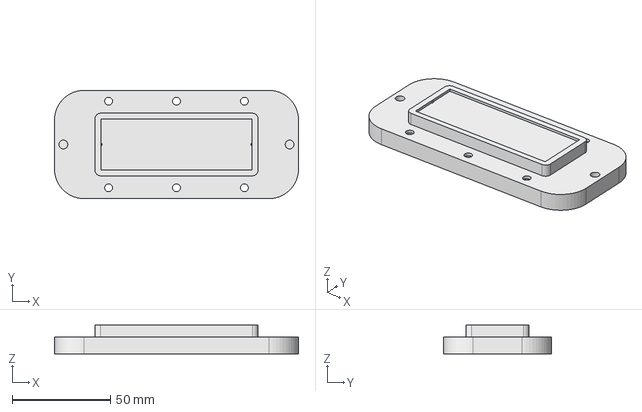
[picture p142: CAD file, 2022-08-22]
3D model/chamber_v3_7 SLA.FCStd
124.0 x 55.0 x 14.5 mm
