mdanderson03/SpectrePlex/3D model/chamber_v3_6_w_SLA_inner_upper.FCStd

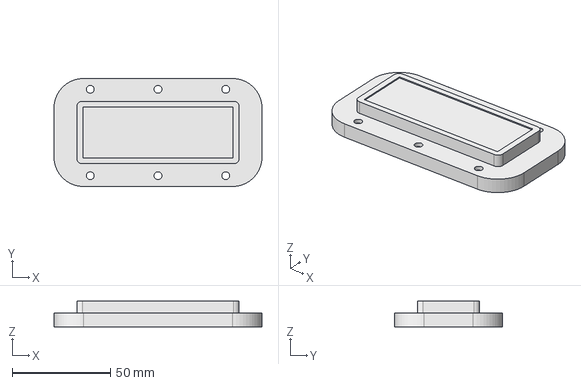
[picture p143: CAD file, 2022-08-17]
3D model/chamber_v3_6_w_SLA_inner_upper.FCStd
106.0 x 55.0 x 13.0 mm
