mdanderson03/SpectrePlex/3D model/Files for printing/chamber_v4_0_outer chamber.stl

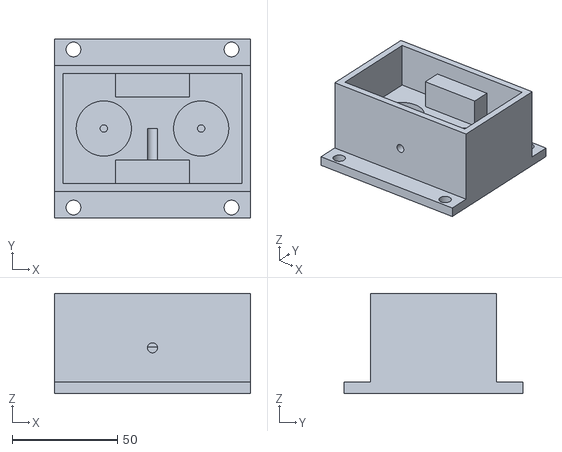
[picture p144: CAD file, 2022-10-25]
3D model/Files for printing/chamber_v4_0_outer chamber.stl
93.0 x 85.0 x 47.5
