mdanderson03/SpectrePlex/3D model/Files for printing/chamber_v4_0-inner chamber.stl

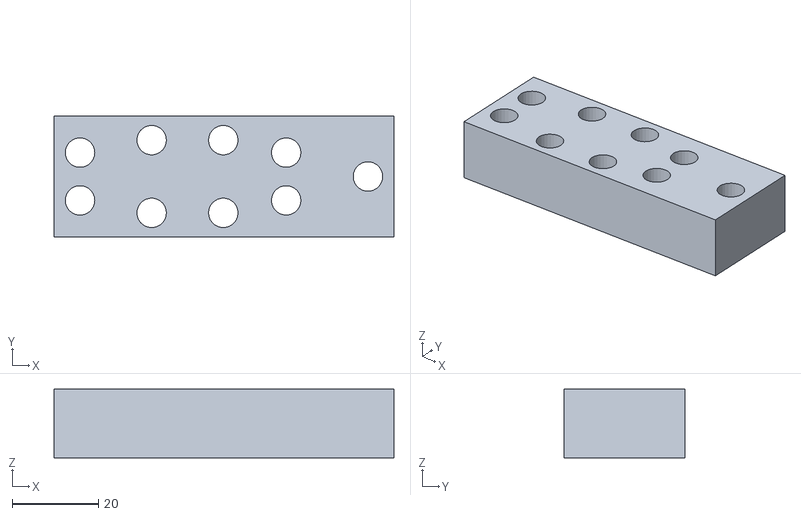
[picture p145: CAD file, 2022-10-20]
3D model/Files for printing/chamber_v4_0-inner chamber.stl
79.0 x 28.0 x 16.0
