mdanderson03/SpectrePlex/3D model/Files for printing/eppendorf_mount breadboard socket V1.0.stl

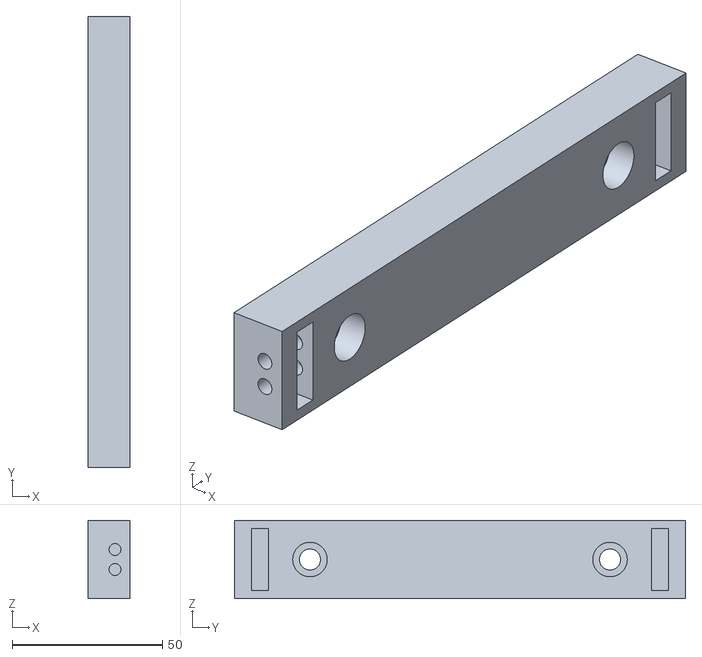
[picture p146: CAD file, 2022-10-20]
3D model/Files for printing/eppendorf_mount breadboard socket V1.0.stl
14.0 x 150.3 x 26.0
