mdanderson03/SpectrePlex/3D model/Files for printing/chamber_v4_0 inner chamber_no inset.stl

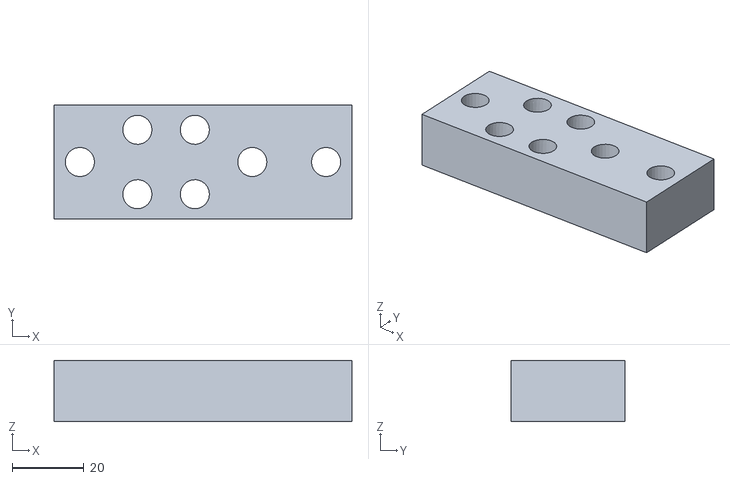
[picture p147: CAD file, 2022-09-23]
3D model/Files for printing/chamber_v4_0 inner chamber_no inset.stl
82.8 x 31.8 x 17.0
