mdanderson03/SpectrePlex/3D model/Files for printing/eppendorf_mount V1.0-support rod mount.stl

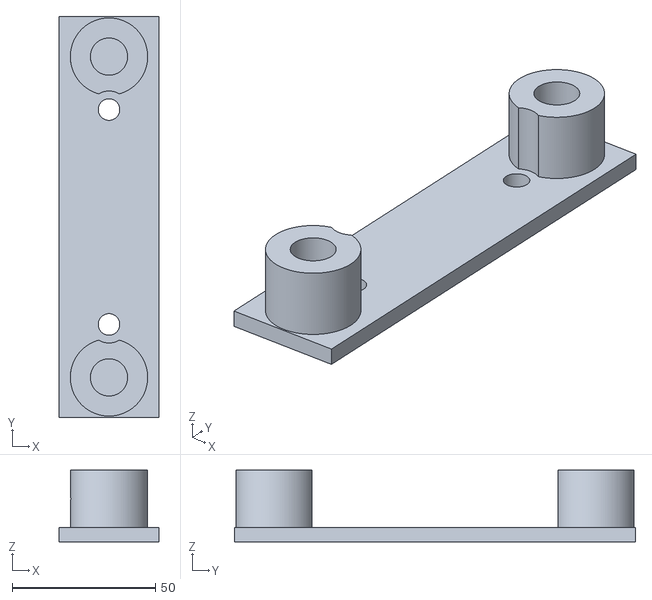
[picture p148: CAD file, 2022-09-19]
3D model/Files for printing/eppendorf_mount V1.0-support rod mount.stl
35.0 x 140.0 x 25.0
