mdanderson03/SpectrePlex/3D model/Files for printing/pinch bracket V1_0.stl

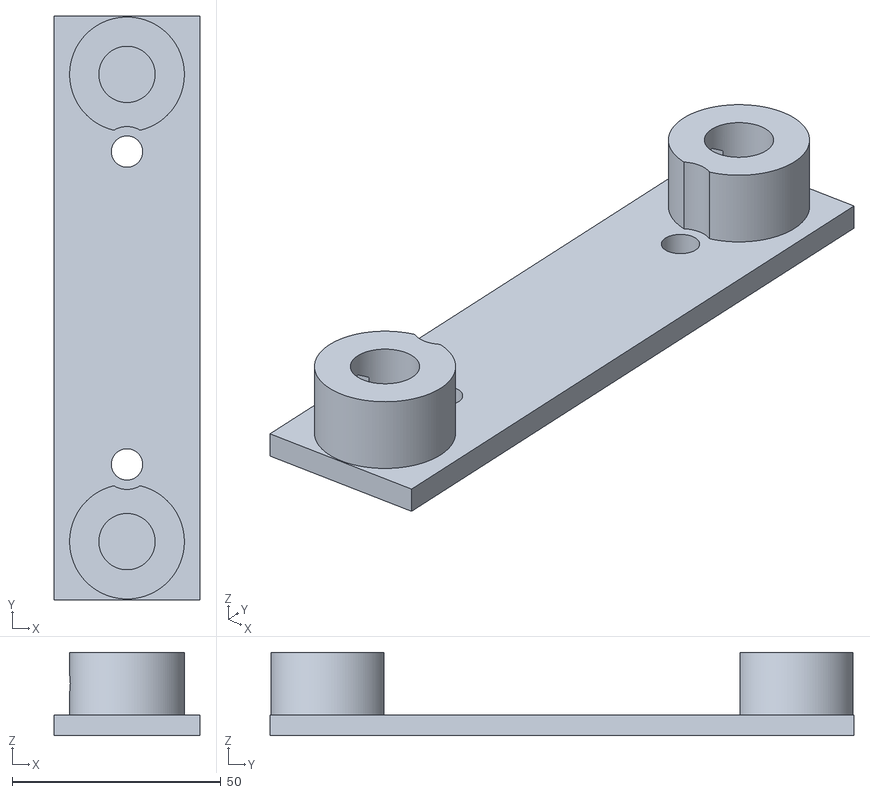
[picture p149: CAD file, 2022-09-16]
3D model/Files for printing/pinch bracket V1_0.stl
35.0 x 140.0 x 20.0
