mdanderson03/SpectrePlex/3D model/Files for printing/manual_chamber v1_0-lid.stl

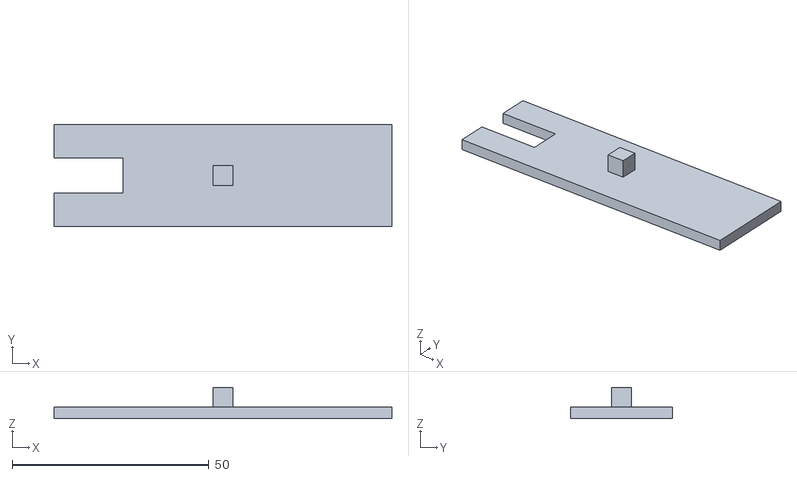
[picture p150: CAD file, 2022-08-29]
3D model/Files for printing/manual_chamber v1_0-lid.stl
86.0 x 26.0 x 8.00
