mdanderson03/SpectrePlex/3D model/Files for printing/manual_chamber v1_0-slide secure level.stl

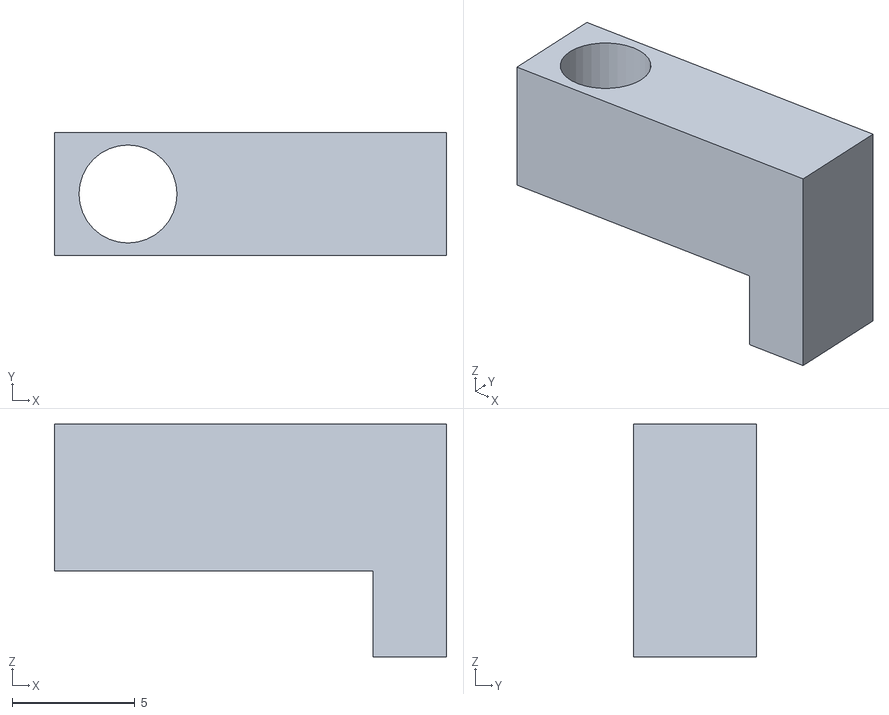
[picture p151: CAD file, 2022-08-29]
3D model/Files for printing/manual_chamber v1_0-slide secure level.stl
16.0 x 5.00 x 9.50
