mdanderson03/SpectrePlex/3D model/Files for printing/chamber_v3_7-Chambertop inner chamber_SLA.stl

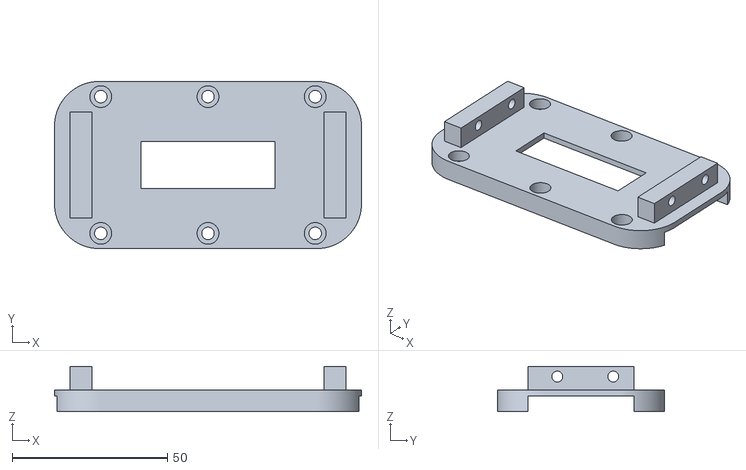
[picture p152: CAD file, 2022-08-29]
3D model/Files for printing/chamber_v3_7-Chambertop inner chamber_SLA.stl
98.8 x 53.8 x 14.5
