mdanderson03/SpectrePlex/3D model/Files for printing/control board housing V1.0-pole clamp.stl

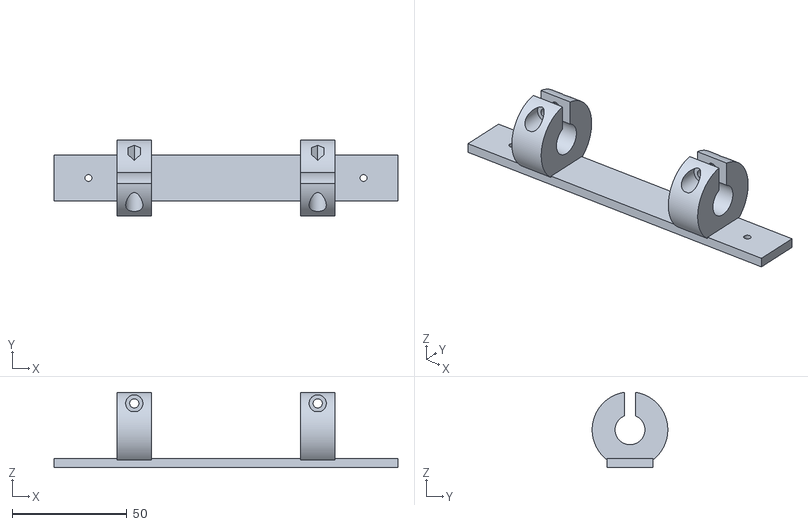
[picture p153: CAD file, 2022-08-22]
3D model/Files for printing/control board housing V1.0-pole clamp.stl
150.0 x 33.0 x 32.8
