mdanderson03/SpectrePlex/3D model/Files for printing/chamber_v3_7-Chamber_outer chamber.stl

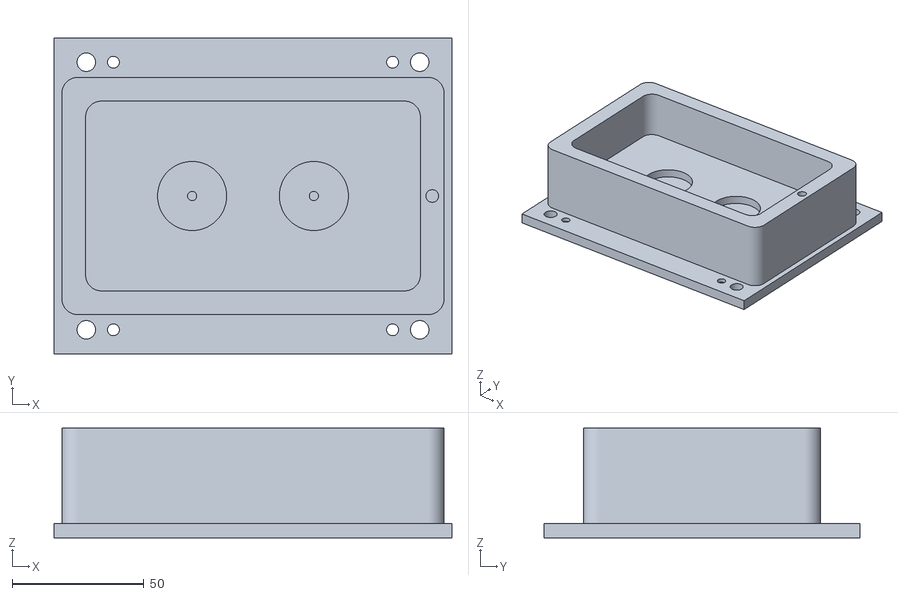
[picture p154: CAD file, 2022-08-22]
3D model/Files for printing/chamber_v3_7-Chamber_outer chamber.stl
151.0 x 120.0 x 41.6
