mdanderson03/SpectrePlex/3D model/Files for printing/chamber_v3_7-Chambertop inner chamber.stl

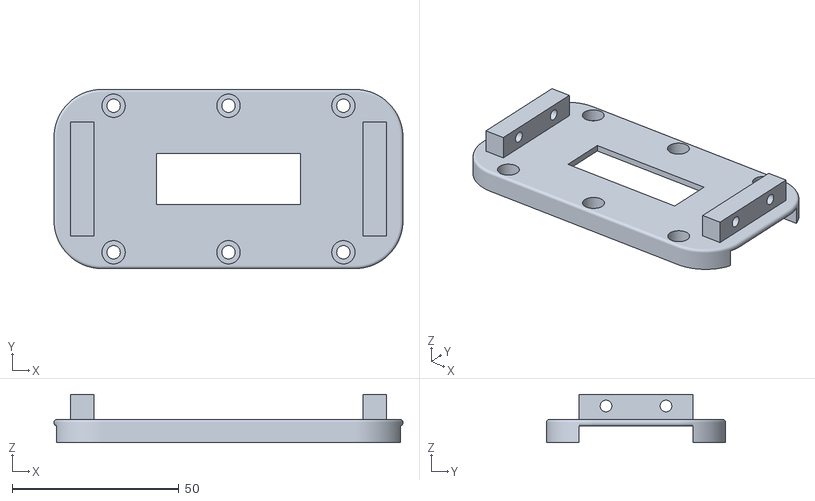
[picture p155: CAD file, 2022-08-22]
3D model/Files for printing/chamber_v3_7-Chambertop inner chamber.stl
104.8 x 53.8 x 14.5
