mdanderson03/SpectrePlex/3D model/Files for printing/chamber_v3_6-gasket cut jig.stl

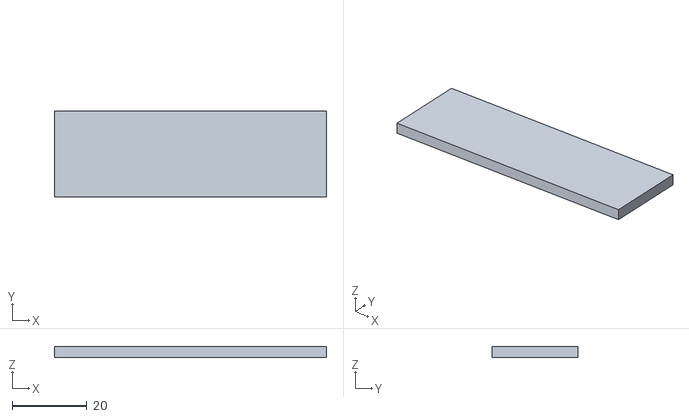
[picture p156: CAD file, 2022-08-17]
3D model/Files for printing/chamber_v3_6-gasket cut jig.stl
73.0 x 23.0 x 3.00
