mdanderson03/SpectrePlex/3D model/Files for printing/chamber_v3_6-window cut jig.stl

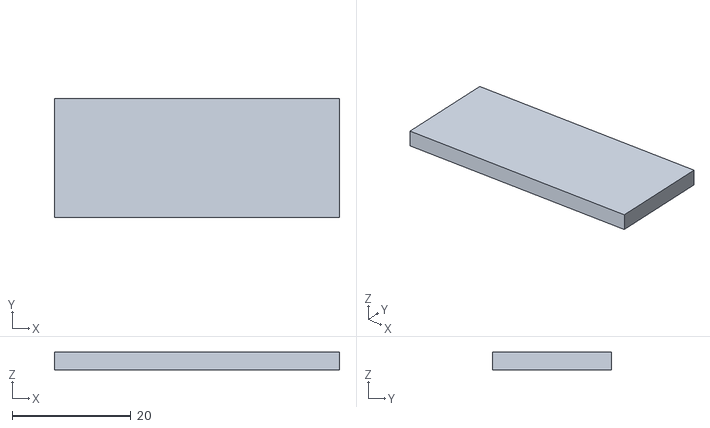
[picture p157: CAD file, 2022-08-17]
3D model/Files for printing/chamber_v3_6-window cut jig.stl
48.0 x 20.0 x 3.00
