mdanderson03/SpectrePlex/3D model/Files for printing/chamber_v3_6-window install jig.stl

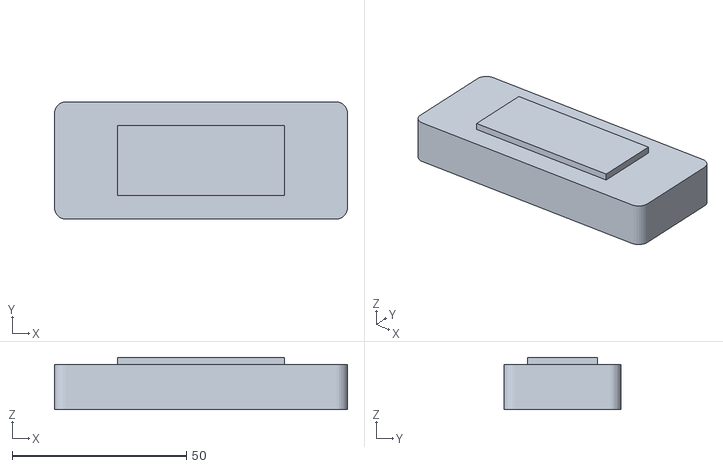
[picture p158: CAD file, 2022-08-17]
3D model/Files for printing/chamber_v3_6-window install jig.stl
84.1 x 33.6 x 15.0
