mdanderson03/SpectrePlex/3D model/Files for printing/chamber_v3_6-top inner chamber_abs.stl

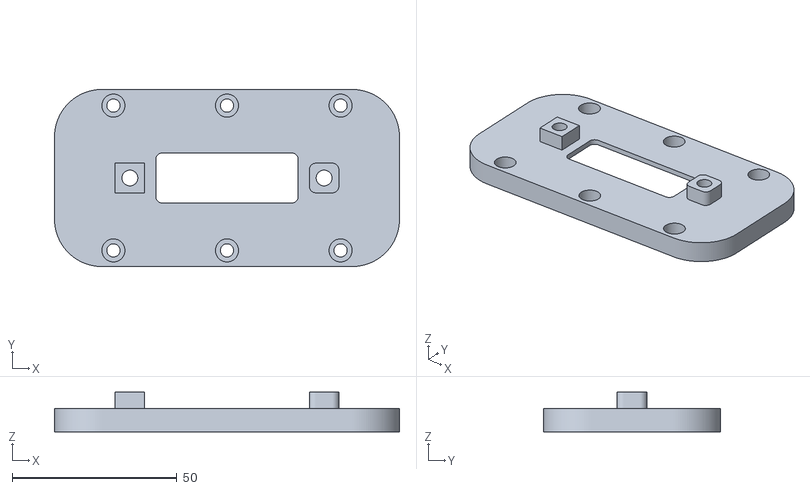
[picture p159: CAD file, 2022-08-17]
3D model/Files for printing/chamber_v3_6-top inner chamber_abs.stl
104.8 x 53.8 x 12.0
