mdanderson03/SpectrePlex/3D model/Files for printing/control board housing V1.0-housing with mounting hexnuts, BNC ports and back panel socket.stl

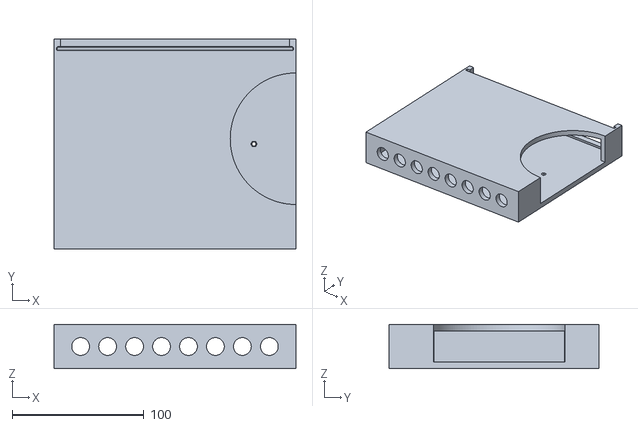
[picture p160: CAD file, 2022-08-12]
3D model/Files for printing/control board housing V1.0-housing with mounting hexnuts, BNC ports and back panel socket.stl
184.0 x 160.0 x 33.5
