mdanderson03/SpectrePlex/3D model/Files for printing/control board housing V1.0- back panel housing.stl

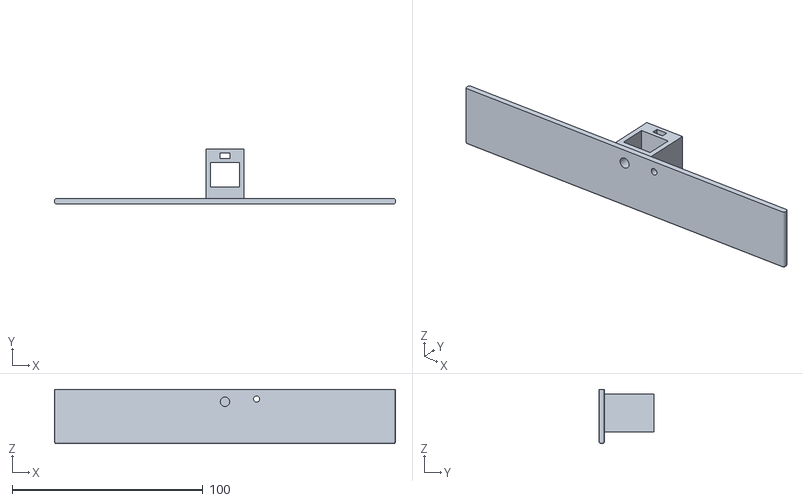
[picture p161: CAD file, 2022-08-12]
3D model/Files for printing/control board housing V1.0- back panel housing.stl
179.0 x 28.8 x 28.5
