mdanderson03/SpectrePlex/3D model/Files for printing/chamber_v3_5_inner part of outer chamber.stl

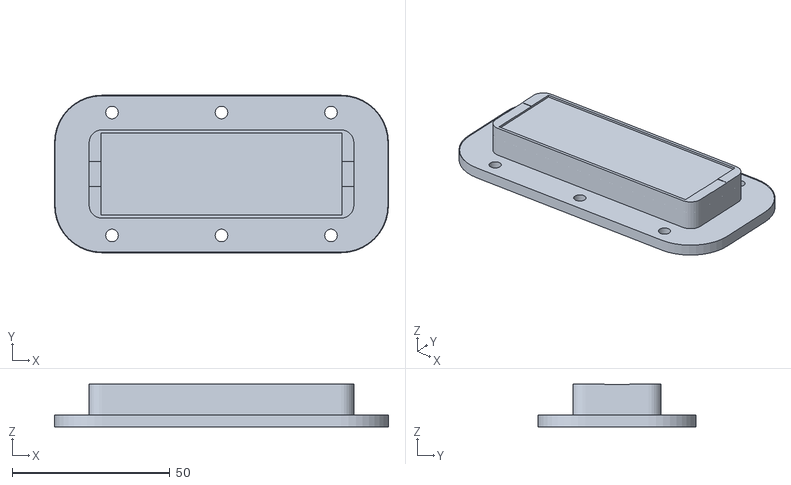
[picture p162: CAD file, 2022-08-01]
3D model/Files for printing/chamber_v3_5_inner part of outer chamber.stl
106.0 x 50.0 x 13.5
