mdanderson03/SpectrePlex/3D model/Files for printing/chamber_v3_5-inner chamber no window.stl

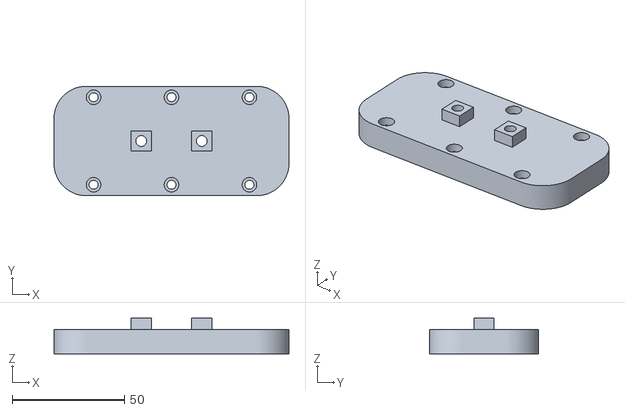
[picture p163: CAD file, 2022-08-01]
3D model/Files for printing/chamber_v3_5-inner chamber no window.stl
104.8 x 48.8 x 16.0
