mdanderson03/SpectrePlex/3D model/Files for printing/chamber_v3_5-experimental upper.obj

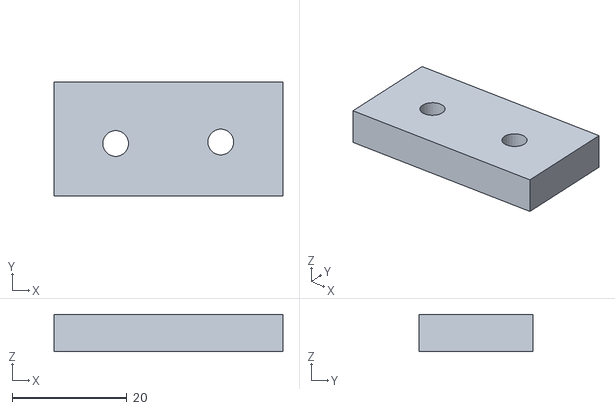
[picture p164: CAD file, 2022-08-01]
3D model/Files for printing/chamber_v3_5-experimental upper.obj
40.0 x 20.0 x 6.50
