mdanderson03/SpectrePlex/3D model/Files for printing/chamber_v3_4-slde plateau.stl

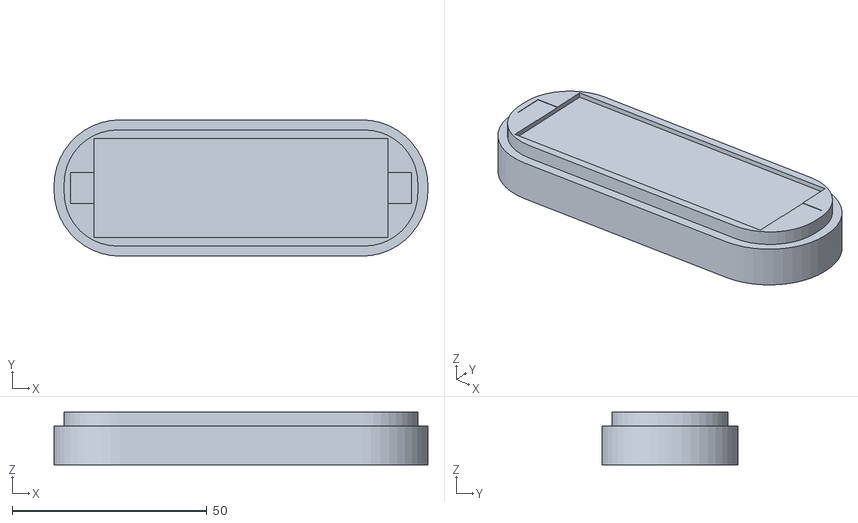
[picture p165: CAD file, 2022-07-19]
3D model/Files for printing/chamber_v3_4-slde plateau.stl
96.0 x 35.0 x 13.5
