mdanderson03/SpectrePlex/3D model/Files for printing/chamber_v3_4-outer chamber _small opening.stl

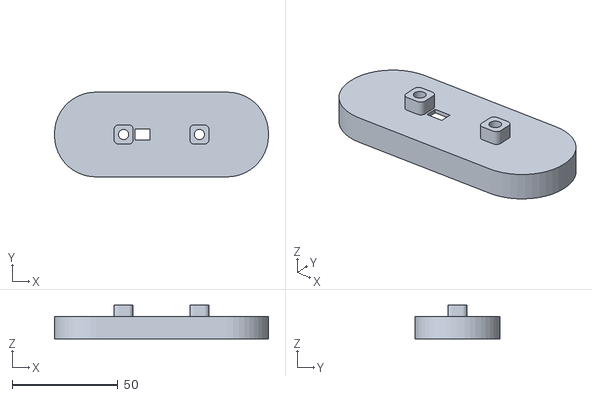
[picture p166: CAD file, 2022-07-19]
3D model/Files for printing/chamber_v3_4-outer chamber _small opening.stl
101.0 x 40.0 x 16.0
