mdanderson03/SpectrePlex/3D model/Files for printing/chamber_v3_4-inner_chamber_high slide.stl

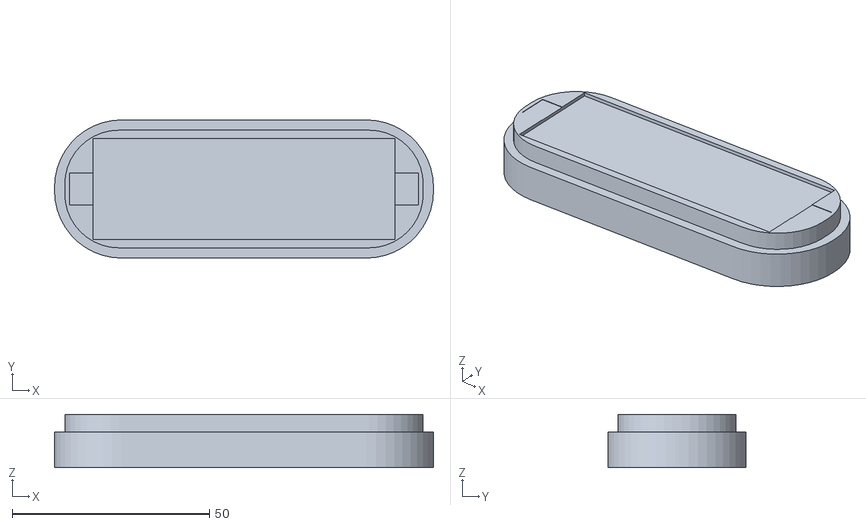
[picture p167: CAD file, 2022-07-19]
3D model/Files for printing/chamber_v3_4-inner_chamber_high slide.stl
96.0 x 35.0 x 13.5
