mdanderson03/SpectrePlex/3D model/Files for printing/chamber_v3_4-_inner_chamber.stl

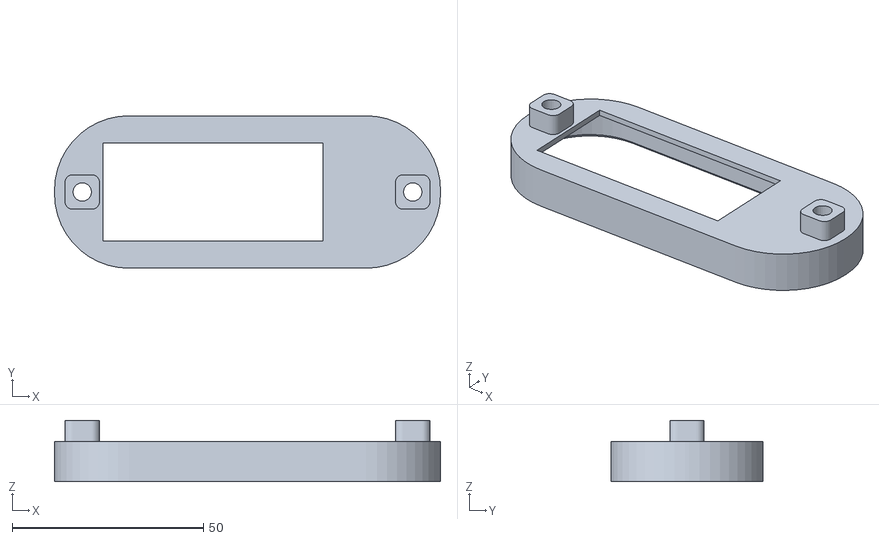
[picture p168: CAD file, 2022-07-19]
3D model/Files for printing/chamber_v3_4-_inner_chamber.stl
100.8 x 39.8 x 16.0
