mdanderson03/SpectrePlex/3D model/Files for printing/chamber_v3_3-Chamfered inner chamber_1 gap closed.stl

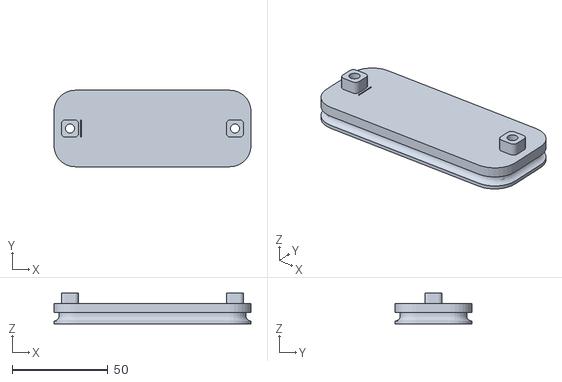
[picture p169: CAD file, 2022-07-12]
3D model/Files for printing/chamber_v3_3-Chamfered inner chamber_1 gap closed.stl
103.0 x 40.0 x 16.0
