mdanderson03/SpectrePlex/3D model/Files for printing/chamber_v3_3-Chamfered inner chamber.stl

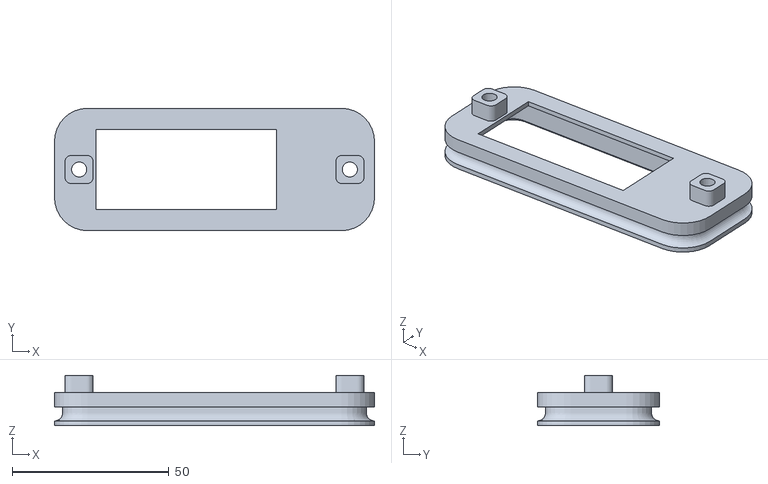
[picture p170: CAD file, 2022-07-07]
3D model/Files for printing/chamber_v3_3-Chamfered inner chamber.stl
102.0 x 39.0 x 16.0
