mdanderson03/SpectrePlex/3D model/Files for printing/chamber_v3_3-Chamfered outer chamber.stl

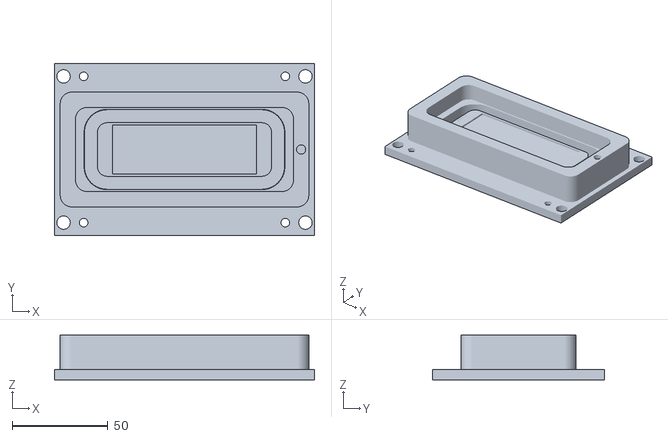
[picture p171: CAD file, 2022-07-06]
3D model/Files for printing/chamber_v3_3-Chamfered outer chamber.stl
136.0 x 90.0 x 23.5
