mdanderson03/SpectrePlex/3D model/Files for printing/chamber_v3_1-Chamfered Outer chamber_stl.stl

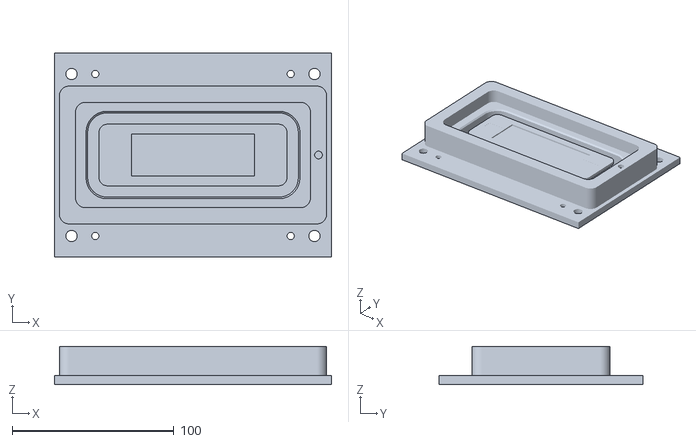
[picture p172: CAD file, 2022-06-28]
3D model/Files for printing/chamber_v3_1-Chamfered Outer chamber_stl.stl
171.0 x 126.0 x 23.5
