mdanderson03/SpectrePlex/3D model/Files for printing/chamber_v3_1_sealed-Chamfered inner chamber_stl.stl

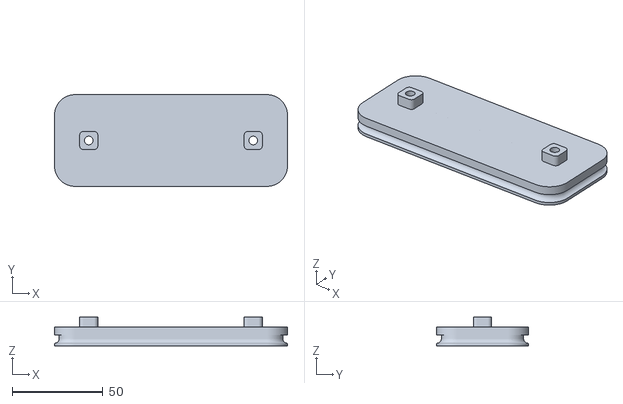
[picture p174: CAD file, 2022-06-28]
3D model/Files for printing/chamber_v3_1_sealed-Chamfered inner chamber_stl.stl
128.6 x 50.6 x 16.0
