mdanderson03/SpectrePlex/3D model/Files for printing/chamber_v3_1-Chamfered inner chamber_stl.stl

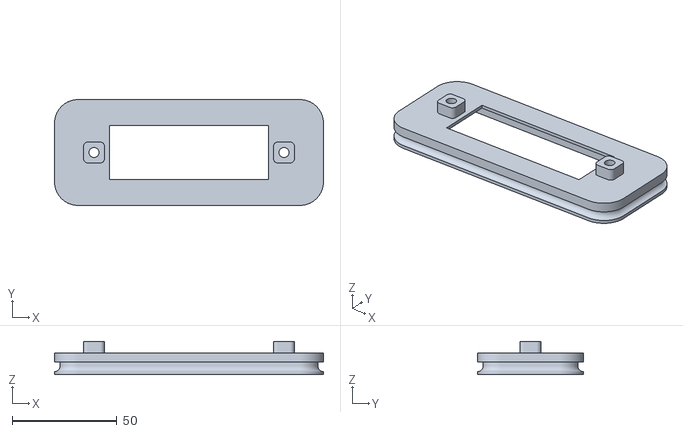
[picture p175: CAD file, 2022-06-28]
3D model/Files for printing/chamber_v3_1-Chamfered inner chamber_stl.stl
128.6 x 50.6 x 16.0
