mdanderson03/SpectrePlex/3D model/Files for printing/Base (1).stl

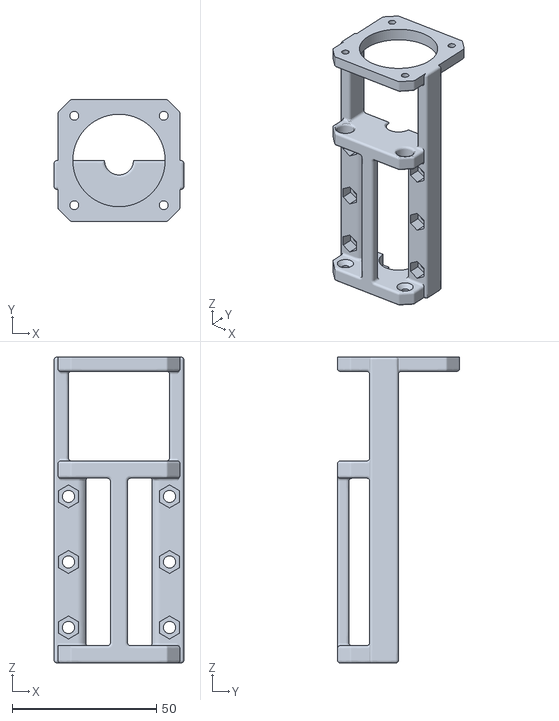
[picture p176: CAD file, 2022-06-16]
3D model/Files for printing/Base (1).stl
45.0 x 42.3 x 106.0
