mdanderson03/SpectrePlex/3D model/Files for printing/Jig Lid (1).stl

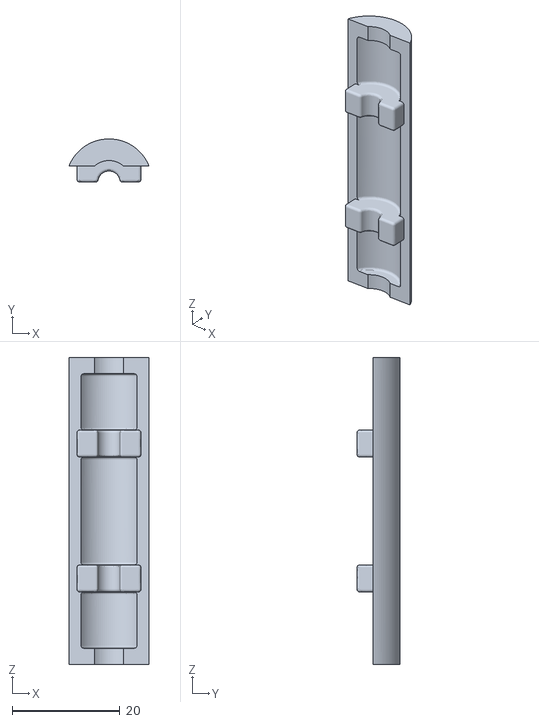
[picture p177: CAD file, 2022-06-16]
3D model/Files for printing/Jig Lid (1).stl
14.8 x 8.00 x 56.9
