mdanderson03/SpectrePlex/3D model/Files for printing/Jig Body (1).stl

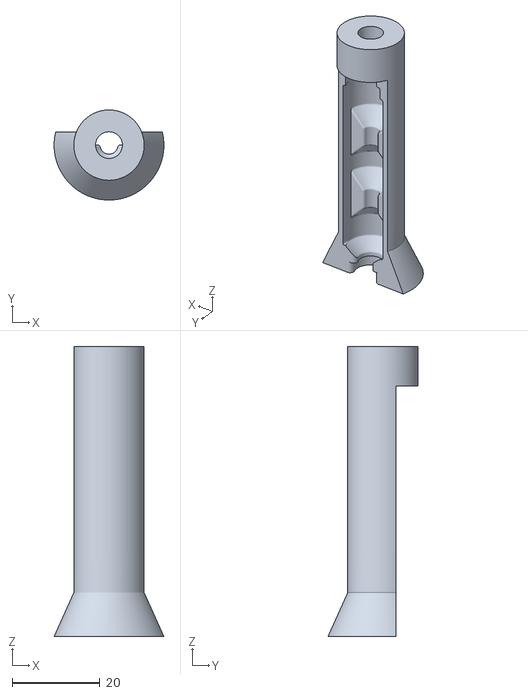
[picture p178: CAD file, 2022-06-16]
3D model/Files for printing/Jig Body (1).stl
25.0 x 20.5 x 66.0
