mdanderson03/SpectrePlex/3D model/Files for printing/Shaft (1).stl

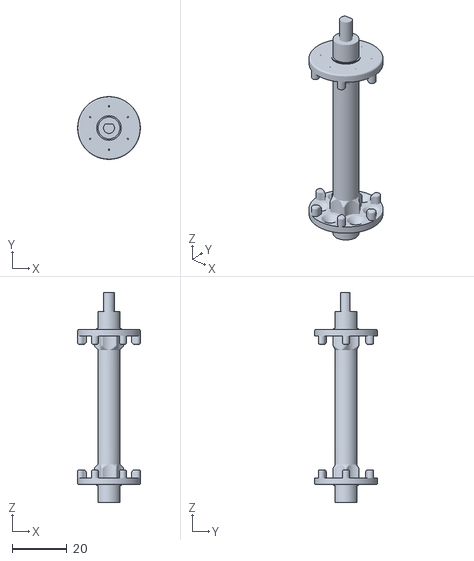
[picture p179: CAD file, 2022-06-16]
3D model/Files for printing/Shaft (1).stl
23.0 x 23.0 x 77.0
