mdanderson03/SpectrePlex/(list of files, cad)

Other CAD files:
3D model/prototype_upper_mold_jig_closed.FCStd
3D model/window form fluidic device V1.1.FCStd
3D model/prototype_upper_mold_jig.FCStd
3D model/microfluidic chamber V1_0.FCStd
3D model/control board housing V1.0.FCStd
3D model/Files for printing/chamber V5.1-chamber.stl
3D model/Files for printing/sensor module-sensor holderbase_4.7.stl
3D model/Files for printing/sensor module-sensor holderbase_4.6.stl
3D model/Files for printing/sensor module-sensor holderbase.stl
3D model/Files for printing/pump zip attachment.stl
3D model/Files for printing/eppendorf_mount V1.0-eppendorf holder.stl
3D model/Files for printing/eppendorf_mount V1.0-Parteppendorf enclosure shroud.stl
3D model/Files for printing/manual_chamber v1_0-chamber.stl
3D model/Files for printing/chamber_v3_7-Chamber_inner bottom chamber with pipes.stl
3D model/Files for printing/chamber_v3_7-inner bottom Chamber.stl
3D model/Files for printing/chamber_v3_7-inner bottom Chamber SLA.stl
3D model/Files for printing/chamber_v3_6-inner bottom chamber_SLA.stl
3D model/Files for printing/chamber_v3_6-top inner chamber.stl
3D model/Files for printing/chamber_v3_3-Chamfered inner chamber_1 gap.stl
3D model/Files for printing/chamber_v3_3-Chamfered inner chamber_0.9 gap.stl
3D model/Files for printing/chamber_v3_3-Chamfered inner chamber_1.1 gap closed.stl
3D model/Files for printing/control board housing V1.0-psu housing.stl
3D model/Files for printing/chamber V5.0-Pressure Platepressure plate body.stl
3D model/Files for printing/chamber V5.0.stl
3D model/Files for printing/chamber V5.1-Pressure Platepressure plate body.stl
3D model/Files for printing/chamber_v3_0-Chamfered outer chamber_stl.stl
3D model/Files for printing/chamber_v3_4-outer chamber.stl
3D model/Files for printing/chamber_v3_5-inner bottom chamber.stl
3D model/Files for printing/chamber_v3_5-outer chamber with mag screws.stl
3D model/Files for printing/chamber_v3_5-top inner chamber.stl
3D model/Files for printing/chamber_v3_6-inner bottom chamber.stl
3D model/Files for printing/chamber_v3_6-inner bottom chamber_SLA.obj
3D model/Files for printing/chamber_v3_6-outer chamber with mag screws.stl
3D model/Files for printing/chamber_v4_0 inner chamber.stl
3D model/Files for printing/chamber_v4_0 magnet set screw hole size selector.stl
3D model/Files for printing/chamber_v4_0-inner chamber with mag set screw sockets.stl
3D model/Files for printing/chamber_v4_0-outer chamber.stl
3D model/Files for printing/chamber_v4_1-Chamber.stl
3D model/Files for printing/chamber_v4_1-arc pressure armentire pressure plate.stl
3D model/Files for printing/control board housing V1.0-housing with screw term and socket.stl
3D model/Files for printing/eppendorf_mount V1.0-Reservior Tube Holdereppendorf enclosure shroud.stl
3D model/Files for printing/peristaltic pump breadboard mount-motor mountplate with bolts and zip channel.stl
3D model/Files for printing/tubing_collar_v1_0-body tube screw cut in half.stl
3D model/chamber V5.0.FCStd
3D model/chamber V5.1 (2).FCStd
3D model/chamber V5.1_aluminum.FCStd
3D model/chamber_v3_0.FCStd
3D model/chamber_v3_1.FCStd
3D model/chamber_v3_2.FCStd
3D model/chamber_v3_3.FCStd
3D model/chamber_v3_4.FCStd
3D model/chamber_v3_5.FCStd
3D model/chamber_v3_6.FCStd
3D model/chamber_v3_7.FCStd
3D model/chamber_v3_8.FCStd
3D model/chamber_v4_0.FCStd
3D model/chamber_v4_1.FCStd
3D model/chamber_v4_2.FCStd
3D model/eppendorf_mount V1.0.FCStd
3D model/eppendorf_mount V1.1.FCStd
3D model/eppendorf_mount V2.0.FCStd
