mdanderson03/SpectrePlex/Presentation/AutoCyPlex File Saving Setup.pptx

## AutoCyPlex File Saving Setup

## Folder Hierarchy

Experiment Folder
Quick Tile
Contains all quick tiled images
DAPI
A488
A555
A647
Stain
cy_1
cy_2
Tiles
Each image is individually saved
Bleach
cy_3
Focused
In focus reconstructed tiles
Numpy
Numpy arrays for focus map and exposures
Mcmicro
Mcmicro input data

Channels

Stain or Bleach Images

Cycle number

Tiled images and individual images

Focused Tile Images

## Naming Structures

- Quick Tiled images are named: placed_cy#_channel.tif
- Tile images are named: z_#_x#_y_#_channel.tif
- Focused tile images are named x#_y_#_channel.tif

## Processing Scheme

Python function name. mcmicro is linux program though

metadata_generator
metadata_generator
infocus
mcmicro_image_stack_generator
stage_placement
mcmicro

Function/program description

Create new metadata construct from known working xml set
Populate stage coords from saved experiment numpy array for the focus map. Update pixel size as well and frame size
Slice tile images into 10x10 sections and use brenner scores to determine in focus chunks. Use median filter on z plane chunk map to even out anomalies. Output reconstructed in focus tiles into focused folder
Populate mcmicro raw data with in focus tiles and add in metadata as a description
Create quick tile images into quick tile folder via stage coord placement with in focus tiles
Run mcmicro folder with mcmicro to flatten illumination via BaSiC and stitch and align cycles with Ashlar

## Slide 5

## Slide 6
