mdanderson03/SpectrePlex/Presentation/Making Invisi-Slip Device.pptx

## Making Invisi-Slip Device

## Slide 2

1. Make Mold
2. Spin 100um PDMS, partial cure.
3. Add FEP window with grease on underside
4. Lay Block on top with grease on underside
5. Coat until about 2.3mm in total height
6. Punch ports both ends 1.5mm punch
7. Remove from mold and remove plastic piece and wash in Hexane to remove grease

## General Constraints
