mdanderson03/SpectrePlex/Presentation/Making Photomasks for microfluidic devices tutorial.pptx

## Making Photomasks for microfluidic devices

## File Format

- DWG or DXF. DWG is a proprietary file format only for AutoCAD. DXF is the opensource equivalent.
- Proprietary file formats are a scam and need to be discouraged to be developed. Use DXF!
- While it appears initially that masks will have surfaces, don’t be alarmed that both DWG and DXF don’t have them. Its inherent in the design of those file types. They only save the borders. Don’t worry about making true surfaces due to this. Filling in enclosed surfaces or leaving them open is determined later in the software that generates the masks.

“Gimmie all of those subscription fees”
-probably what this guy was thinking

The world is now a better place due to the small, but powerful choice you just made.

DWG File Format =

DXF File Format =

## Now that I did the right thing and chose DXF, what platform to use?

- FreeCAD. Many, many great coders have contributed to this project and its at a point where it’s the defacto standard for open-source CAD design and its power and usefulness is super close to platforms like AutoCAD.
- No additional packages are needed. FreeCAD natively supports DXF.
- FreeCAD lacks tutorials on this topic though. That is what this is for.
- Get that downloaded and installed then move on to next slide.

## FreeCAD Mode

- Easy. Just make sketches. No need to extrude them too. Literally just bare sketches.
- For organization, I recommend making bodies for each photomask which is done in part designer.
- Huge tip. Make them parametric models.

## Exporting to DXF files

3. In save type as, chose Autodesk DXF 2D

1. Left click body to be exported

2. Go to file and then export

## Considerations

1. Entire must have a 4-inch sided square
2. Centered inside of the 4-inch square is a 3-inch diameter circle
3. Keep important features slightly away from 3-inch circle as illumination can be a tad lower in intensity there as compared to center.
4. A sheet can contain 6 of these 4-inch masks. It’s the same cost to put 6 on one sheet as it does 6 on a sheet.
5. Don’t combine multiplex design ideas into one 4-inch mask. Fit as many as possible of the same design into each 4-inch mask, but use different designs on different 4-inch masks.
6. Smallest features are 10um
7. Wall thickness must be >2mm
