mdanderson03/SpectrePlex/Presentation/11-10-23 Results.pptx

## 11-10-23 Results

## Assessment

1. Imaging stalled out after 600 images were collected. I identified the issue as pycromanager not emptying a cache. This was resolved by updating pycromanager. Successfully went through all imaging steps in an 8 cycle acquistion
2. Next, tissue appears to have come off in cycle 3. Its possible bleach solution sat for way too long on slide
3. Issues with chain together microfluidic commands. If given individually, it seems to do what I tell it to do. If chained in the same script, it seems to be clunky and sometimes skip parts or does half measures like I say go from 500-0 uL/min and instead it does 500-300uL/min

## Response

1. Biggest issue is fluidic system needs to be reliable in doing what I say to do.
2. Possible imaging issue as error was in the end, but all images appear to have been acquired.
