mdanderson03/SpectrePlex/experiments/10-11-22 h2o2 libh4 mcpba final kinetics/Dye Kinetics H2O2 vs mCPBA vs LiBH4 analysis.pptx

## Dye Kinetics H2O2 vs mCPBA vs LiBH4

## Protocol

- Instrument = Tecan Spark
- Sample holder = 96 well glass bottom plate
- 100uL sample per well
- All ‘dyes’ are either secodnaries or direct primary antibodys
- 1:1k dilution on all dyes
Procedure
1. Mix all bleaching solutions
  a. 24mM NaOH in PBS + 4.5% H2O2 (pH 9.5)
  b. 10mM LiBH4 in MilliQ water
  c. 1mM mCPBA in PBS, NaOH adjusted to pH 10
  d. 24mM NaOH in PBS is referred to as bleaching PBS
2. Make Eppendorf of 1:100 diluted dye (150uL bleaching PBS + 1.5uL dye)
3. Dilute dye again in bleaching buffer at 1:10 for 100uL reference well
4. Add 315uL bleach solution into Eppendorf, add 35uL diluted dye solution, vortex, split 3 ways into wells for 100uL a piece
5. Repeat for other 2 solutions
6. Place into tecan and run procedure

## Tecan Procedure

- Before measurements are taken, the z position is found with reference dye solution and fixed for rest of experiment
1. Go to reference dye, auto gain to make that 60% dynamic range
2. Record inverted fluorescence on every relevant well every 15 seconds
3. 3 samples each condition

## Plate layout

## Filter/Settings each Dye

- A488

## Tau Chart

No Significant Bleaching

No Significant Bleaching

No Significant Bleaching

## Notes

- A488 H2O2, well E1 didn’t pipette well. Lower volume than expected.
- H2O2 samples have lots and lots of bubbles. This will affect kinetic readings stochastically.
- Weighed everything in containers that they were mixed in.
