mdanderson03/SpectrePlex/experiments/2023_2_21 flow rate valve calibration/notes.docx

Fluid flow rate vs valve testing

1. Have autocyplex computer run fluidic system.
2. Flush all lines with PBS
3. Fill up eppenfdorf for 10 seconds with PBS from one open valve at a time in triplicates.
4. Weight eppenddorfs and subtract weight of empty eppenddorf from it to calc PBS volume
