mdanderson03/SpectrePlex/experiments/2_9_23 trial multiplex/notes.rtf

Staining Order 2_6_23
1. Cy1: Na_K_ATPase-647, villin-488, ecad-555
2. gamma-actin-647, PDGF-555, pcna-488
3. ezrin-488, glut2-647, NHE3-dy555

all 1:100 mixes with directly conjugated antibodies
Intercept + 0.01% triton is blocking buffer.
25uL 1M mCPBA + 5mL high pH buffer

Control slide

*Check each individual valves time to the multiplexer. I feel like it varies enough between valves to quantify the difference.
