mdanderson03/SpectrePlex/experiments/8_29_22 slide bleach test two/notes.rtf

Goal: determine fluorescence reamining with m-CPBA after 5 minutes with on slide stains
Insturment: AutoCIF
Bleach solution: 10mM m-CPBA in pH 10 PBS. m-CPBA was originally dissolved at 1M [C] in ehtanol and diluted to 10mM in PBS pH 10. -

cycle 0
1:5k hoescht 5 minutes
cycle 1
Primary
1. Mouse-ECAD
2. Rabbit-MUC2
Secdonary
1. anti-mouse-488
2. anti-rabbit-532

cycle 2
1. ezrin-488
2. chromogranin A -A594
3.gamma actin-A647

cycle 3: this cycle was done the following day.
1. PCNA -A488
2. villin-A546
3. Na-K-APase- A647

Primary incubation 1:100 for both for 45 mintutes
2x 3 minutes PBS wash
secdonary 1:200 for both for 45 minutes (ended up being 1:15 minutes)

All direct conjugate stains are at 1:100 dilution for 45 minutes
2x 3 minute PBS wash
