mdanderson03/SpectrePlex/experiments/Plans/h2o2 vs mcpba/H2O2 vs m-CPBA analysis.pptx

## H2O2 vs m-CPBA

## h2o2

- 24mM NaOH is 10M NaOH (240uL) into 100mL
