mdanderson03/SpectrePlex/experiments/2023_2_21 flow rate valve calibration/data.xlsx

Valve | 10s volume | flow rate
3 | 92.2 | 9.22
3 | 95.7 | 9.57
3 | 91.5 | 9.15
4 | 104.2 | 10.42
4 | 96.2 | 9.62
4 | 91.8 | 9.18
5 | 96 | 9.6
5 | 100.2 | 10.02
5 | 95.6 | 9.56
6 | 103.2 | 10.32
6 | 78.2 | 7.82
6 | 94.6 | 9.46
7 | 105.2 | 10.52
7 | 90.2 | 9.02
7 | 99.5 | 9.95
