mdanderson03/SpectrePlex/experiments/6_20_23 heater focus drift/focus drift data.xlsx

Time | Temp | Focus Z Position | Event happen
0 | 22 | 788
5 | 43 | 766
10 | 47 | 764
15 | 47 | 763 | heater turned off after 15 minutes
20 | 36 | 773
25 | 30 | 778
30 | 27 | 779
35 | 25 | 780 | heater turn on after 35 minutes
40 | 45 | 765
45 | 47 | 764
50 | 47 | 757 | touched objective after this measurement
55 | 47 | 760
119 | 46 | 758
