mdanderson03/SpectrePlex/experiments/11-18-22 fluidic calibration/fluid.xlsx

time stamp | ABS (625nm) | repeat | ABS (625nm) | repeat | ABS (625nm)
3 | 0.005 | 3 | 0 | 3 | 0
6 | 0.008 | 6 | 0 | 6 | 0
9 | 0 | 9 | 0 | 9 | 0
12 | 0 | 12 | 0 | 12 | 0
15 | 0 | 15 | 0 | 15 | 0
18 | 0.029 | 18 | 0.114 | 18 | 0.015 | 0.1293333333
21 | 0.132 | 21 | 0.135 | 21 | 0.074
24 | 0.216 | 24 | 0.143 | 24 | 0.095
27 | 0.339 | 27 | 0.189 | 27 | 0.106
30 | 0.388 | 30 | 0.228 | 30 | 0.057
 |  | 33 | 0.266 | 33 | 0.032
 |  | 36 | 0.288 | 36 | 0.009
 |  | 39 | 0.286 | 39 | 0
pure | 1.09 | 42 | 0.258 | 42 | 0
 |  | 45 | 0.261 | 45 | 0
 |  | 48 | 0.252 | 48 | 0
