mdanderson03/SpectrePlex/experiments/8_29_22 slide bleach test two/data.xlsx

Sample | Avg | Avg - offset
cycle1 | 5134 | 4734
cycle1_bleach | 953 | 553
cycle2 | 23945 | 23545
cycle2_bleach | 1110 | 710
cycle3 | 4248 | 3848
cycle3_bleach | 958 | 558
 | Bleached | Stained
cycle1 | 553 | 4734
cycle2 | 710 | 23945
cycle3 | 558 | 4248
