mdanderson03/SpectrePlex/experiments/9-15-22 bleach kinetics/9-15-22/a488_h2o2_single.xls

Method name: Method 1
Application: SparkControl |  |  |  | V3.1 SP1
Device: Spark |  |  |  | Serial number: 2206011555
Firmware: |  |  |  | LUM:V5.2.4|ABS:V4.3.2|ABS_MEX:V5.1.1|USBCAM:V4.90.34|CELL:V4.1.4|MTP:V14.3.3|FLUOR:V5.1.4|FLUOR_FP:V5.0.2|FLUOR_BOTTOM:V5.0.2|FLUOR_MEM:V5.1.1|FLUOR_MEX:V5.1.1|PODI:V1.12.5
Date: |  |  |  | 2022-09-15
Time: |  |  |  | 12:57 PM
System |  |  |  | RDT01216
User |  |  |  | RDT01216\Sabrina
Plate |  |  |  | [GRE96ft] - Greiner 96 Flat Transparent Cat. No.: 655101/655161/655192
Lid lifter |  |  |  | Lid
Humidity Cassette |  |  |  | No humidity cassette
Smooth mode |  |  |  | Not selected
List of actions in this measurement script:
Plate
 | Shaking
 | Kinetic
 |  | Fluorescence Bottom Reading |  |  |  | A488
Name |  |  |  | GRE96ft
Plate layout
Plate area |  |  |  | H4-H6
Start Time |  |  |  | 2022-09-15 12:52:42
Shaking (Double Orbital) Duration [s] |  |  |  | 5
Shaking (Double Orbital) Position |  |  |  | Current
Shaking (Double Orbital) Amplitude [mm] |  |  |  | 1.5
Shaking (Double Orbital) Frequency [rpm] |  |  |  | 180
End Time |  |  |  | 2022-09-15 12:52:47
Mode | Kinetic
Kinetic cycles |  |  |  | 20
Interval time [hhmmss] |  |  |  | 00:00:15
Mode | Fluorescence Bottom Reading
Name | A488
Excitation |  |  |  | Monochromator
Excitation wavelength [nm] |  |  |  | 488
Excitation bandwidth [nm] |  |  |  | 15
Emission |  |  |  | Monochromator
Emission wavelength [nm] |  |  |  | 523
Emission bandwidth [nm] |  |  |  | 15
Gain Manual |  |  |  | 101
Number of flashes |  |  |  | 30
Integration time [µs] |  |  |  | 40
Lag time [µs] |  |  |  | 0
Settle time [ms] |  |  |  | 0
Z-Position [μm] |  |  |  | 31856
Z-Position mode |  |  |  | Manual
Part of Plate |  |  |  | H4-H6
Start Time |  |  |  | 2022-09-15 12:52:52
A488
Cycle Nr. | Time [s] | Temp. [°C] | A1 | A2 | A3 | A4 | A5 | A6 | A7 | A8 | A9 | A10 | A11 | A12 | B1 | B2 | B3 | B4 | B5 | B6 | B7 | B8 | B9 | B10 | B11 | B12 | C1 | C2 | C3 | C4 | C5 | C6 | C7 | C8 | C9 | C10 | C11 | C12 | D1 | D2 | D3 | D4 | D5 | D6 | D7 | D8 | D9 | D10 | D11 | D12 | E1 | E2 | E3 | E4 | E5 | E6 | E7 | E8 | E9
1 | 0 | 30.3
2 | 15.006 | 30.1
3 | 30.026 | 30.2
4 | 45.04 | 30.1
5 | 60.058 | 30.1
6 | 75.076 | 30
7 | 90.09 | 30.1
8 | 105.108 | 30.1
9 | 120.12 | 30
10 | 135.128 | 30.1
11 | 150.145 | 30
12 | 165.157 | 30
13 | 180.17 | 29.9
14 | 195.192 | 30
15 | 210.199 | 30
16 | 225.22 | 30
17 | 240.24 | 30
18 | 255.254 | 30
19 | 270.273 | 30
20 | 285.291 | 30
End Time |  |  |  | 2022-09-15 12:57:40
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
