mdanderson03/SpectrePlex/experiments/17-10-23 notes.txt

Close to satisfactory tilt correction with no tweaking. Tweaked on side one time. Sub 3 micron tilt

Acquiring images with a 7 stack z stack with 3 micron spacings. This is overkill, but I really dont want to miss out.
