mdanderson03/SpectrePlex/experiments/4-1-23 kinetics/notes.txt

a488: 1:1k SMA
A555: 1:100 epcam
A647: 1:1k MUC2

At 78 minutes, I refocused in the A488 channel
