mdanderson03/SpectrePlex/experiments/4-1-23 single dye over time/notes.txt

1. 1:1k mouse A647 secondary with 1 minute intervalsa at 75ms exp and 90% pwr

2. 1:1K A48 SMA with 1 minute intervals at 50ms exp and 90% pwr
