mdanderson03/SpectrePlex/experiments/2_6_23 single FOV multiplex/notes.rtf

Staining Order 2_6_23
1. Cy1: Na_K_ATPase-647, ezrin-488, pdgf-555
2. gamma-actin-647, chomogranin-594, pcna-488

all 1:100 mixes with directly conjugated antibodies
Intercept + 0.01% triton is blocking buffer.

Control slide, single FOV all that is left as the rest lifted off of the slide.
