mdanderson03/SpectrePlex/experiments/1-12-23 focus and anti kinetics data/Notes.rtf

1-12-23
Focus data set and antibody kinetics data set acquistions

1. Focus Set
I want two main areas.
1. Partial area with tissue
2. Mostly filled area
The first will be just DAPI and unstained a488
Set 2 (if stain takes)
DAPI, a-488 and A647
1. Partial with all 3 channels
2. fullish FOV with all 3
