mdanderson03/SpectrePlex/experiments/Plans/dye energy kinetics plans.docx

The kinetics of varying [C] of mCPBA in pH 10 PBS is not yielding data that is well modeled. It technically fits singlet and at higher [C]’s, double decay curves very well. However, the k factor is not scaling with [C] the way it should be. There are some unknowns in the system such as does epoxidation reduce fluor int or eliminate it? Or is vicinal diol formation needed to eliminate fluorescence?

Next,
