mdanderson03/SpectrePlex/experiments/kinetics summary.xlsx

Stain | 20C | 37C | Tau 20C | half time 20C | Tau 37C | halftime 37C
Muc2 | x | x | 91 | 63 | 18.8 | 13
SMA | x | x | 89 | 61.7 | 22.5 | 15.6
PCNA | x | x | 134.7 | 93.4 | 7.2 | 5
CD-11c | x | x | 36 | 25 | 57.8 | 40
Na-K-ATPase | x | x | 23.8 | 16.5 | 46.3 | 32.1
EpCam | x | x | 62.6 | 43.4 | 18.5 | 12.5
cytokeratin | x | x
lactase | x | x
CD10 | x | x
chromoA | x | x | 29.3 | 20.3 | 23.6 | 16.3
pEFGR | x | x | 23 | 16 | 23 | 16
SGLT | x | x
lysozyme | x | x | 150 | 104 | 172.5 | 119.6
 | Noisy
 | Good
 | Didn’t Work
