mdanderson03/SpectrePlex/antibody validation list/antibody validation results.xlsx

Antigen | company | type | Dye |  | work in condition 1 | Notes on condition 1 | work in condition 2 | Notes on condition 2
Gamma Actin sc-65638 | santa cruz | ? | A647 | x | xx |  | -
ecad | bd | mouse | a555 | x | xx | good | -
pdgf (D13C6) | cell signalling | rabbit | a555 | x | - |  | -
glut2 | novus | rabbit | A647 | x | x | weak, but noticable | -
villin | santa cruz | ? | A546 | not used |  |  | -
villin | santa cruz | ? | A488 | x | xx | average | -
Rab 7 | santa cruz | ? | A594 | not used |  |  | -
PCNA (PC10) | cell signalling | mouse | A488 | x | x | maybe, very weak | -
NHE3/SLC9A3 | Novus | mouse | DY555 | x | - |  | -
Ezrin (4A5) | santa cruz | ? | A488 | x | xxx | perfect | -
Na/K/ATPase | santa cruz | ? | A647 | x | xx |  | x | weak
chromogranin | novus | mouse | A594 | x | xx | good | -
conditions | antigen retrevial Buffer | Heating Device | Time at peak Temp | blocking | [C]
1 | Citric acid pH 6.0 + Tween | PC | 15 minutes | Intercept proteinless | 1:100
2 | Tris-EDTA pH 9.0 + Tween | PC | 3 minutes | Intercept proteinless | 1:100
