mdanderson03/SpectrePlex/experiments/17-10-23_offsets.xlsx

cycle | dapi | a488 | a555 | a647
 | 3 |  |  | 5
1 | 5 | 5 | 5 | 6
7 | 5 | 5 | 5 | 6
4 | 5 |  |  | 7
3 | 5 | 5
6 | 5 | 5
1 | 4 | 5 | 4 | 5
7 | 4 |  |  | 7
2 | 4 |  | 4
