mdanderson03/SpectrePlex/experiments/23-2-24 celiac/stain_results.xlsx

Cycle | A488 stain | A488 quality/notes | A555 stain | A555 quality/notes | A647 stain | A647 quality/notes
1 | Chromogranin A | ++ | NaKATPase | + to ++ fairly spotty | pEGFR | overexposed, but ++ on previous runs
2 | SGLT | + Can be seen, but very weak. | Pan Cyto Keratin | ++ good stain, some aggregates floating around though | Fox P3 | + in some regions. Seems spotty
3 | SMA | +++ | CD45 | - some bright spots, but believe them to be aggregates
4 | CD4 | Shadow artifact from SMA, no evidence of stain though. | CD68 | +/++ weakish, but not clearly weak | Muc2 | +++
5 | Lactase | + Lots of background. Maybe didn’t wash well. Some shows up | CD3D | - None | Gamma Actin | Over exposed in many areas. Some under exposed regions are ++
6 | CD10 | + or ++ didn’t wash well enough, but looked better than lactase.Did stain a border and not just cell though | PDGF Receptor beta | - None, maybe some small aggregates | CD31 | Unknown. All over exposed.
7 | PCNA | Very weak. Artifact shadow from CD10 about as intense.
Other Notes
Appears some channels didn’t fully bleach (10% signal left) and some didn’t wash well enough. Doubled wash time (150 seconds from 70) and added minute to bleach time (4 total now) for future runs
