mdanderson03/SpectrePlex/experiments/11-30-22 fluidic staining test/data.xlsx

time (min) | Stain intensity | Background int | Stain - Background | stain/background | (stain- background)/background | rate of change (sig-back)
2 | 2081 | 1534 | 547 | 1.356584094 | 0.3565840939
7 | 2535 | 1560 | 975 | 1.625 | 0.625 | 428
12 | 2828 | 1593 | 1235 | 1.775266792 | 0.7752667922 | 260
17 | 3105 | 1628 | 1477 | 1.907248157 | 0.9072481572 | 242
22 | 3342 | 1649 | 1693 | 2.026682838 | 1.026682838 | 216
27 | 3554 | 1660 | 1894 | 2.140963855 | 1.140963855 | 201
32 | 3860 | 1669 | 2191 | 2.312762133 | 1.312762133 | 297
37 | 3992 | 1690 | 2302 | 2.362130178 | 1.362130178 | 111
