mdanderson03/SpectrePlex/experiments/11-18-22 fluidic calibration/flow rate.xlsx

step delay (ms) | volume per 30s (uL) | volume (uL/min) | steps per second
1 | 630 | 1260 | 1000
2 | 560 | 1120 | 500
3 | 480 | 960 | 333.3333333
4 | 430 | 860 | 250
5 | 390 | 780 | 200
6 | 360 | 720 | 166.6666667
7 | 330 | 660 | 142.8571429
8 | 300 | 600 | 125
9 | 280 | 560 | 111.1111111
