mdanderson03/SpectrePlex/experiments/9-15-22 bleach kinetics/half time graph.xlsx

Dye | m-CPBA | H2O2 | Fold Speed Increase
A488 | 37.5 | 380 | 10.13333333
A532 | 48 | 166 | 3.458333333
A546 | 52000 | 35000 | 0.6730769231
A555 | 26 | 148 | 5.692307692
A568 | 448 | 30000 | 66.96428571
A647 | 12 | 43 | 3.583333333
