mdanderson03/SpectrePlex/experiments/auto focus repeatibility/data.xlsx

xy location | shot 1 | shot 2 | shot 3 | correct answer
tissue 1 | 1107.5 | 1107 | 1107 | 1106
tissue 1 after 5 minutes | 1107 | 1106.5 | 1107 | 1106
tissue 1 after 10 minutes | 1107 | 1107 | 1107 | 1106.5
tissue 1 after 5minutes and displacment | 1107 | 1107 | 1107 | 1105.5
tissue 1 after displacement_1 | 1107.5 | 1107 | 1107.5 | 1106.5
tissue 1 after displacement_2 | 1107.5 | 1107.5 | 1107.5 | 1106
tissue 1 after displacement_3 | 1107 | 1107.5 | 1107 | 1106
