mdanderson03/SpectrePlex/experiments/Dye kinetics/exact_mixes.xlsx

Sheet: Dilutions for OD
Dye | Max wavelength ABS | Extinction Coeff | Mol Weight Antibody Complex (mg/mL) | Dilution for 0.1 OD
A488 | 495 | 73000 | 2 | 44.92307692
A555 | 555 | 155000 | 2 | 95.38461538
A594 | 590 | 92000 | 2 | 56.61538462
A647 | 650 | 270000 | 1 | 83.07692308
A750 | 749 | 290000 | 2 | 178.4615385
DY755 | 754 | 220000 | 0.5 | 33.84615385
Cy7 | 750 | 250000 | 1 | 76.92307692
cy3

Sheet: Dilutions for Spectra work
Dye | Extinction Coeff | Quantum Yield | Actual [C] of Stock Solution (uM) | nM of Dye needed for measurements | Dilution for fluorescence
A488 | 73000 | 0.92 | 20 | 34.99106611 | 571.5744681
A555 | 155000 | 0.1 | 20 | 151.6129032 | 131.9148936
A594 | 92000 | 0.66 | 20 | 38.70223979 | 516.7659574
A647 | 270000 | 0.33 | 20 | 26.37485971 | 758.2978723
A750 | 290000 | 0.12 | 20 | 67.52873563 | 296.1702128
DY755 | 220000 | 0.12 | 20 | 89.01515152 | 224.6808511
Cy7 | 250000 | 0.3 | 20 | 31.33333333 | 638.2978723
 |  |  | actual
A647 |  |  | 8uM |  | 100x
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
