mdanderson03/SpectrePlex/experiments/Dye kinetics/curtipot_CyCIF_dyes_bleach.xlsm

Sheet: CurTiPot
 |  | CurTiPot main features and uses
 |  | • pH calculation of aqueous solutions with activity coefficient and buffer capacity estimation (mixtures of up to seven hexaprotic systems)
 |  | • Virtual Titration with indicator color transition simulation, manual titrant addition with a digital burette, species distribution and pH vs. volume plot
 |  | • Simulation of simple and complex acid-base titration curves
 |  | » automatic generation of curves with data equally spaced in pH or volume, in concentration ("pH") or activity (pH)
 |  | » simulation of experimental random errors in pH and volume; overlay of multiple curves for comparison
 |  | • Data analysis of real and simulated curves of acid-base titrations
 |  | » Evaluation of curves with enhanced accuracy by interpolation, spline smoothing and automatic endpoint detection
 |  | » Non-linear data Regression for the determination of concentrations and refinement of pKa values
 |  | • Distribution diagrams of species, protonation of bases, isoelectric point and buffer capacity vs. pH and vs. volume of a titration
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
