mdanderson03/SpectrePlex/experiments/Dye kinetics/nanosite abs a647 a594.xlsx

Time (min) | Alexa 647 ABS | Alexa 594 ABS | Alexa 647 norm | Alexa 594 norm
0.5 | 0.046 | 0.099 | 1 | 1
12 | 0.005 |  | 0.1086956522
60 |  | 0.058 |  | 0.5858585859
Alexa 647 norm | 1 | 1
Alexa 594 norm | 0.1086956522 | 0
 | 0 | 0.5858585859
0 minutes
12 min
60 min
