mdanderson03/SpectrePlex/experiments/28-8-24 wash and stain numbers/washes/data.xlsx

Sheet: wash
1 | 0 | 41452.59766 | 41152.59766
2 | 83.3 | 46357.03516 | 46057.03516
3 | 166.6 | 47694.67188 | 47394.67188
4 | 249.9 | 22561.04102 | 22261.04102
5 | 333.2 | 12245.00586 | 11945.00586
6 | 416.5 | 7876.352539 | 7576.352539
7 | 499.8 | 5451.710449 | 5151.710449
8 | 583.1 | 3876.555176 | 3576.555176
9 | 666.4 | 2700.945801 | 2400.945801
10 | 749.7 | 1833.047729 | 1533.047729
11 | 833 | 1238.737183 | 938.7371826
12 | 916.3 | 902.2067871 | 602.2067871
13 | 999.6 | 630.3584595 | 330.3584595
14 | 1082.9 | 503.7700195 | 203.7700195
15 | 1166.2 | 440.5437622 | 140.5437622
16 | 1249.5 | 412.4566345 | 112.4566345
17 | 1332.8 | 398.9282227 | 98.92822266
18 | 1416.1 | 392.3703003 | 92.37030029
19 | 1499.4 | 388.9061279 | 88.90612793
20 | 1582.7 | 386.7567749 | 86.7567749
21 | 1666 | 385.7642822 | 85.76428223
22 | 1749.3 | 384.5442505 | 84.54425049
23 | 1832.6 | 384.4797058 | 84.47970581
24 | 1915.9 | 382.9993286 | 82.99932861
25 | 1999.2 | 431.5174866 | 131.5174866
26 | 2082.5 | 384.8338928 | 84.83389282
27 | 2165.8 | 382.5954285 | 82.59542847
28 | 2249.1 | 381.8762207 | 81.8762207
29 | 2332.4 | 381.102417 | 81.10241699
30 | 2415.7 | 380.2733459 | 80.27334595
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
