mdanderson03/SpectrePlex/experiments/9-22-22 kinetics solution/9-22-22/a532.ods

Method name: Method 1
Application: SparkControl |  |  |  | V3.1 SP1
Device: Spark |  |  |  | Serial number: 2206011555
Firmware: |  |  |  | LUM:V5.2.4|ABS:V4.3.2|ABS_MEX:V5.1.1|USBCAM:V4.90.34|CELL:V4.1.4|MTP:V14.3.3|FLUOR:V5.1.4|FLUOR_FP:V5.0.2|FLUOR_BOTTOM:V5.0.2|FLUOR_MEM:V5.1.1|FLUOR_MEX:V5.1.1|PODI:V1.12.5
Date: |  |  |  | 2022-09-22
Time: |  |  |  | 12:42 PM
System |  |  |  | RDT01216
User |  |  |  | RDT01216\Sabrina
Plate |  |  |  | [GRE96ft] - Greiner 96 Flat Transparent Cat. No.: 655101/655161/655192
Lid lifter |  |  |  | No lid
Humidity Cassette |  |  |  | No humidity cassette
Smooth mode |  |  |  | Not selected
List of actions in this measurement script:
Plate
 | Kinetic
 |  | Fluorescence Bottom Reading |  |  |  | a488
Name |  |  |  | GRE96ft
Plate layout
Plate area |  |  |  | A1-A4;B2;F1-H3
Mode | Kinetic
Kinetic cycles |  |  |  | 20
Interval time [hhmmss] |  |  |  | 00:00:15
Mode | Fluorescence Bottom Reading
Name | a488
Excitation |  |  |  | Monochromator
Excitation wavelength [nm] |  |  |  | 525
Excitation bandwidth [nm] |  |  |  | 15
Emission |  |  |  | Monochromator
Emission wavelength [nm] |  |  |  | 560
Emission bandwidth [nm] |  |  |  | 15
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
