mdanderson03/SpectrePlex/experiments/Dye kinetics/8_11_22 dye kinetics/a488_10mm.xlsx

Method name: a488_bleach (Modified)
Application: SparkControl |  |  |  | V2.1
Device: Spark 10M |  |  |  | Serial number: 1503001843
Firmware: |  |  |  | LUM:V5.2.3|ABS:V4.3.2|ABS_MEX:V5.0.7|CELL:V4.1.4|MTP:V13.1.5|FLUOR:V5.1.3|FLUOR_FP:V5.0.2|FLUOR_BOTTOM:V5.0.2|FLUOR_MEM:V5.0.7|FLUOR_MEX:V5.0.7|GCM:V3.0.2|INJ:V3.1.1
Date: |  |  |  | 2022-08-11
Time: |  |  |  | 3:09 PM
System |  |  |  | LENCER606TECAN
User |  |  |  | Lencer606Tecan\Lencer 606 Tecan
Plate |  |  |  | [GRE96ft] - Greiner 96 Flat Transparent [GRE96ft]
Lid lifter |  |  |  | Lid
Humidity Cassette |  |  |  | No humidity cassette
Smooth mode |  |  |  | Not selected
List of actions in this measurement script:
Plate
 | Kinetic
 |  | Fluorescence Bottom Reading |  |  |  | A488
Name |  |  |  | GRE96ft
Plate layout
Plate area |  |  |  | A8-A9;F10-F12
Mode | Kinetic
Kinetic cycles |  |  |  | 60
Interval time |  |  |  | 00:00:10 | hh:mm:ss
Mode | Fluorescence Bottom Reading
Name | A488
Excitation |  |  |  | Monochromator
Excitation wavelength |  |  |  | 485 | nm
Excitation bandwidth |  |  |  | 20 | nm
Emission |  |  |  | Monochromator
Emission wavelength |  |  |  | 530 | nm
Emission bandwidth |  |  |  | 20 | nm
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
