mdanderson03/SpectrePlex/experiments/Dye kinetics/tissue based/2 cycle bleaching analysis.xlsx

Sheet: Area (px²)
Area (px²) | Frame 0
Outline 1 | 139
Outline 2 | 10472 | area | cycle (INT per pixel) | bleach (INT per pixel) | background cycle | background bleach | %ratio cy1/bleach1
Outline 3 | 715.5 | 93833 | 38109.43596 | 1072.793452 | 1628 | 1016 | 0.1556776775
Outline 4 | 7344 | 28978 | 22745.41276 | 1078.177792 | 1386 | 1010 | 0.3191931929
Outline 5 | 198.5
Outline 6 | 179
Outline 7 | 221
Outline 8 | 2736.5
Outline 9 | 997
Outline 10 | 48
Outline 11 | 871.5
Outline 12 | 750
Outline 13 | 8266
Outline 14 | 2688.5
Outline 15 | 1397
Outline 16 | 18
Outline 17 | 204
Outline 18 | 1918.5
Outline 19 | 1961.5
Outline 20 | 716.5
Outline 21 | 1969
Outline 22 | 76.5
Outline 23 | 7386
Outline 24 | 2186
Outline 25 | 14
Outline 26 | 1025
Outline 27 | 2145.5
Outline 28 | 56
Outline 29 | 85
Outline 30 | 21.5
Outline 31 | 6892
Outline 32 | 355
Outline 33 | 180
Outline 34 | 2512.5
Outline 35 | 579
Outline 36 | 871.5
Outline 37 | 1853
Outline 38 | 19355
Outline 39 | 102
Outline 40 | 734.5
Outline 41 | 38.5
Outline 42 | 14
Outline 43 | 1422
Outline 44 | 643
Outline 45 | 14
Outline 46 | 40
Outline 47 | 1384.5
Outline 48 | 36
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
