mdanderson03/SpectrePlex/experiments/Dye kinetics/tissue based/incubation time intensity analysis.xlsx

Sample | tissue | tile | Hrs. | intensity per stained pixel
210618_111250 | 1 | A1_01_1_18_GFP_001 | 12 | 21797
210618_111250 | 2 | A1_01_1_24_GFP_001 | 12 | 20664
s_20_0003723 | 1 | A1_01_3_13_GFP_001 | 12 | 23471
s_20_0003723 | 2 | A1_01_3_11_GFP_001 | 12 | 26423
s_20_0003723 | 3 | A1_01_3_8_GFP_001 | 12 | 34011
s_20_0009810 | 3 | A1_01_3_30_GFP_001 | 2 | 29399
s_20_0009810 | 1 | A1_01_3_27_GFP_001 | 2 | 25893
s_20_0009810 | 2 | A1_01_3_23_GFP_001 | 2 | 27889
s_20_0008190 | 1 | A1_01_2_26_GFP_001 | 1 | 20120
s_20_0008190 | 2 | A1_01_2_35_GFP_001 | 1 | 23168
s_20_0000351 | 1 | A1_01_2_22_GFP_001 | 1 | 23793
s_20_0000351 | 2 | A1_01_2_27_GFP_001 | 1 | 23778
hrs | mean int per pixel | stnd dev
1 | 22714.75 | 1754.16521
2 | 27727 | 1758.605129
12 | 25273.2 | 5344.338238
