mdanderson03/SpectrePlex/experiments/Dye kinetics/tissue based/staining time analysis aug 2021.xlsx

Sheet: Summary
incubation (hr) | weighted avg int MUC2 | weighted avg int ECAD
12 | 33574.50398 | 23021.02124
12 | 19582.08885 | 23516.22511
1 | 29186.0235 | 16710.88299
1 | 20161.70612 | 24088.36072

Sheet: overnight_1 MUC2
 |  |  |  |  |  | weighted stain mean | weighted background mean | stain area (fraction of total) | stain mean (per pixel) | background mean (per pixel) | mean stain weigthed (per pixel) | weighted stnd dev
1 | 1106496 | 862.369 | 3661.571 | 0 | 65504 | 862.369 | 776.142 | 0.266 | 3241.988722 | 1057.414169 | 33574.50398 | 17500.64523
2 | 1106496 | 0.266 | 0.442 | 0 | 1 | 5827.806 | 4249.386 | 0.121 | 48163.68595 | 4834.341297
3 | 1106496 | 776.142 | 490.076 | 0 | 1328 | 2932.712 | 3139.266 | 0.063 | 46550.98413 | 3350.337247
4 | 1106496 | 5827.806 | 16692.068 | 0 | 65504 | 716.386 | 1772.134 | 0.019 | 37704.52632 | 1806.456677
5 | 1106496 | 0.121 | 0.327 | 0 | 1 | 2857.012 | 3064.823 | 0.06 | 47616.86667 | 3260.45
6 | 1106496 | 4249.386 | 4205.043 | 0 | 21392 | 4849.81 | 4367.044 | 0.099 | 48987.9798 | 4846.885683
7 | 1106496 | 2932.712 | 12142.263 | 0 | 65504 | 1156.409 | 2054.197 | 0.027 | 42829.96296 | 2111.199383
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
