mdanderson03/SpectrePlex/experiments/8_29_22 slide bleach test two/8_29_22 bleach slide/cycle0_4_color_1/cycle0_masked_nuc.tif

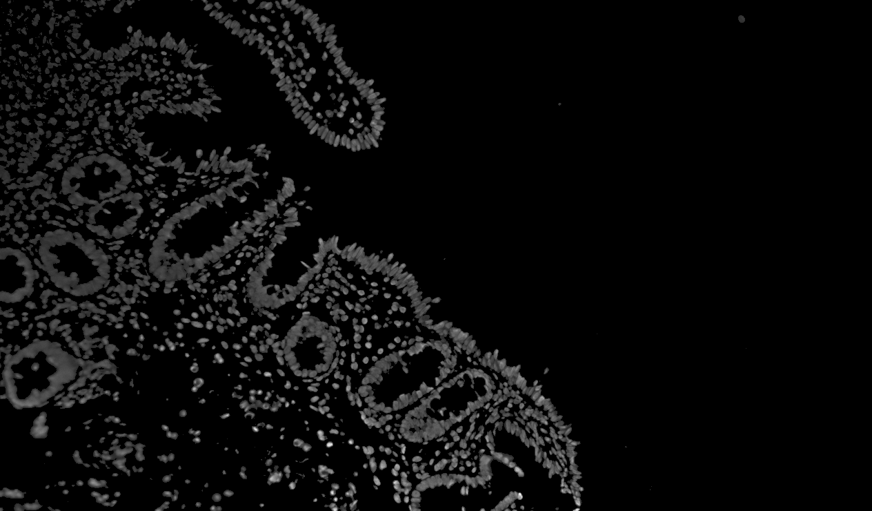
experiments/8_29_22 slide bleach test two/8_29_22 bleach slide/cycle0_4_color_1/cycle0_masked_nuc.tif
