mdanderson03/SpectrePlex/experiments/8_29_22 slide bleach test two/8_29_22 bleach slide/cycle1_bleach_647_500ms.tif

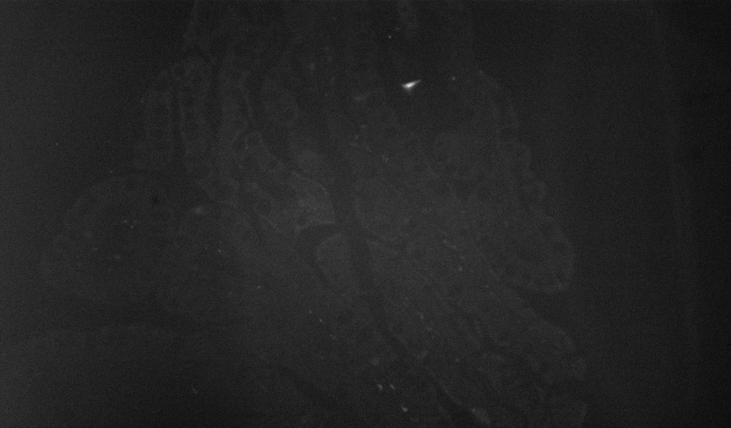
experiments/8_29_22 slide bleach test two/8_29_22 bleach slide/cycle1_bleach_647_500ms.tif
