mdanderson03/SpectrePlex/experiments/8_29_22 slide bleach test two/8_29_22 bleach slide/cycle2_bleach_heoscht_20ms.tif

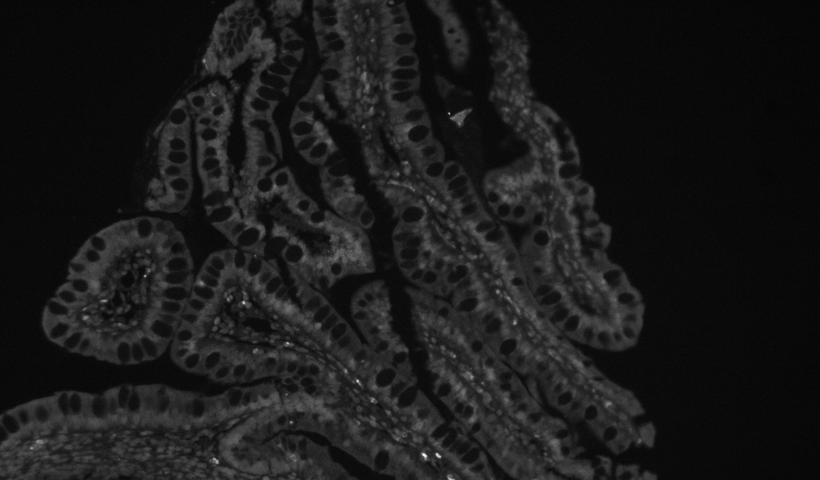
experiments/8_29_22 slide bleach test two/8_29_22 bleach slide/cycle2_bleach_heoscht_20ms.tif
