mdanderson03/SpectrePlex/experiments/8_29_22 slide bleach test two/8_29_22 bleach slide/cycle3_bleach_a546_200ms.tif

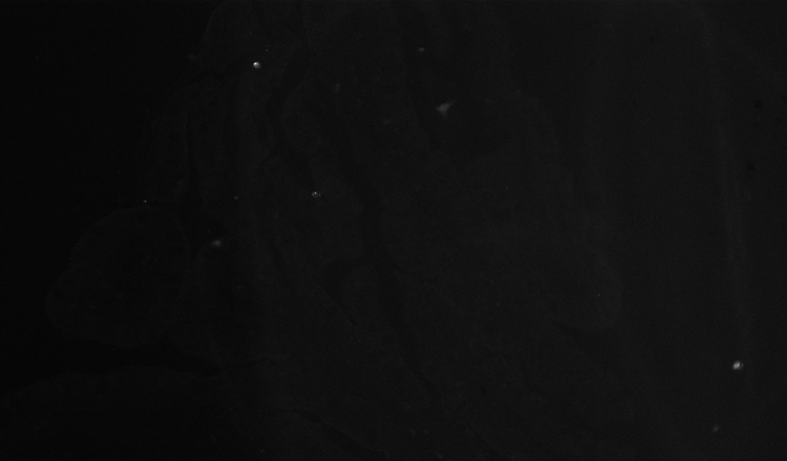
experiments/8_29_22 slide bleach test two/8_29_22 bleach slide/cycle3_bleach_a546_200ms.tif
