mdanderson03/SpectrePlex/experiments/10-11-22 h2o2 libh4 mcpba final kinetics/data/Scaled Tau Values.tif

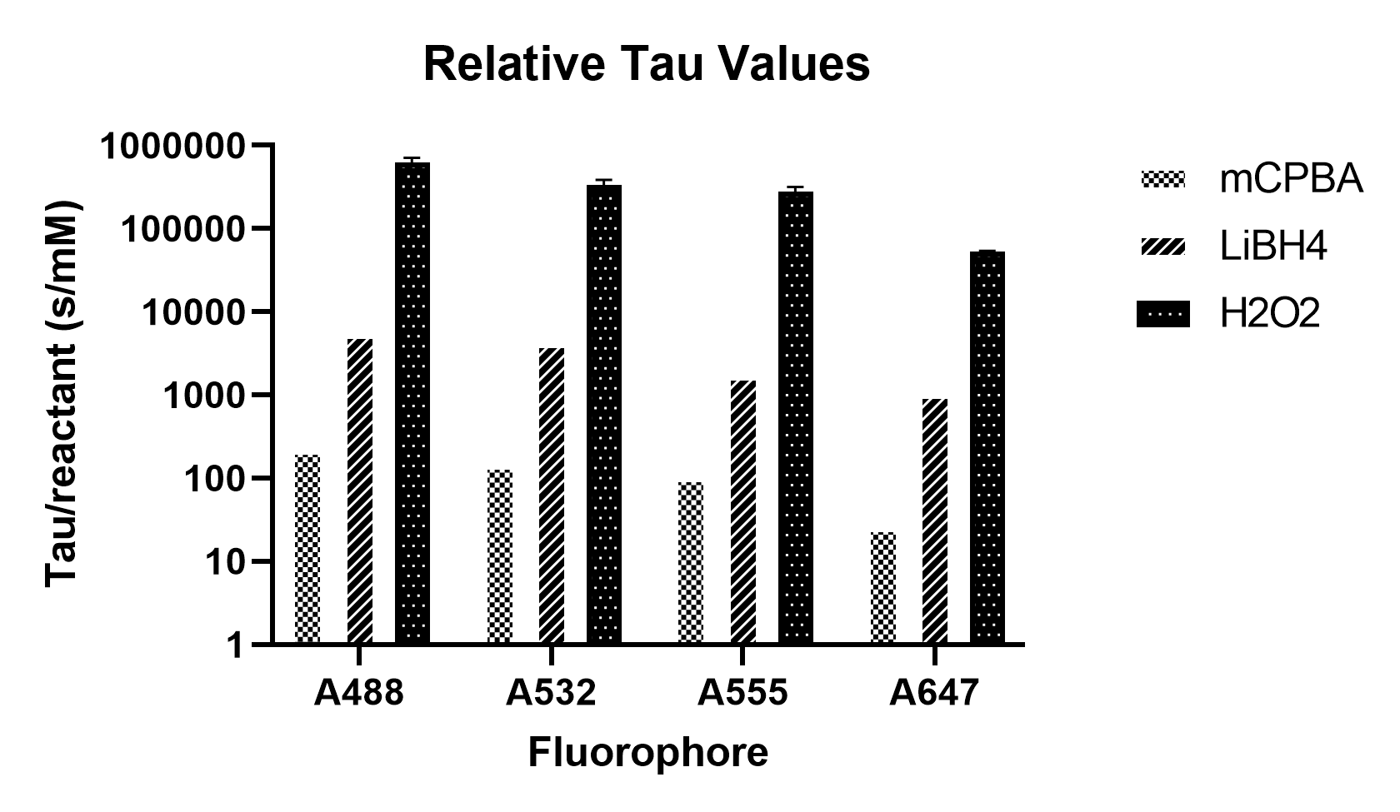
experiments/10-11-22 h2o2 libh4 mcpba final kinetics/data/Scaled Tau Values.tif
