mdanderson03/SpectrePlex/experiments/10-11-22 h2o2 libh4 mcpba final kinetics/data/single decay 1mM mCPBA bleaching.tif

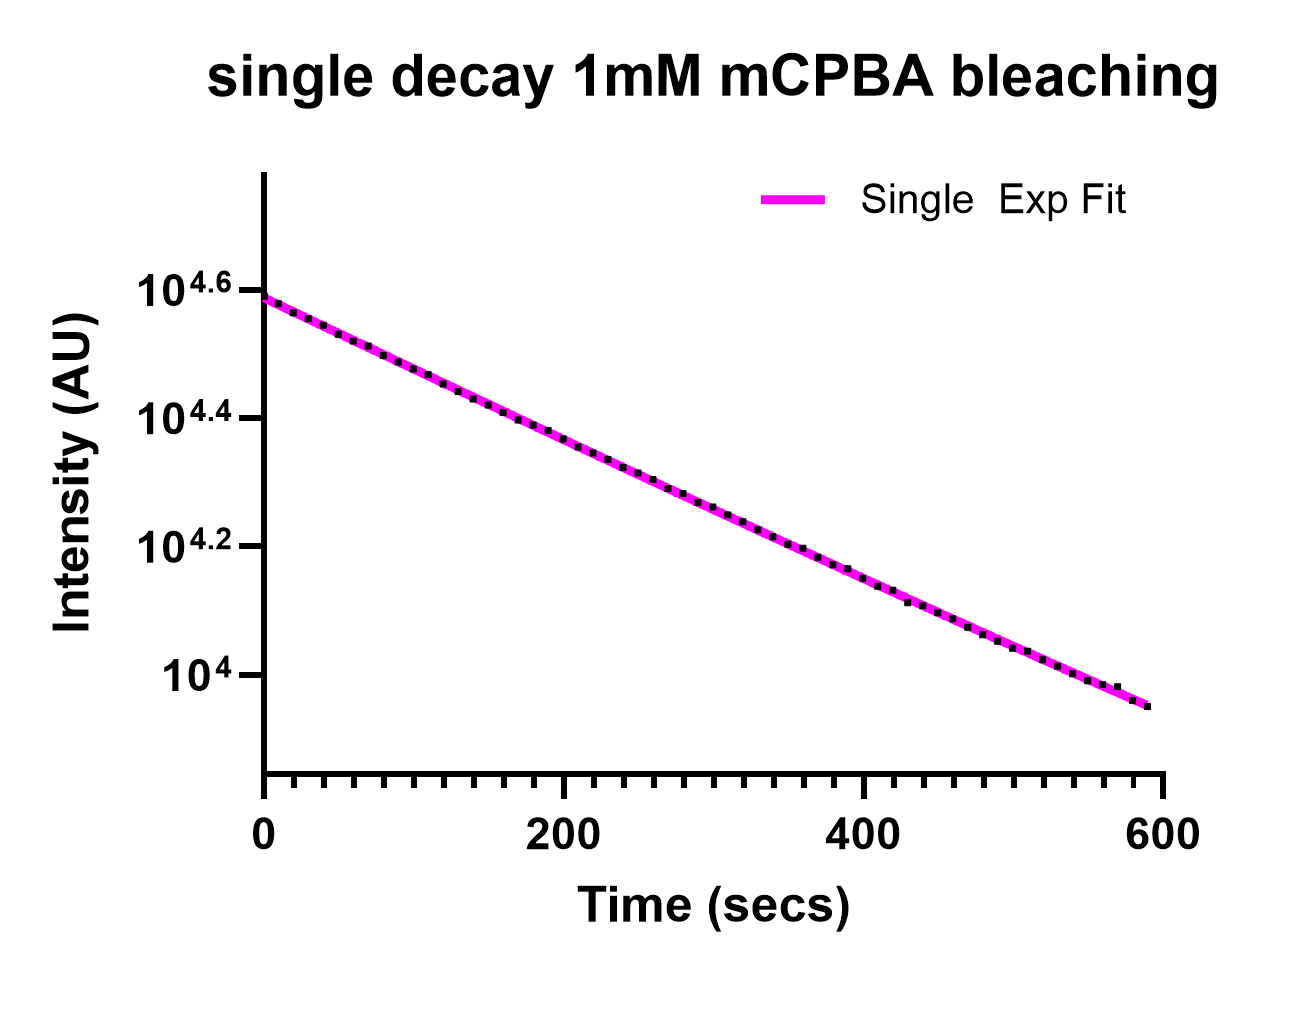
experiments/10-11-22 h2o2 libh4 mcpba final kinetics/data/single decay 1mM mCPBA bleaching.tif
