mdanderson03/SpectrePlex/Presentation/FEP Film bonding issues.pptx

## FEP Film bonding issues

## Slide 2

- In online forum, a primer was suggested to be used for super glue bonding to FEP film.
- Super glue adhered very poorly to FEP.
- Super glue with primer also adhered very poorly.
- More comprehensive guide at: https://adhesives.specialchem.com/tech-library/article/bonding-solutions-for-low-surface-energy-substrates showed that after priming, bonding is still really bad with FEP
