mdanderson03/SpectrePlex/3D model/version logs and observations/Changelogs for Chamber for AutoCIF.pptx

## Changelogs

## V3.1

- Filleted lengthwise inner edges of oring channel for inner chamber and inner chamber socket to improve printing quality.
- Fixed parameter where oring channel height was not being adjusted for inner chamber
- Increased port diameter for inner chamber from 4mm – 4.8mm to accomodate screw in quick turn module.
- Inner chamber and socket oring channel depth decreased to 2.6mm
- Widened gap between socket walls and inner chamber walls from 0.5mm to 0.7mm
- Adjusted corner fillets for all channels (socket and oring) to have even thickness as it curves
- Lengthened inner chamber socket’s width and length to 130 and 52mm from 125 and 45.

General tweaks

## V 3.2

Primary objective on this revision is to increase FEP window robustness on inner chamber and create a protrusion on the portion directly over the frosted label on the slide. This will press down onto that portion and keep it in place during acquisitions.

- Changed gap reference from slide well on outer chamber to slide window on inner
- Made port to slide window on inner chamber asymmetric in order to shrink inner chamber window and have area where protrusion can exist above frosted part of slide
- Slide window is inset 18mm on frosted side w/ respect to slide well
- Increased gap from port to slide window edge from 5mm to 10mm and from 5mm to 28mm on the frosted side
- Mounting screw differences were actually 148.5mm and 98.5mm. Seems to have undershot by 1.5mm. Increased gaps to 151.5 and 101.5 respectively.
- Hexnut was a tad loose. Decreased socket diameter from 8.7 to 8.5mm.

## V3.3

- Shrunk overall dimensions to smallest possible over the slide to reduce volume of fluid needed.

- Shrunk slide well length from 26mm to 25.8 to slightly tighten socket.
- Shrunk inner socket width and length from 130mm and 55mm to 105 and 42mm.
- Port cutout width changed from 15mm to 6mm
- Fluid height reduced from 0.2mm to 0.1mm
- Port to slide well gap reduced from 10mm to 3mm.
- Port riser side dropped from 10mm to 9mm
- Inner socket oring height above ground increased from 3mm to 4.5mm.
- Added in part to calculate projected fluid volume needed
- Reduced gap between mounting screw and hexnut from 6mm to 3mm
- Reduced outer chamber width and length from 165mm and 85mm to 130mm and 60mm
- Reduced mounting screw separation length and width from 126.5 and 101.5 to 126.5 and 76.5mm
- Reduced mounting plate width and length from 115mm to 90mm (width scaled with outer chamber width as width plus 2mm.
- Reduced outer chamber wall thickness from 10mm to 8mm.
- Overall needed fluid volume dropped from 1.3mL to 0.35mL
- Glitched in chamfering inner socket (actually chamfered bottom part, but this should effect much).

## V3.4

Expanded out inner socket fillets to get a better oring seal. I will also eliminate the top part of the inner socket oring socket. Additionally, remove oring from inner chamber and reduce inner socket chamber width

- Fixed order of operation (ie make inner before outer) for channel and socket fillets
- Eliminate slide protrusion
- Changed innersocket fillet to 20mm
- Changed oring fillet to 13.7mm.
- Changed socket thickness to 4mm
- Altered length and width of both the outer chamber and inner chamber socket
- Removed oring from inner chamber

## V3.5

This is a major change. Lateral oring was swapped for a compression gasket that is laid on the slide’s face. Gasket will be made from parafilm which is around 100-120um thick. Second major change was to make the inner chamber a two part system and made a kinematic mount for it. Its not super exact, but inner chamber tilt was anticipated to be the most important part. Centering magnets should get within micron ranges which is more than sufficient to get the slide tilt within 50% the depth of View which is 1 micron over a FOV.

- Swapped inner chamber to be a two piece system with 6 screws for compression. Both hexnuts and heads are all inset
- Made slide 0.5mm higher in socket so that slide surface is higher than anything else on bottom inner chamber so then the upper portion will contact it first, making compression with a gasket possible.
- Made kinematic mount with two sets of centering magnets. Magnets mounted with screws and outer chamber has inset deep enough to hold both magnets with a gap between to weaken them around 2 fold. Tracks with magnets are longer than need be so the inner chamber can be shifted to one side to break mag bond better and more easily.
- Rebuilt entire CAD model to generate this V 3.5 model.

## V 3.6

Minor refinements to inner chamber model. Increasing window inset to increase glue surface and increasing its depth to make sure the window does not touch the slide in any point as the glue can cause it to tilt.
Outer chamber will be modified to encasing the lower magnets with the Teflon washer placed in a socket above them with a small reveal of the washer.

- Decreased window width from 45mm to 43mm
- Increased window ledge from 2mm to 5mm
- Converted mag inset from rect to circle and fixed diameter at 26.5mm which is enough to just contain the magnet itself
- Reduced mag inset depth from 8mm to 4.4mm which projects for 0.8mm of washer to be exposed.
- Reduced dia of hexnuts from 8.5 to 8.3mm
- Increase outer height from 40 to 41.6mm to increase fluid over top of chamber to 5mm.
- Increased depth (and thus decreased bottom thickness) to 25mm from 20mm. (bottom went from 20mm to 16.6mm). The inset is shallower so the bottom can be thinner.
- Decreased magnet mounting screw dia from 4.5 to 3.5mm
- Decreased hex nut dia for inner bottom chamber from 6.9mm to 6.6mm

## V3.7

Alternate design where the inner chamber upper portion is not form fitting around its bottom. The ends are open and a mount is placed on its top which binds to FEP film and using bolts, causes it to tighten. This makes a nice smooth surface on the upper made out of FEP film. The bottom now has the slide inset 100um so the upper can make contact with it for a seal. The inner bottom chamber also has a new pipe system so the fluid can be pushed completely through it and not the inner upper as it was before.

## V4.0

This new version is heavily based on the 3.6 model and skips V3.7 revisions with several modifications to make it accommodate a microfluidic device on the slide. In addition, magnets will be placed below the slide to enhance the seal of the PDMS microfluidic device with the slide.

- Inner upper chamber removed
- 9x 3/8 inch holes placed under slide for magnetic mount system which is a slightly larger set screw in the hole and a magnet on its end. The set screw can move the magnet up and down in the channel. It is nickel so the magnet will actually attach to it.
- Kinematic mount remains the same
- Outer chamber is reduced in size
- Made slide mechanism to secure slide via magnet sandwich (one above and one below)
- Remove leveling screws. Make attachment for tilt stage.
- Placed outer port to perpendicular to side and towards the bottom centered. This should favor keeping a water-tight seal.
- Reduced plateau height by 1mm
- Increased wall height by 3mm

## V4.1

Extend rim to go around inner chamber.
Make pressure plates for fluidic device with risers

- Made rim go from centered middle to center middle extended to end
- Increased rim height by 7mm.
- Pressure plates for fluidic device that are the length of the entire device.

## V5.1

Accommodate the actual heating element and add in alignment jig for the slide and pressure plate

- Removed Al socket
- Added in socket for wire to heater connection
- Made 2 wire sockets (one on each side)
- Made heater socket much more shallow (4mm to 1mm)
- Added in alignment jig for pressure plate and slide
