mdanderson03/SpectrePlex/3D model/version logs and observations/Initial Design Logs Microfluidic multiplex device.pptx

## Initial Design Logs Microfluidic multiplex device

## Basics of design

Constraints
1. Overall height from slide <2mm (allows for 1.1NA objectives to be used)
2. Low volume over tissue (around 70uL or less)
3. Optically ‘Pure’ viewing window made from FEP film.
4. Reversible Bonding of device
5. Fit on 75mm X 25mm slides without touching 18mm frosted area
6. Ports need to be separated from viewing window spatially to prevent collision with objective

3 components to design
1. Viewing window
2. Inlet and outlet port
3. Transition zones from port into viewing window area

Top View

Viewing Window

Port Inlet

Port Outlet

## Viewing Window Construction (Side View)

- FEP is hard to adhere to any material
- Fluoroetch from Acton can modify FEP surface and allow it to adhere

1. Make silicon wafer mold

2. Spin coat PDMS up to height of mold features and partially cure it

3. Apply vacuum grease to mold feature and then place Fluoroetch treated FEP film onto mold with a predetermined and slight overhang

4. Apply vacuum grease to bottom of SLA printed resin block that has same dimensions as viewing window. Place on FEP film directly over silicon mold feature

5. Pour PDMS onto mold to desired height and fully cure

6. Remove SLA printed spacer and then remove device from mold. Place in Hexane bath to dissolve the vacuum grease to clean up viewing window

## Reversible Bonding

- Typically, PDMS is plasma treated to covalently bond to glass. This is not acceptable as it would make them single use, need on hand plasma treater as the effect is short lived and make the slide useless after processing.
- Papers point to PDMS has Van-Der-Waals bonding with glass. This is weak and max can handle 5 PSI. To ensure leak protection in an effort free and easy manner, magnets can be used alongside embedding iron oxide dust into the PDMS mixture. Papers usually used iron oxide nanoparticles, but 320 grid dust works well and is a fraction of the cost.
- Papers point to iron oxide causing a ‘rough’ surface as compared to standard PDMS, Calixto assured me that it isn’t an issue and it will be as smooth as the wafer.
- 1:3 PDMS to iron oxide ratio (w/w) appears to be a good ratio.

Platform that slides sit on. Neodymium magnets on set screws are embedded into it in locations directly underneath the bonding walls of the device. This allows height of magnet to be adjusted and for the magnets to be kept in place.

## Distance needle port from viewing window

- Given needle port will rise above device and objective barrel extends wider than the spot it views, its possible to have a collision between the two. A gap must exist to prevent this.
- Easy trig problem to determine what gap should be
- Given objective angle is 45 degree, x = 8/tan(45), x = 8mm

90 degree Needle

8mm above PDMS

PDMS

x

Objective

Viewing window

## Modulatable Parameters

- Distance port to viewing window
- Window dimensions
- Filter / filter spacing
- Port channel width
- Wall thickness
- FEP film overlap

## 6 design Choices for Device

1. No filters, 18x15mm window, 4mm walls. Ext dimensions = 55x23
2. Same as 1, but offset channel path
3. Same as 1, but with 5 row filter system. 0.25mm pillars and final size of 0.25mm gaps
4. Same as 3, but channel is offset in same way as 2
5. 15x15 window, ext dimensions = 48x23
6. Same as 5, but offset channel just like 2
