mdanderson03/SpectrePlex/troubleshooting/stain_action_log.xlsx

Do Action with Digital Sensor Setting
######## | <function OB1_Initialization at 0x000001D7D57DAB00> | 0 | 0
######## | <function OB1_Add_Sens at 0x000001D7D57DB6D0> | -8000 | 0
######## | <function Elveflow_Calibration_Default at 0x000001D7D57DAB90> | 0 | 0
######## | <function PID_Add_Remote at 0x000001D7D5808550> | 0 | 0
######## | <function OB1_Start_Remote_Measurement at 0x000001D7D5808310> | 0 | 0
######## | <function MUX_DRI_Set_Valve at 0x000001D7D57DB640> | 0 | 12
######## | <function MUX_DRI_Get_Valve at 0x000001D7D57DB5B0> | 0 | 0
######## | <function MUX_DRI_Get_Valve at 0x000001D7D57DB5B0> | 0 | 0
######## | <function MUX_DRI_Get_Valve at 0x000001D7D57DB5B0> | 0 | 0
######## | <function MUX_DRI_Get_Valve at 0x000001D7D57DB5B0> | 0 | 12
######## | <function OB1_Set_Remote_Target at 0x000001D7D5808430> | 0 | 500
######## | <function OB1_Get_Remote_Data at 0x000001D7D5808280> | 0 | 503.07
######## | <function OB1_Get_Remote_Data at 0x000001D7D5808280> | 0 | 499.48
######## | <function OB1_Set_Remote_Target at 0x000001D7D5808430> | 0 | -3
######## | <function OB1_Get_Remote_Data at 0x000001D7D5808280> | 0 | 2.21
######## | <function OB1_Get_Remote_Data at 0x000001D7D5808280> | 0 | 1.41
######## | <function MUX_DRI_Set_Valve at 0x000001D7D57DB640> | 0 | 12
######## | <function MUX_DRI_Get_Valve at 0x000001D7D57DB5B0> | 0 | 0
######## | <function MUX_DRI_Get_Valve at 0x000001D7D57DB5B0> | 0 | 0
######## | <function MUX_DRI_Get_Valve at 0x000001D7D57DB5B0> | 0 | 0
######## | <function MUX_DRI_Get_Valve at 0x000001D7D57DB5B0> | 0 | 12
######## | <function OB1_Destructor at 0x000001D7D57DB0A0> | 0 | 0
######## | <function OB1_Initialization at 0x000001D7D57DAB00> | 0 | 0
######## | <function OB1_Add_Sens at 0x000001D7D57DB6D0> | -8000 | 0
######## | <function Elveflow_Calibration_Default at 0x000001D7D57DAB90> | 0 | 0
######## | <function PID_Add_Remote at 0x000001D7D5808550> | 0 | 0
######## | <function OB1_Start_Remote_Measurement at 0x000001D7D5808310> | 0 | 0
######## | <function MUX_DRI_Set_Valve at 0x000001D7D57DB640> | 0 | 12
######## | <function MUX_DRI_Get_Valve at 0x000001D7D57DB5B0> | 0 | 0
######## | <function MUX_DRI_Get_Valve at 0x000001D7D57DB5B0> | 0 | 0
######## | <function MUX_DRI_Get_Valve at 0x000001D7D57DB5B0> | 0 | 0
######## | <function MUX_DRI_Get_Valve at 0x000001D7D57DB5B0> | 0 | 12
######## | <function OB1_Set_Remote_Target at 0x000001D7D5808430> | 0 | 500
######## | <function OB1_Get_Remote_Data at 0x000001D7D5808280> | 0 | 0
######## | <function OB1_Get_Remote_Data at 0x000001D7D5808280> | 0 | 0
Do Same Action with Analog Sensor Setting
######## | <function OB1_Initialization at 0x000002991B1DAB00> | 0 | 0
######## | <function OB1_Add_Sens at 0x000002991B1DB6D0> | 0 | 0
######## | <function Elveflow_Calibration_Default at 0x000002991B1DAB90> | 0 | 0
######## | <function PID_Add_Remote at 0x000002991B204550> | 0 | 0
######## | <function OB1_Start_Remote_Measurement at 0x000002991B204310> | 0 | 0
######## | <function MUX_DRI_Set_Valve at 0x000002991B1DB640> | 0 | 12
######## | <function MUX_DRI_Get_Valve at 0x000002991B1DB5B0> | 0 | 0
######## | <function MUX_DRI_Get_Valve at 0x000002991B1DB5B0> | 0 | 0
######## | <function MUX_DRI_Get_Valve at 0x000002991B1DB5B0> | 0 | 0
######## | <function MUX_DRI_Get_Valve at 0x000002991B1DB5B0> | 0 | 12
######## | <function OB1_Set_Remote_Target at 0x000002991B204430> | 0 | 500
######## | <function OB1_Get_Remote_Data at 0x000002991B204280> | 0 | 234.35
######## | <function OB1_Get_Remote_Data at 0x000002991B204280> | 0 | 234.48
######## | <function OB1_Set_Remote_Target at 0x000002991B204430> | 0 | -3
######## | <function OB1_Get_Remote_Data at 0x000002991B204280> | 0 | 236.14
######## | <function OB1_Get_Remote_Data at 0x000002991B204280> | 0 | 236.14
######## | <function PID_Set_Running_Remote at 0x000002991B2044C0> | 0 | 0
######## | <function OB1_Set_Remote_Target at 0x000002991B204430> | 0 | 0
######## | <function OB1_Get_Remote_Data at 0x000002991B204280> | 0 | 2017.34
######## | <function OB1_Get_Remote_Data at 0x000002991B204280> | 0 | 236
######## | <function MUX_DRI_Set_Valve at 0x000002991B1DB640> | 0 | 12
######## | <function MUX_DRI_Get_Valve at 0x000002991B1DB5B0> | 0 | 0
######## | <function MUX_DRI_Get_Valve at 0x000002991B1DB5B0> | 0 | 0
######## | <function MUX_DRI_Get_Valve at 0x000002991B1DB5B0> | 0 | 0
######## | <function MUX_DRI_Get_Valve at 0x000002991B1DB5B0> | 0 | 12
######## | <function OB1_Destructor at 0x000002991B1DB0A0> | 0 | 0
