mdanderson03/SpectrePlex/z position mm issue.gif

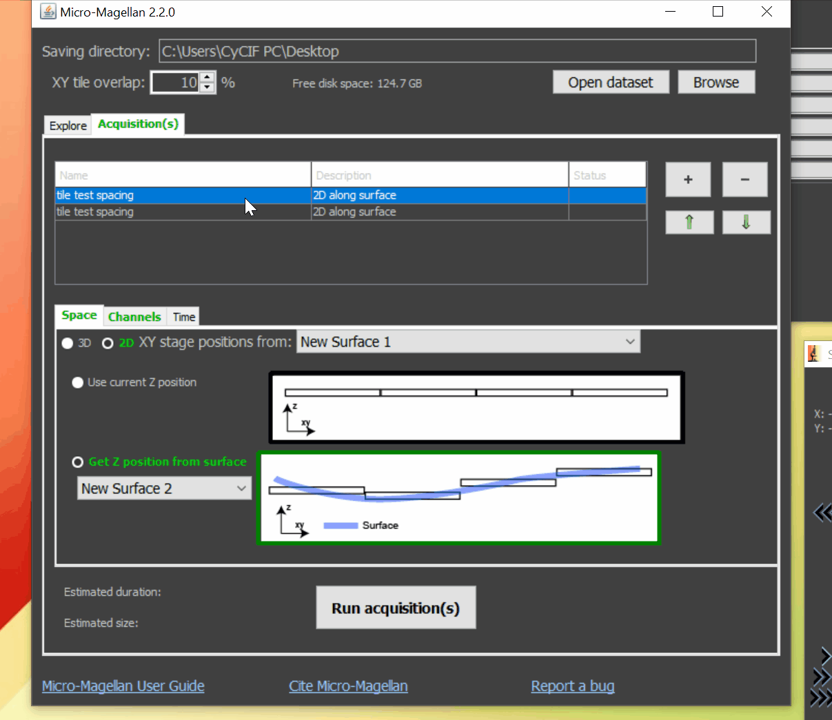
z position mm issue.gif
