mdanderson03/SpectrePlex/POs/order form photomask.pdf

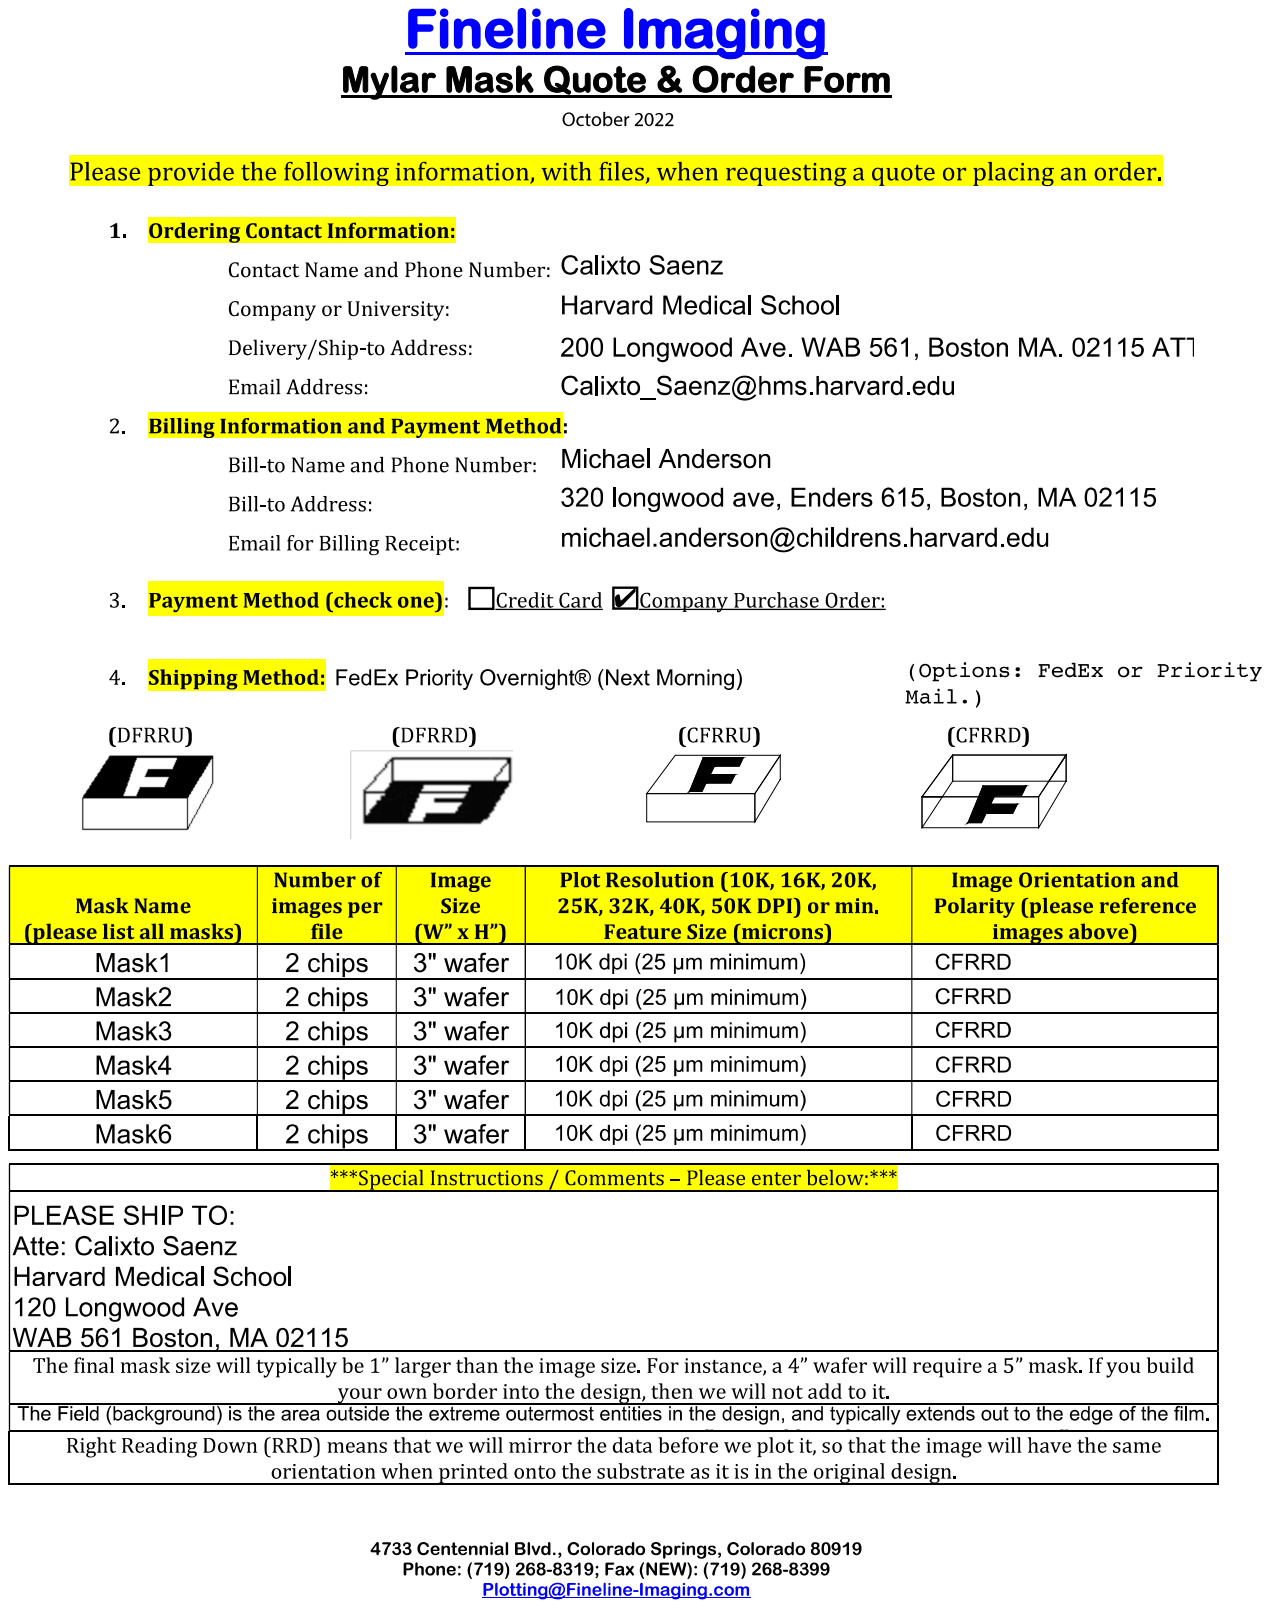
[picture p218: page 1]
