mdanderson03/SpectrePlex/Software/fluidics_V3.py

import datetime
import os
from subprocess import call
import numpy as np
import time
import matplotlib.pyplot as plt
from openpyxl import Workbook, load_workbook
import sys
from ctypes import *
import math
import hamilton_mvp4

sys.path.append(
    r'C:\Users\CyCIF PC\Documents\GitHub\AutoCIF\Python_64_elveflow\DLL64')  # add the path of the library here
sys.path.append(r'C:\Users\CyCIF PC\Documents\GitHub\AutoCIF\Python_64_elveflow')  # add the path of the LoadElveflow.py
sys.path.append(r'C:\Users\mike\Documents\GitHub\AutoCIF\Python_64_elveflow\DLL64')  # add the path of the library here
sys.path.append(r'C:\Users\mike\Documents\GitHub\AutoCIF\Python_64_elveflow')  # add the path of the LoadElveflow.py

from array import array
from Elveflow64 import *


class fluidics:

    def __init__(self, experiment_path, mux_valve1_ID, mux_valve2_ID, ob1_com_port, flow_control=1):

        # load in data structures
        numpy_path = experiment_path + '/' + 'np_arrays'

        try:
            os.chdir(numpy_path)
        except:
            os.mkdir(experiment_path)
            os.mkdir(numpy_path)
            os.chdir(numpy_path)

        fluid_info_array = np.zeros(3)
        file_name = 'fluid_info_array.npy'
        np.save(file_name, fluid_info_array)

        self.experiment_path = experiment_path
        self.experiment_directory = experiment_path
        self.flow_control = flow_control
        self.ob1_com_port = ob1_com_port

        self.valve1_ID = mux_valve1_ID
        self.valve2_ID = mux_valve2_ID

        self.pressure_on = 1000
        self.pressure_off = 0
        self.flow_on = 500
        self.flow_off = -3

        return

    def fluidics_logger(self, function_used_string, error_code, value_sr):
        experiment_directory = self.experiment_path
        filename = 'logger.xlsx'
        logger_path = experiment_directory + '/fluidics data logger'
        os.chdir(experiment_directory)
        try:
            os.mkdir('fluidics data logger')
            os.chdir(logger_path)
        except:
            os.chdir(logger_path)

        if os.path.isfile(filename) == True:
            wb = load_workbook(filename)
            ws = wb.active
        elif os.path.isfile(filename) == False:
            wb = Workbook()
            ws = wb.active
            # add headers
            ws.cell(row=1, column=1).value = 'Time Stamp'
            ws.cell(row=1, column=2).value = 'Function Used'
            ws.cell(row=1, column=3).value = 'Error Code'
            ws.cell(row=1, column=4).value = 'Value Sent/Recieved'

        # determine row number (add to next line as a logged event)
        current_max_row = ws.max_row
        row_select = current_max_row + 1

        # add in values
        ws.cell(row=row_select, column=1).value = datetime.datetime.now()
        ws.cell(row=row_select, column=2).value = function_used_string
        ws.cell(row=row_select, column=3).value = error_code
        ws.cell(row=row_select, column=4).value = value_sr

        wb.save(filename)

    def mux_end(self):

        error = MUX_DRI_Destructor(self.mux_ID)
        self.fluidics_logger(str(MUX_DRI_Destructor), error, 0)

    def valve_select(self, valve_number):
        '''
        Moves to desired vial number via 2 hamilton valves
        Parameters
        ----------
        valve_number

        Returns
        -------

        '''

        mux = hamilton_mvp4.AValveChain()
        mux.vialChoose(valve_number, self.valve1_ID, self.valve2_ID)

    def flow(self, on_off_state):

        # load in data structures
        numpy_path = self.experiment_directory + '/' + 'np_arrays'
        os.chdir(numpy_path)
        file_name = 'fluid_info_array.npy'
        fluid_array = np.load(file_name, allow_pickle=False)

        run = 1

        while run != 0:

            # disable doing a rerun
            run = 0

            #set target to achieve
            if self.flow_control == 1 and on_off_state == 'ON':
                set_target = self.flow_on
            if self.flow_control == 1 and on_off_state == 'OFF':
                set_target = self.flow_off
            if self.flow_control == 0 and on_off_state == 'ON':
                set_target = self.pressure_on
            if self.flow_control == 0 and on_off_state == 'OFF':
                set_target = self.pressure_off
            set_target_c_types = c_double(set_target)  # convert to c_double


            set_channel = int(1)  # convert to int
            set_channel = c_int32(set_channel)  # convert to c_int32

            # OB1_Start_Remote_Measurement(self.pump_ID, self.calibration_array, 1000)
            error = OB1_Set_Remote_Target(self.pump_ID, set_channel, set_target_c_types)
            self.fluidics_logger(str(OB1_Set_Remote_Target), error, set_target)

            data_sens = c_double()
            data_reg = c_double()
            set_channel = int(1)  # convert to int
            set_channel = c_int32(set_channel)  # convert to c_int32
            time.sleep(3) # wait 3 seconds to stabilize
            error = OB1_Get_Remote_Data(self.pump_ID, set_channel, byref(data_reg), byref(data_sens))

            if self.flow_control == 1:
                current_flow_rate = data_sens.value
            else:
                current_flow_rate = data_reg.value

            self.fluidics_logger(str(OB1_Get_Remote_Data), error, current_flow_rate)

            #error = OB1_Get_Remote_Data(self.pump_ID, set_channel, byref(data_reg), byref(data_sens))
            #current_flow_rate = data_sens.value
            #self.fluidics_logger(str(OB1_Get_Remote_Data), error, current_flow_rate)

            if self.flow_control == 1:

                if set_target > 400 and current_flow_rate < 0.1 * set_target:
                    #self.flow_control = 0

                    #set_channel = int(1)
                    #set_channel = c_int32(set_channel)  # convert to c_int32
                    #error = PID_Set_Running_Remote(self.pump_ID, set_channel, 0) # turn off PID loop
                    #self.fluidics_logger(str(PID_Set_Running_Remote), error, 0)

                    #run = 1 # restart flow function
                    fluid_array[2] = 1

                if set_target< 40 and current_flow_rate > 100:
                    #self.flow_control = 0

                    #set_channel = int(1)
                    #set_channel = c_int32(set_channel)  # convert to c_int32
                    #error = PID_Set_Running_Remote(self.pump_ID, set_channel, 0) # TURN OFF pid LOOP
                    #self.fluidics_logger(str(PID_Set_Running_Remote), error, 0)

                    #run = 1 # restart flow function
                    fluid_array[2] = 1

            else:
                pass

    def flow_checker(self):

        self.file_run('raspberry_wifi_connect.py')
        self.file_run('flow_check.py')

    def ob1_end(self):

        start = time.time()
        error = OB1_Destructor(self.pump_ID)
        self.fluidics_logger(str(OB1_Destructor), error, 0)
        end = time.time()
        print('destruction time', end - start)

    def ob1_start(self):

        start = time.time()
        # OB1 initialize
        ob1_path = 'ASRL' + str(self.ob1_com_port) + '::INSTR'
        Instr_ID = c_int32()
        error = OB1_Initialization(ob1_path.encode('ascii'), 0, 0, 0, 0, byref(Instr_ID))
        self.fluidics_logger(str(OB1_Initialization), error, 0)
        error = OB1_Add_Sens(Instr_ID, 1, 5, 1, 0, 7,0)  # 16bit working range between 0-1000uL/min, also what are CustomSens_Voltage_5_to_25 and can I really choose any digital range?
        self.fluidics_logger(str(OB1_Add_Sens), error, 0)

        Calib_path = r'C:\Users\CyCIF PC\Documents\GitHub\AutoCIF\Python_64_elveflow\calibration\1_12_24_cal.txt'
        Calib = (c_double * 1000)()
        # Elveflow_Calibration_Load(Calib_path.encode('ascii'), byref(Calib), 1000)
        error = Elveflow_Calibration_Default(byref(Calib), 1000)
        self.fluidics_logger(str(Elveflow_Calibration_Default), error, 0)

        if self.flow_control == 1:

            set_channel_regulator = int(1)  # convert to int
            set_channel_regulator = c_int32(set_channel_regulator)  # convert to c_int32
            set_channel_sensor = int(1)
            set_channel_sensor = c_int32(set_channel_sensor)  # convert to c_int32
            error = PID_Add_Remote(Instr_ID.value, set_channel_regulator, Instr_ID.value, set_channel_sensor, 0.9, 0.004, 1)
            self.fluidics_logger(str(PID_Add_Remote), error, 0)
        else:
            pass

        error = OB1_Start_Remote_Measurement(Instr_ID.value, byref(Calib), 1000)
        self.fluidics_logger(str( OB1_Start_Remote_Measurement), error, 0)
        self.calibration_array = byref(Calib)

        self.pump_ID = Instr_ID.value
        end = time.time()
        print('initialize time', end - start)

    def file_run(self, file_name):

        if file_name == 'raspberry_wifi_connect.py':
            # run wifi connect file
            os.chdir(r'C:\Users\CyCIF PC\Documents\GitHub\AutoCIF\Software')
            call(["python", file_name])
        else:
            # load in data structures
            numpy_path = self.experiment_directory + '/' + 'np_arrays'
            os.chdir(numpy_path)
            np_file_name = 'fluid_info_array.npy'
            fluid_array = np.load(np_file_name, allow_pickle=False)


            #set initial value to 0 which indicates that no failure has happened
            fluid_array[2] = 0
            np.save(np_file_name, fluid_array)

            # set value to 0 indicating that the file has not been run yet
            fluid_array[1] = 0
            np.save(np_file_name, fluid_array)

            #run fluidics function
            os.chdir(r'C:\Users\CyCIF PC\Documents\GitHub\AutoCIF\Software')
            call(["python", file_name, self.experiment_directory])

            time.sleep(10)

            # load in data structures
            os.chdir(numpy_path)
            fluid_array = np.load(np_file_name, allow_pickle=False)
            rerun = fluid_array[2]
            file_run = fluid_array[1]

            while rerun == 1 or file_run == 0:

                # set initial value to 0 which indicates that no failure has happened
                os.chdir(numpy_path)
                fluid_array[2] = 0
                np.save(np_file_name, fluid_array)

                # set value to 0 indicating that the file has not been run yet
                fluid_array[1] = 0
                np.save(np_file_name, fluid_array)

                os.chdir(r'C:\Users\CyCIF PC\Documents\GitHub\AutoCIF\Software')
                call(["python", file_name, self.experiment_directory])

                # load in data structures
                os.chdir(numpy_path)
                fluid_array = np.load(np_file_name, allow_pickle=False)
                rerun = fluid_array[2]
                file_run = fluid_array[1]
                print('rerun', rerun)

    def liquid_action(self, action_type, stain_valve=0, incub_val=45, heater_state=0, microscope_object = 0, experiment_directory = 0, cycle = 0):

        bleach_valve = 11
        pbs_valve = 12
        bleach_time = 10  # minutes
        stain_flow_time = 45  # seconds
        if heater_state == 0:
            stain_inc_time = incub_val  # minutes
        if heater_state == 1:
            stain_inc_time = 45  # minutes
        nuc_valve = 4
        nuc_flow_time = 45  # seconds
        nuc_inc_time = 3  # minutes

        self.file_run('raspberry_wifi_connect.py')

        flow_rate = "ON"
        flow_rate_stop = 'OFF'


        #flow_control = self.flow_control

        #if flow_control != 1:
        #    flow_rate = 1100
        #    flow_rate_stop = 0
        #else:
        #    pass

        if action_type == 'Bleach':


            self.valve_select(bleach_valve)
            time.sleep(2)
            self.flow_checker()
            self.file_run('bleach.py')

            for x in range(0, bleach_time):
                time.sleep(60)

            self.valve_select(pbs_valve)

            self.file_run('raspberry_wifi_connect.py')

            time.sleep(2)
            self.flow_checker()
            self.file_run('wash.py')

        elif action_type == 'Stain':

            stain_start = 0

            self.valve_select(stain_valve)
            time.sleep(2)
            self.flow_checker()
            self.file_run('stain.py')
            self.valve_select(pbs_valve)
            time.sleep(2)

            if microscope_object != 0:
                microscope = microscope_object

                time_elapsed = microscope.recursive_stardist_autofocus(experiment_directory, cycle)  # int time in seconds
                whole_minutes_elapsed = math.floor(time_elapsed/60)
                seconds_remaining = time_elapsed % 60 # remainder in seconds of time remaining after dividing by 60
                print(seconds_remaining)
                time.sleep(seconds_remaining)
                stain_start = int(whole_minutes_elapsed + 1)

            for x in range(stain_start, stain_inc_time):
                time.sleep(60)
                print('Staining Time Elapsed ', x)

            #do double wash as unspecifically bound antibodies come off over time in single wash

            self.valve_select(pbs_valve)

            self.file_run('raspberry_wifi_connect.py')

            self.flow_checker()
            self.file_run('wash.py')


            # if heater_state == 1:
            #    arduino.heater_state(0)
            #    arduino.chamber('fill')
            # else:
            #    pass

        elif action_type == 'Stain_flow_on':

            self.valve_select(stain_valve)
            time.sleep(2)
            self.flow_checker()
            self.file_run('stain.py')
            self.valve_select(pbs_valve)
            time.sleep(2)


        elif action_type == "Wash":

            self.valve_select(pbs_valve)
            time.sleep(2)
            self.flow_checker()
            self.file_run('wash.py')


        elif action_type == 'Nuc_Touchup':

            self.valve_select(nuc_valve)
            self.flow(500)
            time.sleep(nuc_flow_time)
            self.flow(0)
            time.sleep(nuc_inc_time * 60)

            self.valve_select(pbs_valve)
            self.flow(450)
            time.sleep(70)
            self.flow(0)

        elif action_type == 'low flow on':

            self.valve_select(pbs_valve)
            self.file_run('low_flow_start.py')

        elif action_type == 'flow off':

            self.file_run('low_flow_stop.py')
