mdanderson03/SpectrePlex/(commit log)

2022-03-23 Create reflection comparision 3_23_22.xlsx
    made excel sheet for reflection data
    [reflection comparision 3_23_22.xlsx]
2022-03-23 Update reflection comparision 3_23_22.xlsx
    [reflection comparision 3_23_22.xlsx]
2022-03-30 3_31_22 experiment notes
    notes for 3_31 trial run
    [stain order.xlsx]
2022-03-31 notes on 3_31-22 trial
    notes on trial run. Got stuck on autofocus and tiling issues w/ micromagellen
    [autocif.py]
2022-04-19 added MM config
    added MM config file and a merged copy of the 'use this' file.
    [auto_cycif.cfg]
2022-04-29 corrected tilt
    I made a mistake with how to implement the tilt correction. It now works properly.
    [autocif.py]
2022-05-05 fixed code
    fixed arduino class code in python software. experiment 5_5_22 day one done.
    [autocif.py, testing.py]
2022-05-19 dye kinetics
    added dye kinetics experiment info
    [2 cycle bleaching analysis.xlsx, curtipot_CyCIF_dyes_bleach.xlsm, exact_mixes.xlsx, incubation time intensity analysis.xlsx, nanosite abs a647 a594.xlsx, staining time analysis aug 2021.xlsx]
2022-05-19 5_19_22 kinetics
    dye kinetics 5_19-22 data and notes
    [exact_mixes.xlsx]
2022-06-03 6_3_22 autocif
    updated few issues with long range z method
    [autocif.py, testing.py, use_this.py]
2022-06-10 CAD model and singlet oxygen
    CAD model on Chamber 3.0 and papers on singlet oxygen
    [chamber_v3_0.FCStd]
2022-06-15 arduino sketch 3.0
    made arduino sketch for chamber V3.0
    [chamber_v3_0.FCStd]
2022-06-15 Update Serial Command Decoder for chamber V3.0.docx
    updated the decoding sheet for the new arduino code
2022-06-15 python chamber V3.0 update
    updated all autocif code to handle new chamber and arduino codes. Mostly added ability to update focused surface z positions and check if they exist before creating. Also, arduino now uses commands from decoding sheet V3.0
    [chamber_v3_0-Chamfered outer chamber_stl.stl]
2022-06-16 adding printing models
    added all models for printing
    [Base (1).stl, Jig Body (1).stl, Jig Lid (1).stl, Shaft (1).stl, chamber_v3_0-Chamfered outer chamber_stl.stl]
2022-06-16 new sla models and protocol
    made new sliced up models for sla printer and made manual protocol for cycif
2022-06-17 V3.1 chamber
    Started changes on V3.1 chamber
    [chamber_v3_1-Chamfered inner chamber_stl.stl, chamber_v3_1.FCStd]
2022-06-21 print files
    updates shaft and base print files for SLA printer
2022-06-28 V3.3 chamber
    Made V3.3 chamber with updated logs and 3D print file.
    [chamber_v3_1-Chamfered Outer chamber_stl.stl, chamber_v3_1-Chamfered inner chamber_stl.stl, chamber_v3_1.FCStd, chamber_v3_1_sealed-Chamfered inner chamber_stl.stl, chamber_v3_2.FCStd, chamber_v3_2_Chamfered inner chamber_stl.stl, chamber_v3_3-Chamfered outer chamber.stl, chamber_v3_3.FCStd]
2022-06-30 board enclosure and autoexpose
    main housing for V1.0 board enclosure is completed. Just need attachment bracket. Code for autoexpose before autofocus is completed. Commenting and function descriptions need updated badly.
    [chamber_v3_3-Chamfered inner chamber.stl, chamber_v3_3.FCStd, control board housing V1.0-housing with screw term and socket.stl, control board housing V1.0-psu housing.stl, control board housing V1.0.FCStd]
2022-07-01 v4.0 chamber
    [chamber_v4_0.FCStd]
2022-07-06 model update and data analysis
    did model update to V3.3 (minor tweaks) and started analysis of kinetics
    [chamber_v3_3-Chamfered outer chamber.stl, chamber_v3_3.FCStd]
2022-07-07 presentation
    July 2022 update presentation
    [chamber_v3_3-Chamfered inner chamber.stl]
2022-07-07 presentation update and exposure partial fix
    fixing exposure auto issues and made more updates to prsentation
    [autocif.py, testing.py, use_this.py]
2022-07-12 model tweaks
    [chamber_v3_3-Chamfered inner chamber_0.9 gap.stl, chamber_v3_3-Chamfered inner chamber_1 gap closed.stl, chamber_v3_3-Chamfered inner chamber_1 gap.stl, chamber_v3_3-Chamfered inner chamber_1.1 gap closed.stl]
2022-07-12 final auto expose
    made final adjustments and confirmed that auto exposure is working correctly.
    [testing.py]
2022-07-19 documentation
    made documentation in power points and minor tweaks to chamber
    [chamber_v3_4-_inner_chamber.stl, chamber_v3_4-inner_chamber_high slide.stl, chamber_v3_4-outer chamber _small opening.stl, chamber_v3_4-outer chamber.stl, chamber_v3_4-slde plateau.stl, chamber_v3_4.FCStd]
2022-07-21 V3.5 chamber
    [chamber_v3_5-inner chamber no window.stl, chamber_v3_5.FCStd, chamber_v3_5_inner part of outer chamber.stl]
2022-07-25 V3.5 done
    completed CAD and changelog for V 3.5 model
    [chamber_v3_5-inner bottom chamber.stl, chamber_v3_5-top inner chamber.stl, chamber_v3_5.FCStd]
2022-08-02 autocif program
    notes on autofocus repeatibility and fixed one aspec tof new surface naming
    [data.xlsx]
2022-08-11 8_11_22 kinetcis
    added A488 bleaching kinetics experimental data
    [100nM.xlsx, 10nM.xlsx, 1mM good.xlsx, a488_100um_1.xlsx, a488_100um_2.xlsx, a488_10mm.xlsx, a488_10um.xlsx, a488_1mm.xlsx]
2022-08-12 8_11_22 analysis
    Fully analyzed 8_11_22 dataset of A488 decays kinetics with mCPBA
    [a488_100um_2.xlsx, a488_10mm.xlsx, a488_10um.xlsx, a488_1mm.xlsx, a488_5mM.xlsx, control board housing V1.0- back panel housing.stl, control board housing V1.0-housing with mounting hexnuts, BNC ports and back panel socket.stl]
2022-08-17 jigs creation and slide bleach notes
    Made jigs for inner chamber window and strarted notes for bleach on slide experiment
    [chamber_v3_6-gasket cut jig.stl, chamber_v3_6-top inner chamber_abs.stl, chamber_v3_6-window cut jig.stl, chamber_v3_6-window install jig.stl, chamber_v3_6.FCStd, chamber_v3_6_w_SLA_inner_upper.FCStd]
2022-08-17 pole clamp
    made pole clamp cad drawing for elecrtonics enclosure
    [control board housing V1.0-pole clamp.stl, control board housing V1.0.FCStd]
2022-08-18 made new stl files
    [chamber_v3_6-inner bottom chamber.stl, chamber_v3_6.FCStd]
2022-08-29 3d model
    3D model for manual slide basin
    [chamber_v3_7.FCStd, manual_chamber v1_0-chamber.stl, manual_chamber v1_0-lid.stl, manual_chamber v1_0-slide secure level.stl, manual_chamber v1_0.FCStd]
2022-09-06 8_29_22 analysis
    Analyzed 8_29_22 experiement
    [data.xlsx]
2022-09-08 added h2o2 vs mcpba experiment
    just start of analysis slideshow
    [manual_chamber v1_0-chamber.stl, manual_chamber v1_0.FCStd]
2022-09-13 presentation pressure
    presentation on pressure concerns for microfluidic device
    [manual_chamber v1_0-chamber.stl, manual_chamber v1_0.FCStd]
2022-09-16 accessories
    finsished V1.0 for eppendorf holder and mounting bracket for pinch valve system
    [chamber_v3_8.FCStd, eppendorf_mount V1.0-Parteppendorf enclosure shroud.stl, eppendorf_mount V1.0.FCStd, pinch bracket V1_0.stl]
2022-09-19 tweak parameters
    tweaked parameters of holder and mount 3D models
    [eppendorf_mount V1.0-Reservior Tube Holdereppendorf enclosure shroud.stl, eppendorf_mount V1.0-eppendorf holder.stl, eppendorf_mount V1.0-support rod mount.stl, eppendorf_mount V1.0.FCStd]
2022-09-23 chamber V4.0
    chamber 4.0 initial design and updated log
    [a488_h2o2_mcpba.xls, a488_h2o2_single.xls, a532_h2o2_mcpba.xls, a546_h2o2_mcpba.xls, a555_h2o2_mcpba.xls, a568_h2o2_mcpba.xls, a647_h2o2_mcpba.xls, chamber_v4_0 inner chamber.stl]
2022-09-26 photomask
    made dxf file for photomask for fluidic chamber V1.0. Also made PP for details.
    [microfluidic chamber V1_0 photomask.dxf, microfluidic chamber V1_0.FCStd]
2022-10-06 photomasks
    3d photomask updated files
    [a488.ods, a532.ods, a546.ods, a555.xls, a568.ods, a594.ods, a647.ods, microfluidic chamber V1_0-mask 1.dxf]
2022-10-07 10-7-22 experiment dye bleach
    dye bleach LiBH4, H2O2, mCPBA
    [A488.ods, A488.xls, A532.xls, A546.xls, A555.xls, A568.xls, A594.xls, A647.xls]
2022-10-11 photomask
    made filter system on photomasks and made all 6 photomasks. No filter versions, filtered version, shortened version. Update PP about it too.
    [microfluidic chamber V1_0-mask 3.dxf, microfluidic chamber V1_0-mask 4.dxf, microfluidic chamber V1_0-mask 5.dxf, microfluidic chamber V1_0-mask 6.dxf, microfluidic chamber V1_0.FCStd]
2022-10-12 10-11-22 kinetics experiment
    finished analysis for multidye kinetics with h2o2, mcpba and libh4
    [A488.ods, A488.xls, A532.xls, A546.xls, A555.xls, A568.xls, A594.xls, A647.xls]
2022-10-12 reorganize 10-11-22
    made data folder for 10-11-22 experiment
    [A488.xls, A532.xls, A546.xls, A555.xls, A568.xls, A594.xls, A647.xls, stdev and mean calcuation table.xlsx]
2022-10-12 Update Dye Kinetics H2O2 vs mCPBA vs LiBH4 analysis.pptx
    added slide for 10-11-22 experiment for filter settings
2022-10-12 Update Dye Kinetics H2O2 vs mCPBA vs LiBH4 analysis.pptx
    added A488 filter parameters to 10-11-22 slideshow
2022-10-12 photomask final
    moved filter up 3mm in photomask 3 and 4
    [microfluidic chamber V1_0-mask 3.dxf, microfluidic chamber V1_0-mask 4.dxf, microfluidic chamber V1_0.FCStd]
2022-10-14 V4.0 update
    updated V4.0 chamber for modified set screw sockets. Now have socket for set screw and small socket to firmly fit cylinder magnet. Made new stl for inner chamber as well.
    [chamber_v4_0-inner chamber with mag set screw sockets.stl, chamber_v4_0-inner chamber.stl, chamber_v4_0-outer chamber.stl, chamber_v4_0.FCStd]
2022-10-17 pinch valve mount
    bread board mount model for pinch valve system
    [chamber_v4_0.FCStd, eppendorf_mount V1.0.FCStd, eppendorf_mount breadboard socket V1.0.stl, peristaltic pump breadboard mount.FCStd, pump zip attachment.stl]
2022-10-20 v4.0 changes
    made model for SLA printing and strunk inner chamber.
    [chamber_v4_0-inner chamber.stl, chamber_v4_0-outer chamber.stl, chamber_v4_0.FCStd, chamber_v4_0_recovered.FCStd, eppendorf_mount V1.0.FCStd, eppendorf_mount breadboard socket V1.0.stl]
2022-10-25 arduino sketch
    updated arduino sketch for wifi MQTT usage and V3.0 control board
    [chamber_v4_0_outer chamber.stl]
2022-10-31 sensor clip
    replicated sensor clip for fluid flow rate
    [chamber_v4_0_recovered.FCStd, sensor module-sensor holderbase.stl, sensor module.FCStd]
2022-10-31 sensor supportq
    finished dimensions for ABS prints of sensor support
    [sensor module-sensor holderbase_4.6.stl, sensor module-sensor holderbase_4.7.stl, sensor module.FCStd]
2022-10-31 autocyplex code
    added new functions to set micromagellan surfaces and acquistion events with autofocus only happening in the center tile and applying to the rest of the tiles. Also new function to acquire every event.
    [control board housing V1.0-complete bracket breadboard.stl, control board housing V1.0.FCStd, peristaltic pump breadboard mount-motor mountplate with bolts and zip channel.stl]
2022-11-18 fluid system
    [flow rate.xlsx, fluid.xlsx]
2022-11-21 eppendorf mount v1.1
    swapped tabs to opposite side on eppendorf mount.
    [eppendorf_mount V1.1-Reservior Tube Holdereppendorf enclosure shroud.stl, eppendorf_mount V1.1.FCStd]
2022-11-22 arduino code
    added python code to control arduino system.
2022-11-30 autocyplex
    updated autocyplex code. Issues with time delays and surface_acq functions
    [V3_0 program.py, autocif.py]
2022-12-01 11-30-22 fluidics stain test
    added data and analysis power point
    [data.xlsx]
2022-12-05 V4.1 chamber
    made V4.1 chamber, design log and printed file
    [chamber_v4_0_pressure_arm.stl, chamber_v4_0_recovered.FCStd, chamber_v4_1-Chamberouter chamber.stl, chamber_v4_1.FCStd]
2022-12-07 pressure plate V4.1 chamber
    pressure plate for V4.1 chamber added
    updated code for expose method
    [chamber_v4_1.FCStd]
2022-12-07 try loop client
    made try except loop for client connection for arduino
2022-12-09 v4.1 chamber
    new print gcode for v4.1 chamber
    [chamber_v4_1-Chamber.stl, chamber_v4_1-arc pressure armentire pressure plate.stl, chamber_v4_1-pressureplate.stl, chamber_v4_1.FCStd]
2022-12-21 chamber v5.0
    chamber v5.0 guidelines
    [chamber_v4_1.FCStd]
2023-01-05 floor meeting
    floor meeting presentation
    [data.xlsx]
2023-01-30 chamber V4.2 focus map stain
    made chamber v4.2 where inner chamber is fused instead of kinematic
    fully implemented focus map array
    [chamber_v4_2-ChamberFusion016.stl, chamber_v4_2.FCStd]
2023-01-31 Create Chamber V5.0.pptx
2023-02-01 core snap
    made new acquistion mode that is built around core snap and making bigtiff files from them.
    [chamber_v4_2-arc pressure armentire pressure plate.stl]
2023-02-02 chamber V5.0 model
    made base model for chamber V5.0
    [chamber V5.0.FCStd, chamber_v4_2-arc pressure armentire pressure plate.stl, chamber_v4_2.FCStd]
2023-02-02 core snap method
    final touches on core snap method
    [testing.py]
2023-02-13 new stuff
    [chamber V5.0.FCStd]
2023-02-21 notes and protocols
    [antibody validation results.xlsx, data.xlsx]
2023-02-22 antibody validation experiment
    added protocol and notes for antibody validation experiment
    [antibody validation results.xlsx, chamber V5.0-Pressure Platepressure plate body.stl, chamber V5.0-Pressure Platepressure plate body_3mm_riser_3mm_mag.stl, chamber V5.0-Pressure Platepressure plate body_3mm_sockets.stl, chamber V5.0-Pressure Platepressure plate body_7mm_sockets.stl, chamber V5.0.stl]
2023-02-22 fluidic stain flow
    analysis of fluidic stain flow 2_16_23 experiment
2023-02-22 Update test_run.py
    coded core snap bracketed flow rate experiment
2023-03-02 antibody validation
    [antibody validation results.xlsx]
2023-03-14 Update autocyplex.py
    added metadata insert into file save
2023-04-19 V5.1 chamber
    Added in generic model features for V5.1 chamber
    [chamber V5.1.FCStd]
2023-04-25 MUX code
    added Elveflow MUX code
    [microfluidic chamber V1_0.FCStd]
2023-04-25 added parts and drawings
    Added all extra parts and stage for V5.1 chamber and started technical drawings
    [chamber V5.1.FCStd]
2023-04-25 altered file extension
    [chamber V5.1 (2).FCStd]
2023-05-02 v5.1 update
    added in aligment jig for chamber V5.1 and updated autocif code with OB1 functions
    [chamber V5.1.FCStd]
2023-05-10 v2.0 eppendorf mount
    made eppenddorf mount handle new pressure connector system and hold 50mL tube
    [chamber V5.1.FCStd, eppendorf_mount V2.0-holder.stl, eppendorf_mount V2.0-mount_plate.stl, eppendorf_mount V2.0.FCStd]
2023-05-15 model update
    [chamber V5.1-ChamberMain Body.stl, chamber V5.1-Pressure Platepressure plate body.stl, chamber V5.1-align_jig.stl, chamber V5.1.FCStd]
2023-05-15 updated elveflow code and version
    [chamber V5.1-chamber.stl, chamber V5.1.FCStd, mux_platform_v1.0-PartMUX Platform.stl, mux_platform_v1.0.FCStd]
2023-05-17 flow recorder spectrum method
2023-06-07 evle flow test 2
2023-08-14 bubble trap theory
    [bubble trap data (version 1).xlsb.xlsx, bubble trap data.xlsx]
2023-08-31 altered post processing
    made some bug fixes to post processing functions
    [use_this.py]
2023-09-27 auto focus updates
    [chamber V5.1-Pressure Platepressure plate body.step]
2023-09-28 bunch of stuff
    [chamber V5.1_aluminum.FCStd]
2023-10-03 software folder
    created software folder
    [eppendorf_mount V3.0.FCStd]
2023-10-06 aluminum pressure plate
    [chamber V5.1-Pressure Platepressure plate body.step, chamber V5.1_aluminum.FCStd]
2023-10-06 mount V3.0
    Made V3.0 eppendorf holder
    [eppendorf_mount V3.0.FCStd]
2023-10-13 eppendorf V3.0
    [eppendorf_mount V3.0-Slice.1.stl, eppendorf_mount V3.0.FCStd, eppendorf_mount V3.0.stl, eppendorf_mount_plate V3.0.stl]
2023-10-16 Update autocyplex.py
    added in verification to valve change function
2023-10-16 valve verifier
2023-10-25 3d model
    [chamber V5.1-right jigBody.stl, chamber V5.1.FCStd]
2023-10-25 updated offsets
    [17-10-23_offsets.xlsx]
2023-11-17 autoexpose update
    updated reduced frame in x dimension for autoexpose
2023-11-27 UPDATED autoback ground remove
2023-11-30 frame size crop aftrer acquire
2023-12-06 recursive autofocus
    implemented recursive autofocus with stardist filter. See markup file for more info.
2023-12-06 minor bugs
    corrected minor bugs with recursive autofocus
    [use_this.py]
2024-01-24 Create junk.py
    junk filter for auto exposure
2024-01-25 return form added
    [2-Return Merchandise Authorization RMA-220610_pump.xlsx]
2024-01-31 couple tweaks to autocyplex
2024-01-31 fixed tissue binary generate
    [use_this.py]
2024-01-31 revert calibration fluidics
2024-02-05 update flow
2024-02-06 Update autocyplex.py
    added in method to stage coord stitch star dist images together
2024-02-06 added tissue filter
2024-02-06 fixed fluidics
    fixed fluidics. Pausing and unpausing PI loop broke function
    [use_this.py]
2024-02-07 exposure power point
2024-02-07 file organization
    broke classes down into separate files and autocyplex now loads all in together
    [arduino.py, microscope.py]
2024-02-08 new fluidic form and bio133 device
    made new form for window in fluidic device and outline for bio133 device
    [window form fluidic device V1.1.FCStd]
2024-02-09 new fluidic chamber
    [window form fluidic device V1.1-Body.stl, window form fluidic device V1.1.FCStd]
2024-02-14 logger and pressure mode
    added in logger and ability to run in pressure mode
2024-02-20 Update fluidics.py
    fully integrated pressure based fluidics
2024-02-20 new arduino code
2024-02-20 heater update
2024-02-26 autoexp and acquistion eninge fix
    made acquired images go through nan_to_num function and sped of z stakc acquistion. Also made presentaation on auto exp.V2.0
    [microscope.py]
2024-02-27 upped bleach time and flow time
2024-03-06 Squashed commit of the following:
    commit f71c61edb9c446fe91141a4c9d9ed5773b10a2d6
    Author: mdanderson03 <md.anderson03@gmail.com>
    Date: Wed Mar 6 14:50:46 2024 -0500
    fluid switch bug fixes
    commit dba4f46b68300a1452de8f8a6229eae8e6c86c3c
    Author: M.D. Anderson <48689483+mdanderson03@users.noreply.github.com>
    Date: Wed Mar 6 14:12:46 2024 -0500
    Update fluidics.py
    added in ability to auto switch to pressure mode from fluid flow made
    commit 015da318b2a81c747b14d05ee6903e20506aa626
    Author: mdanderson03 <md.anderson03@gmail.com>
    Date: Wed Mar 6 13:18:33 2024 -0500
    updarte
    commit 098dde22f733320796f9484aad9dbb6db85e400c
    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
    [junk.py, microscope.py, use_this.py]
2024-03-11 Update microscope.py
    reversed order of operation on BaSiC and background sub
    [microscope.py]
2024-03-13 Update microscope.py
    tissue exist added to brightness corrector
    [microscope.py]
2024-04-11 update
    added in rerun feature for fluidics
    [stain_action_log.xlsx]
2024-05-13 frame adjuster
2024-05-13 Update microscope.py
    partial add cluster filter
2024-05-28 added new alignment jig for V5.2 chamber
    [chamber V5.2_aluminum.FCStd]
2024-05-29 fix issue with parent folder generation
    [chamber V5.2_aluminum-alignment jigBody008.stl, chamber V5.2_aluminum.FCStd]
2024-05-29 new jig for gutage
    [chamber V5.2_aluminum-alignment jigBody008.stl, chamber V5.2_aluminum.FCStd]
2024-05-30 acquire and focus updater for dapi
    [chamber V5.2_aluminum.FCStd]
2024-06-04 jig update
    [chamber V5.2_aluminum.FCStd]
2024-06-05 model updates
    [chamber V5.2.stl, chamber V5.2_aluminum-alignment jigBody008.stl, chamber V5.2_aluminum.FCStd]
2024-06-10 new brightness uniformer
    [V5.2_jig.stl]
2024-09-26 updates 092624
    [logger.xlsx]
2024-10-07 dark frame update
2024-11-06 add in print for focusing
2025-01-03 mux update
    made default valve switching go to move to different valve and back to desired valve
2025-01-07 added delete sub processing folders
    [kinetics summary.xlsx]
2025-01-15 Create SpectrePlex Heater V2.pptx
2025-01-28 widen model for eye slide
    [chamber eye sllide V5.3_aluminum.FCStd]
2025-03-13 reprogram ob1 reboot
    split into two methods and initiated lass separately
    [KasaSmartPowerStrip.py, flat_illumination.py, microscope.py, ob1.py, poisson_error.py, use_this.py, wash.py]
2025-04-04 Create Commercial Prototype Production.pptx
2025-04-09 3d update
    [prototype_upper_mold_jig-Body.stl, prototype_upper_mold_jig.FCStd, prototype_upper_mold_jig_closed-Body.stl, prototype_upper_mold_jig_closed.FCStd, prototype_upper_mold_window_form.stl]
2025-04-10 new 3D design
    [commercial_pp_V1.0.FCStd]
2025-05-16 added valve control files
    added valve control files for Hamilton MVP/4 valves from jeff moffitts strom-control github
2025-05-16 Update fluidics_V3.py
    Added in control over hamilton MVP/4 valves
